weiweiweiopen/teensy-4-RGBgalvos/hardware/revB/preview/placement-top.png

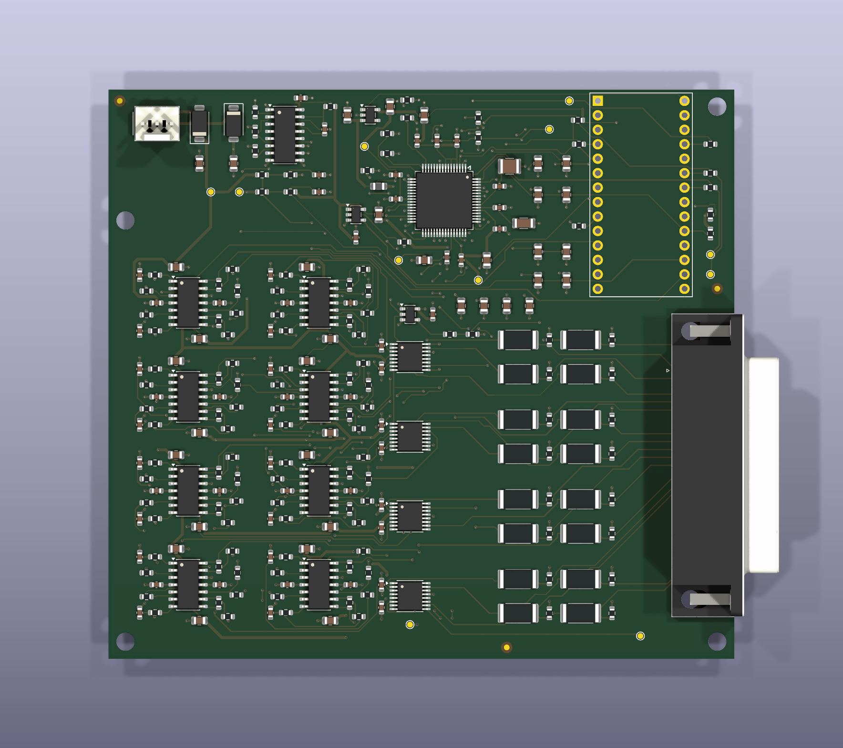
hardware/revB/preview/placement-top.png
