weiweiweiopen/teensy-4-RGBgalvos/hardware/revB/preview/floorplan.png

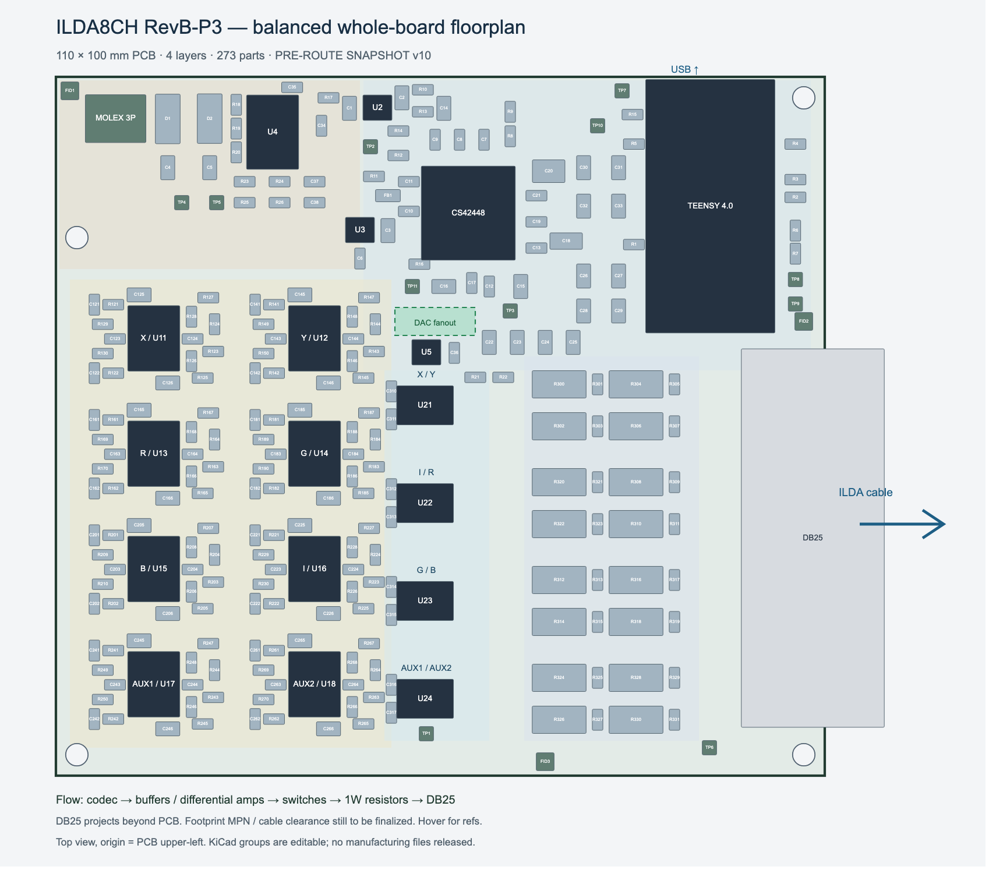
hardware/revB/preview/floorplan.png
