weiweiweiopen/teensy-4-RGBgalvos/hardware/revB/preview/kicad-pcb-editor.png

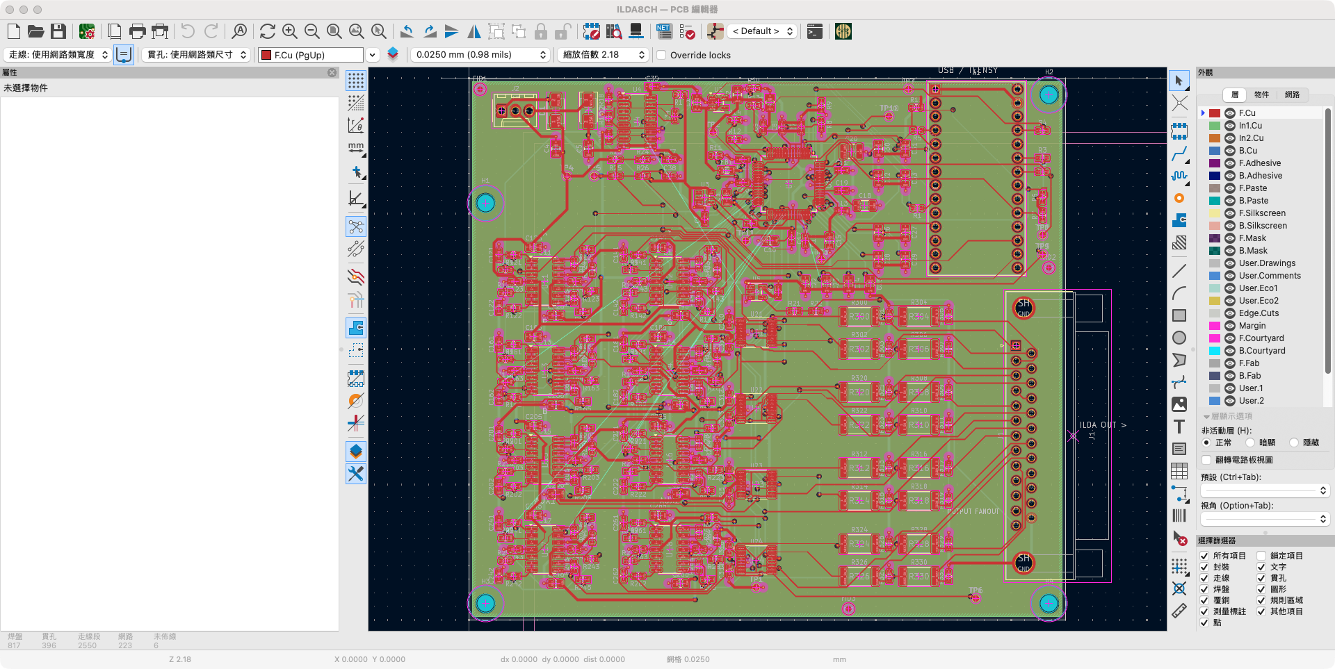
hardware/revB/preview/kicad-pcb-editor.png
