weiweiweiopen/teensy-4-RGBgalvos/hardware/revB/preview/power-eco-top.png

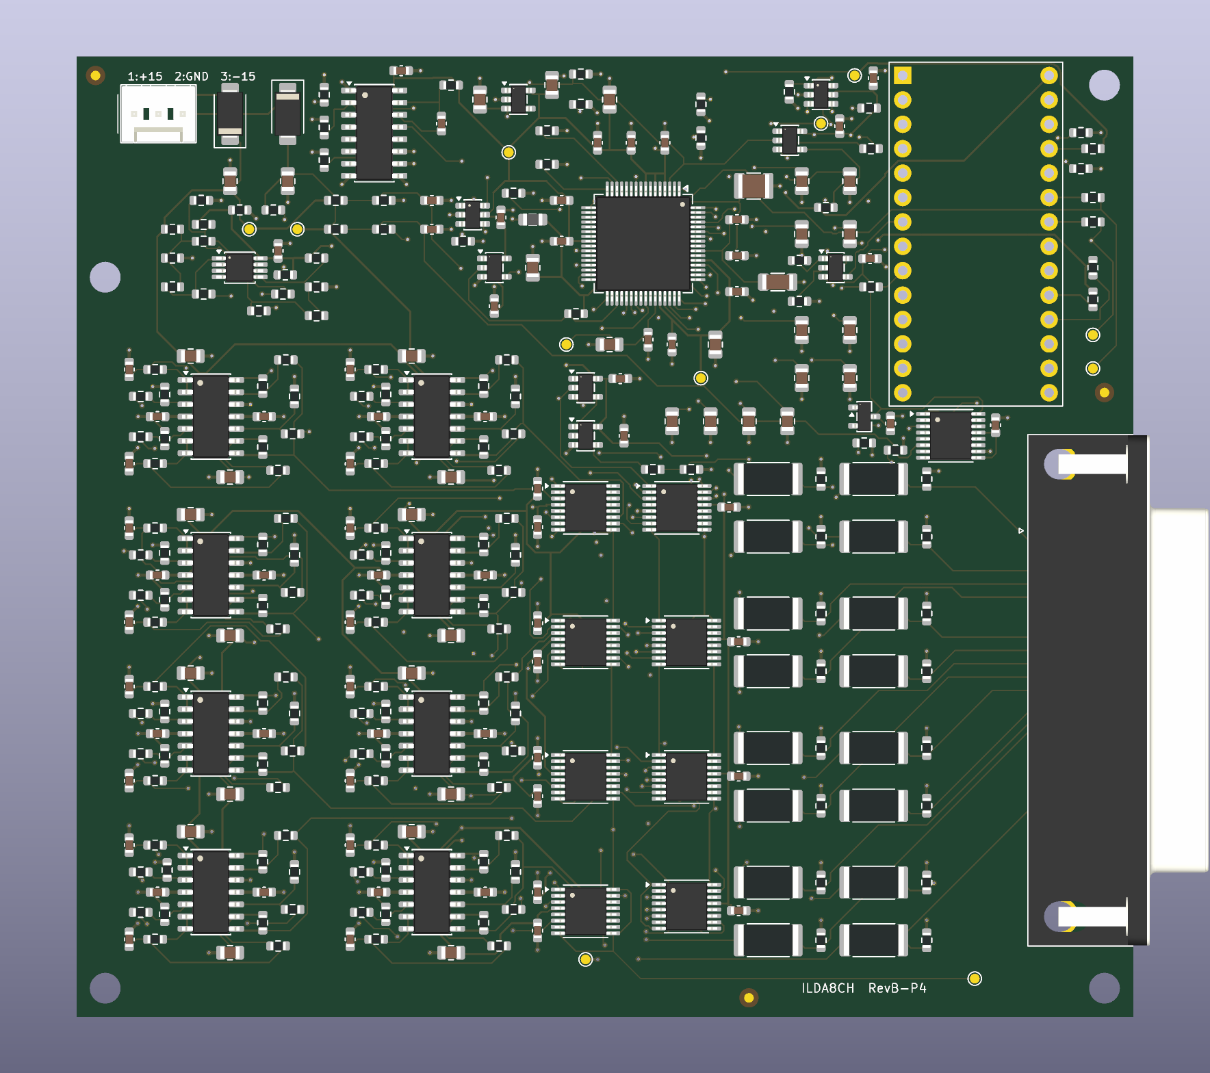
hardware/revB/preview/power-eco-top.png
