weiweiweiopen/teensy-4-RGBgalvos/hardware/revB/preview/routing-status.png

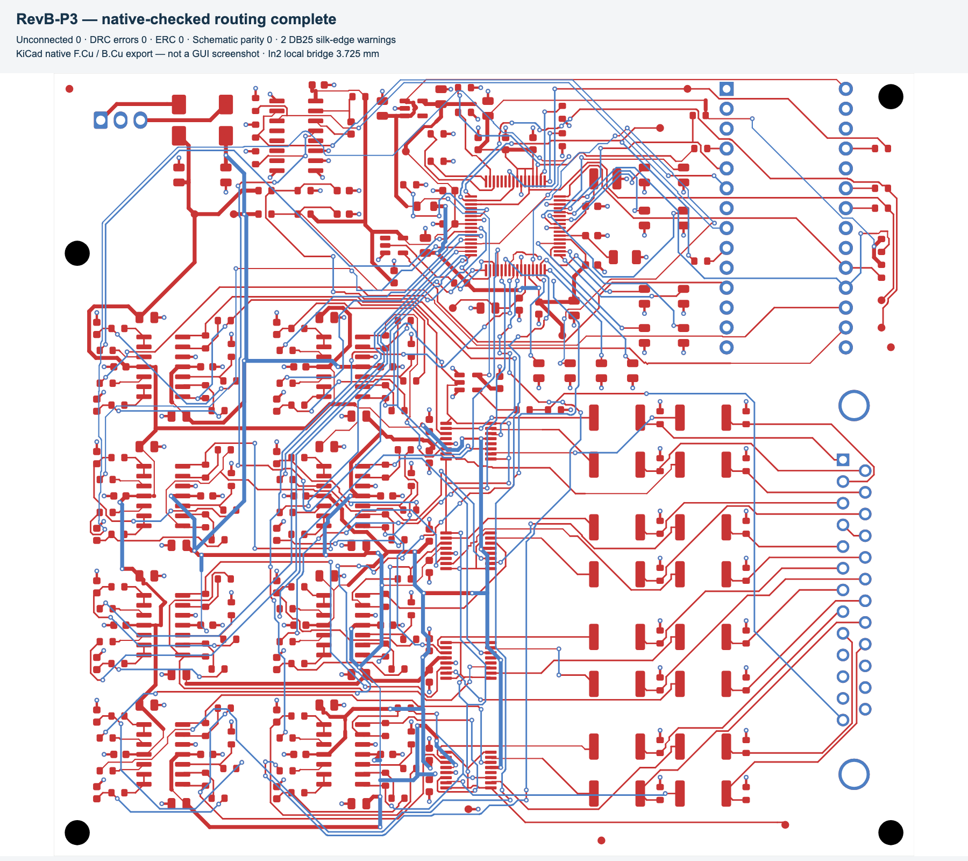
hardware/revB/preview/routing-status.png
