weiweiweiopen/teensy-4-RGBgalvos/hardware/revB/manufacturing/preflight-20261025-power-eco/assembly-DRAFT/JLC_BOM_DRAFT.csv

Comment | Designator | Footprint | LCSC Part #
100 / RC0603FR-07100RL | R1,R2,R3,R4,R5,R371,R372 | ILDA8CH:Resistor_SMD__R_0603_1608Metric | C105588
100 / RC2512FK-07100RL | R300,R302,R304,R306,R308,R310,R312,R314,R316,R318,R320,R322,R324,R326,R328,R330 | ILDA8CH:Resistor_SMD__R_2512_6332Metric | C309603
100k / RC0603FR-07100KL | R16,R129,R130,R149,R150,R169,R170,R189,R190,R209,R210,R229,R230,R249,R250,R269,R270,R301,R303,R305,R307,R309,R311,R313,R315,R317,R319,R321,R323,R325,R327,R329,R331,R17,R22,R23,R25,R352,R354,R357,R358,R360,R368,R369,R370 | ILDA8CH:Resistor_SMD__R_0603_1608Metric | C14675
100n / GRM188R71H104KA93D | C6,C7,C8,C9,C10,C11,C12,C13,C17,C19,C21,C123,C124,C143,C144,C163,C164,C183,C184,C203,C204,C223,C224,C243,C244,C263,C264,C310,C311,C312,C313,C314,C315,C316,C317,C34,C35,C36,C37,C38,C350,C351,C352,C353,C354,C355,C356,C357,C358,C359,C360,C361 | ILDA8CH:Capacitor_SMD__C_0603_1608Metric | C77055
100u / GRM32ER61A107ME20L | C20 | ILDA8CH:Capacitor_SMD__C_1210_3225Metric | C84455
10M / RC0603FR-0710ML | R355,R361,R401,R402,R403,R404,R405,R406,R407,R408,R409,R410,R411,R412,R413,R414,R415,R416 | ILDA8CH:Resistor_SMD__R_0603_1608Metric | C114606
10k / RT0603BRD0710KL | R8,R9,R10,R11,R12,R13,R14,R15,R127,R128,R147,R148,R167,R168,R187,R188,R207,R208,R227,R228,R247,R248,R267,R268,R20,R26,R362,R363 | ILDA8CH:Resistor_SMD__R_0603_1608Metric | C95204
10u / GRM21BR61E106KA73L | C1,C2,C3,C4,C5,C14,C15 | ILDA8CH:Capacitor_SMD__C_0805_2012Metric | C84416
150k / RC0603FR-07150KL | R353 | ILDA8CH:Resistor_SMD__R_0603_1608Metric | C114660
1M / RC0603FR-071ML | R350,R356 | ILDA8CH:Resistor_SMD__R_0603_1608Metric | C105578
1k / RT0603BRD071KL | R121,R122,R141,R142,R161,R162,R181,R182,R201,R202,R221,R222,R241,R242,R261,R262,R21,R367 | ILDA8CH:Resistor_SMD__R_0603_1608Metric | C110776
2.2k / RC0603FR-072K2L | R6,R7,R18,R19,R373 | ILDA8CH:Resistor_SMD__R_0603_1608Metric | C114662
200k / RC0603FR-07200KL | R351 | ILDA8CH:Resistor_SMD__R_0603_1608Metric | C105574
20k / RT0603BRD0720KL | R123,R125,R143,R145,R163,R164,R165,R166,R183,R184,R185,R186,R203,R204,R205,R206,R223,R224,R225,R226,R243,R244,R245,R246,R263,R264,R265,R266,R24 | ILDA8CH:Resistor_SMD__R_0603_1608Metric | C723637
22u / GRM31CR61E226KE15L | C18 | ILDA8CH:Capacitor_SMD__C_1206_3216Metric | C77091
330 / RC0603FR-07330RL | R366 | ILDA8CH:Resistor_SMD__R_0603_1608Metric | C105881
39k / RT0603BRD0739KL | R124,R126,R144,R146 | ILDA8CH:Resistor_SMD__R_0603_1608Metric | C309652
4.7k / RT0603BRD074K7L | R364,R365 | ILDA8CH:Resistor_SMD__R_0603_1608Metric | C513565
4.7n / GRM1885C1H472JA01D | C121,C122,C141,C142,C161,C162,C181,C182,C201,C202,C221,C222,C241,C242,C261,C262 | ILDA8CH:Capacitor_SMD__C_0603_1608Metric | C85980
4.7u / GRM21BR61E475KA12L | C16,C22,C23,C24,C25,C26,C27,C28,C29,C30,C31,C32,C33,C125,C126,C145,C146,C165,C166,C185,C186,C205,C206,C225,C226,C245,C246,C265,C266 | ILDA8CH:Capacitor_SMD__C_0805_2012Metric | C77077
45.3k / RC0603FR-0745K3L | R359 | ILDA8CH:Resistor_SMD__R_0603_1608Metric | C245971
600R@100MHz / BLM21PG601SN1D | FB1 | ILDA8CH:Inductor_SMD__L_0805_2012Metric | C41556732
ADG4613BRUZ / ADG4613BRUZ | U31,U32,U33,U34,U35 | ILDA8CH:Package_SO__TSSOP-16_4.4x5mm_P0.65mm | C657392
CD74HC123M96 / CD74HC123M96 | U4 | ILDA8CH:Package_SO__SOIC-16_3.9x9.9mm_P1.27mm | C133784
CS42448-CQZR / CS42448-CQZR | U1 | ILDA8CH:Package_QFP__LQFP-64_10x10mm_P0.5mm | C2151089
OPA4197IDR / OPA4197IDR | U11,U12,U13,U14,U15,U16,U17,U18 | ILDA8CH:Package_SO__SOIC-14_3.9x8.7mm_P1.27mm | C2058532
SN74AHCT1G125DBVR / SN74AHCT1G125DBVR | U5 | ILDA8CH:Package_TO_SOT_SMD__SOT-23-5 | C7484
SN74AHCT1G14DBVR / SN74AHCT1G14DBVR | U37 | ILDA8CH:Package_TO_SOT_SMD__SOT-23-5 | C55250
SN74LVC1G06DBVR / SN74LVC1G06DBVR | U9 | ILDA8CH:Package_TO_SOT_SMD__SOT-23-5 | C840103
SN74LVC1G08DBVR / SN74LVC1G08DBVR | U36 | ILDA8CH:Package_TO_SOT_SMD__SOT-23-5 | C7666
SN74LVC1G11DBVR / SN74LVC1G11DBVR | U7 | ILDA8CH:Package_TO_SOT_SMD__SOT-23-6 | C22046
SN74LVC1G175DBVR / SN74LVC1G175DBVR | U8 | ILDA8CH:Package_TO_SOT_SMD__SOT-23-6 | C128412
SN74LVC1G17DBVR / SN74LVC1G17DBVR | U3 | ILDA8CH:Package_TO_SOT_SMD__SOT-23-5 | C7836
SS14 / SS14 | D1,D2 | ILDA8CH:Diode_SMD__D_SMA | C2480
TLV3202AIDGKR / TLV3202AIDGKR | U6 | ILDA8CH:TI_DGK0008A_VSSOP8_3x3_P0.65_Land1.4x0.45 | C478075
TLV75533PDBVR / TLV75533PDBVR | U2 | ILDA8CH:Package_TO_SOT_SMD__SOT-23-5 | C404027
TMUX6212PWR / TMUX6212PWR | U21,U22,U23,U24 | ILDA8CH:Package_SO__TSSOP-16_4.4x5mm_P0.65mm | C2902526
TPS3839K33DBZR / TPS3839K33DBZR | U10 | ILDA8CH:Package_TO_SOT_SMD__SOT-23 | C96333
