weiweiweiopen/teensy-4-RGBgalvos/hardware/revB/preview/placement-coordinates.csv

Reference | Value | X_mm | Y_mm | Rotation_deg | Group | Locked
A1 | Teensy 4.0 | 86.0 | 2.0 | 0.0 | Control | False
C1 | 10u | 42.0 | 4.5 | 90.0 | Power | False
C10 | 100n | 50.5 | 19.25 | 180.0 | Codec | False
C11 | 100n | 50.5 | 15.0 | 180.0 | Codec | False
C12 | 100n | 62.0 | 30.0 | -90.0 | Codec | False
C121 | 4.7n | 5.5 | 32.6 | 90.0 | CH1_X | False
C122 | 4.7n | 5.5 | 42.4 | 90.0 | CH1_X | False
C123 | 100n | 8.45 | 37.5 | 180.0 | CH1_X | False
C124 | 100n | 19.55 | 37.5 | 180.0 | CH1_X | False
C125 | 4.7u | 11.9 | 31.2 | 0.0 | CH1_X | False
C126 | 4.7u | 16.0 | 43.8 | 0.0 | CH1_X | False
C13 | 100n | 68.75 | 24.5 | 0.0 | Codec | False
C14 | 10u | 55.5 | 4.5 | 90.0 | Codec | False
C141 | 4.7n | 28.5 | 32.6 | 90.0 | CH2_Y | False
C142 | 4.7n | 28.5 | 42.4 | 90.0 | CH2_Y | False
C143 | 100n | 31.45 | 37.5 | 180.0 | CH2_Y | False
C144 | 100n | 42.55 | 37.5 | 180.0 | CH2_Y | False
C145 | 4.7u | 34.9 | 31.2 | 0.0 | CH2_Y | False
C146 | 4.7u | 39.0 | 43.8 | 0.0 | CH2_Y | False
C15 | 10u | 66.5 | 30.0 | -90.0 | Codec | False
C16 | 4.7u | 55.5 | 30.0 | 180.0 | Codec | False
C161 | 4.7n | 5.5 | 49.1 | 90.0 | CH3_R | False
C162 | 4.7n | 5.5 | 58.9 | 90.0 | CH3_R | False
C163 | 100n | 8.45 | 54.0 | 180.0 | CH3_R | False
C164 | 100n | 19.55 | 54.0 | 180.0 | CH3_R | False
C165 | 4.7u | 11.9 | 47.7 | 0.0 | CH3_R | False
C166 | 4.7u | 16.0 | 60.3 | 0.0 | CH3_R | False
C17 | 100n | 59.5 | 29.5 | -90.0 | Codec | False
C18 | 22u | 73.0 | 23.5 | 0.0 | Codec | False
C181 | 4.7n | 28.5 | 49.1 | 90.0 | CH4_G | False
C182 | 4.7n | 28.5 | 58.9 | 90.0 | CH4_G | False
C183 | 100n | 31.45 | 54.0 | 180.0 | CH4_G | False
C184 | 100n | 42.55 | 54.0 | 180.0 | CH4_G | False
C185 | 4.7u | 34.9 | 47.7 | 0.0 | CH4_G | False
C186 | 4.7u | 39.0 | 60.3 | 0.0 | CH4_G | False
C19 | 100n | 68.75 | 20.75 | 0.0 | Codec | False
C2 | 10u | 49.5 | 3.0 | 90.0 | Power | False
C20 | 100u | 70.5 | 13.5 | 0.0 | Codec | False
C201 | 4.7n | 5.5 | 65.6 | 90.0 | CH5_B | False
C202 | 4.7n | 5.5 | 75.4 | 90.0 | CH5_B | False
C203 | 100n | 8.45 | 70.5 | 180.0 | CH5_B | False
C204 | 100n | 19.55 | 70.5 | 180.0 | CH5_B | False
C205 | 4.7u | 11.9 | 64.2 | 0.0 | CH5_B | False
C206 | 4.7u | 16.0 | 76.8 | 0.0 | CH5_B | False
C21 | 100n | 68.75 | 17.0 | 0.0 | Codec | False
C22 | 4.7u | 62.0 | 38.0 | -90.0 | Codec | False
C221 | 4.7n | 28.5 | 65.6 | 90.0 | CH6_I | False
C222 | 4.7n | 28.5 | 75.4 | 90.0 | CH6_I | False
C223 | 100n | 31.45 | 70.5 | 180.0 | CH6_I | False
C224 | 100n | 42.55 | 70.5 | 180.0 | CH6_I | False
C225 | 4.7u | 34.9 | 64.2 | 0.0 | CH6_I | False
C226 | 4.7u | 39.0 | 76.8 | 0.0 | CH6_I | False
C23 | 4.7u | 66.0 | 38.0 | -90.0 | Codec | False
C24 | 4.7u | 70.0 | 38.0 | -90.0 | Codec | False
C241 | 4.7n | 5.5 | 82.1 | 90.0 | CH7_AUX1 | False
C242 | 4.7n | 5.5 | 91.9 | 90.0 | CH7_AUX1 | False
C243 | 100n | 8.45 | 87.0 | 180.0 | CH7_AUX1 | False
C244 | 100n | 19.55 | 87.0 | 180.0 | CH7_AUX1 | False
C245 | 4.7u | 11.9 | 80.7 | 0.0 | CH7_AUX1 | False
C246 | 4.7u | 16.0 | 93.3 | 0.0 | CH7_AUX1 | False
C25 | 4.7u | 74.0 | 38.0 | -90.0 | Codec | False
C26 | 4.7u | 75.5 | 28.5 | -90.0 | Codec | False
C261 | 4.7n | 28.5 | 82.1 | 90.0 | CH8_AUX2 | False
C262 | 4.7n | 28.5 | 91.9 | 90.0 | CH8_AUX2 | False
C263 | 100n | 31.45 | 87.0 | 180.0 | CH8_AUX2 | False
C264 | 100n | 42.55 | 87.0 | 180.0 | CH8_AUX2 | False
C265 | 4.7u | 34.9 | 80.7 | 0.0 | CH8_AUX2 | False
C266 | 4.7u | 39.0 | 93.3 | 0.0 | CH8_AUX2 | False
C27 | 4.7u | 80.5 | 28.5 | -90.0 | Codec | False
C28 | 4.7u | 75.5 | 33.5 | -90.0 | Codec | False
C29 | 4.7u | 80.5 | 33.5 | -90.0 | Codec | False
C3 | 10u | 47.5 | 22.0 | 90.0 | Power | False
C30 | 4.7u | 75.5 | 13.0 | -90.0 | Codec | False
C31 | 4.7u | 80.5 | 13.0 | -90.0 | Codec | False
C310 | 100n | 48.0 | 45.0 | 90.0 | Outputs | False
C311 | 100n | 48.0 | 49.0 | 90.0 | Outputs | False
C312 | 100n | 48.0 | 59.0 | 90.0 | Outputs | False
C313 | 100n | 48.0 | 63.0 | 90.0 | Outputs | False
C314 | 100n | 48.0 | 73.0 | 90.0 | Outputs | False
C315 | 100n | 48.0 | 77.0 | 90.0 | Outputs | False
C316 | 100n | 48.0 | 87.0 | 90.0 | Outputs | False
C317 | 100n | 48.0 | 91.0 | 90.0 | Outputs | False
C32 | 4.7u | 75.5 | 18.5 | -90.0 | Codec | False
C33 | 4.7u | 80.5 | 18.5 | -90.0 | Codec | False
C34 | 100n | 38.0 | 7.0 | 90.0 | Control | False
C35 | 100n | 33.8 | 1.5 | 0.0 | Control | False
C36 | 100n | 57.0 | 39.5 | 90.0 | Control | False
C37 | 100n | 37.0 | 15.0 | 0.0 | Power | False
C38 | 100n | 37.0 | 18.0 | 0.0 | Power | False
C4 | 10u | 16.0 | 13.0 | 90.0 | Power | False
C5 | 10u | 22.0 | 13.0 | 90.0 | Power | False
C6 | 100n | 43.5 | 26.0 | 90.0 | Control | False
C7 | 100n | 61.25 | 9.0 | 90.0 | Codec | False
C8 | 100n | 57.75 | 9.0 | 90.0 | Codec | False
C9 | 100n | 54.25 | 9.0 | 90.0 | Codec | False
D1 | SS14 | 16.0 | 6.0 | 90.0 | Power | False
D2 | SS14 | 22.0 | 6.0 | -90.0 | Power | False
FB1 | 600R@100MHz | 47.5 | 17.0 | 0.0 | Power | False
FID1 | FIDUCIAL | 2.0 | 2.0 | 0.0 | Power | False
FID2 | FIDUCIAL | 107.0 | 35.0 | 0.0 | Power | False
FID3 | FIDUCIAL | 70.0 | 98.0 | 0.0 | Power | False
H1 | M3 NPTH | 3.0 | 23.0 | 0.0 | Power | False
H2 | M3 NPTH | 107.0 | 3.0 | 0.0 | Power | False
H3 | M3 NPTH | 3.0 | 97.0 | 0.0 | Power | False
H4 | M3 NPTH | 107.0 | 97.0 | 0.0 | Power | False
J1 | ILDA DB25 FEMALE | 100.88 | 49.38 | 90.0 | Outputs | False
J2 | Molex KK-254 3P +/-15V | 6.0 | 6.0 | 0.0 | Power | False
R1 | 100 | 82.7 | 24.0 | 180.0 | Control | False
R10 | 10k | 52.5 | 1.85 | 0.0 | Codec | False
R11 | 10k | 45.5 | 14.25 | 0.0 | Codec | False
R12 | 10k | 49.0 | 11.25 | 0.0 | Codec | False
R121 | 1k | 8.2 | 32.6 | 180.0 | CH1_X | False
R122 | 1k | 8.2 | 42.4 | 180.0 | CH1_X | False
R123 | 20k | 22.5 | 39.3 | 180.0 | CH1_X | False
R124 | 39k | 22.7 | 35.4 | 90.0 | CH1_X | False
R125 | 20k | 21.0 | 43.1 | 180.0 | CH1_X | False
R126 | 39k | 19.4 | 40.675 | 90.0 | CH1_X | False
R127 | 10k | 21.8 | 31.6 | 180.0 | CH1_X | False
R128 | 10k | 19.4 | 34.325 | -90.0 | CH1_X | False
R129 | 100k | 6.7 | 35.4 | 0.0 | CH1_X | False
R13 | 10k | 52.5 | 5.0 | 0.0 | Codec | False
R130 | 100k | 6.7 | 39.6 | 0.0 | CH1_X | False
R14 | 10k | 49.0 | 7.75 | 0.0 | Codec | False
R141 | 1k | 31.2 | 32.6 | 180.0 | CH2_Y | False
R142 | 1k | 31.2 | 42.4 | 180.0 | CH2_Y | False
R143 | 20k | 45.5 | 39.3 | 180.0 | CH2_Y | False
R144 | 39k | 45.7 | 35.4 | 90.0 | CH2_Y | False
R145 | 20k | 44.0 | 43.1 | 180.0 | CH2_Y | False
R146 | 39k | 42.4 | 40.675 | 90.0 | CH2_Y | False
R147 | 10k | 44.8 | 31.6 | 180.0 | CH2_Y | False
R148 | 10k | 42.4 | 34.325 | -90.0 | CH2_Y | False
R149 | 100k | 29.7 | 35.4 | 0.0 | CH2_Y | False
R15 | 10k | 82.5 | 5.4 | 0.0 | Codec | False
R150 | 100k | 29.7 | 39.6 | 0.0 | CH2_Y | False
R16 | 100k | 52.0 | 26.8 | 0.0 | Codec | False
R161 | 1k | 8.2 | 49.1 | 180.0 | CH3_R | False
R162 | 1k | 8.2 | 58.9 | 180.0 | CH3_R | False
R163 | 20k | 22.5 | 55.8 | 180.0 | CH3_R | False
R164 | 20k | 22.7 | 51.9 | 90.0 | CH3_R | False
R165 | 20k | 21.0 | 59.6 | 180.0 | CH3_R | False
R166 | 20k | 19.4 | 57.175 | 90.0 | CH3_R | False
R167 | 10k | 21.8 | 48.1 | 180.0 | CH3_R | False
R168 | 10k | 19.4 | 50.825 | -90.0 | CH3_R | False
R169 | 100k | 6.7 | 51.9 | 0.0 | CH3_R | False
R17 | 100k | 39.0 | 3.0 | 180.0 | Control | False
R170 | 100k | 6.7 | 56.1 | 0.0 | CH3_R | False
R18 | 100k | 25.8 | 4.0 | 90.0 | Control | False
R181 | 1k | 31.2 | 49.1 | 180.0 | CH4_G | False
R182 | 1k | 31.2 | 58.9 | 180.0 | CH4_G | False
R183 | 20k | 45.5 | 55.8 | 180.0 | CH4_G | False
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
R327 | 100k | 77.5 | 92.0 | 90.0 | Outputs | False
R328 | 100 | 83.0 | 86.0 | 0.0 | Outputs | False
R329 | 100k | 88.5 | 86.0 | 90.0 | Outputs | False
R330 | 100 | 83.0 | 92.0 | 0.0 | Outputs | False
R331 | 100k | 88.5 | 92.0 | 90.0 | Outputs | False
R4 | 100 | 105.8 | 9.62 | 0.0 | Control | False
R5 | 100 | 82.7 | 9.62 | 180.0 | Control | False
R6 | 2.2k | 105.8 | 22.0 | 90.0 | Control | False
R7 | 2.2k | 105.8 | 25.3 | 90.0 | Control | False
R8 | 10k | 65.0 | 8.5 | -90.0 | Codec | False
R9 | 10k | 65.0 | 5.0 | -90.0 | Codec | False
TP1 | GND | 53.0 | 94.0 | 0.0 | Control | False
TP10 | TDM_TX | 77.5 | 7.0 | 0.0 | Control | False
TP11 | VQ | 51.0 | 30.0 | 0.0 | Control | False
TP2 | +3V3 | 45.0 | 10.0 | 0.0 | Control | False
TP3 | +5VA | 65.0 | 33.5 | 0.0 | Control | False
TP4 | +15A | 18.0 | 18.0 | 0.0 | Control | False
TP5 | -15A | 23.0 | 18.0 | 0.0 | Control | False
TP6 | RUN_ENABLE | 93.5 | 96.0 | 0.0 | Control | False
TP7 | MCLK | 81.0 | 2.0 | 0.0 | Control | False
TP8 | LRCLK | 105.8 | 29.0 | 0.0 | Control | False
TP9 | BCLK | 105.8 | 32.5 | 0.0 | Control | False
U1 | CS42448-CQZR | 59.0 | 19.5 | -90.0 | Codec | False
U11 | OPA4197IDR | 14.0 | 37.5 | 0.0 | CH1_X | False
U12 | OPA4197IDR | 37.0 | 37.5 | 0.0 | CH2_Y | False
U13 | OPA4197IDR | 14.0 | 54.0 | 0.0 | CH3_R | False
U14 | OPA4197IDR | 37.0 | 54.0 | 0.0 | CH4_G | False
U15 | OPA4197IDR | 14.0 | 70.5 | 0.0 | CH5_B | False
U16 | OPA4197IDR | 37.0 | 70.5 | 0.0 | CH6_I | False
U17 | OPA4197IDR | 14.0 | 87.0 | 0.0 | CH7_AUX1 | False
U18 | OPA4197IDR | 37.0 | 87.0 | 0.0 | CH8_AUX2 | False
U2 | TLV75533PDBVR | 46.0 | 4.5 | 0.0 | Power | False
U21 | TMUX6212PWR | 53.0 | 47.0 | 0.0 | Outputs | False
U22 | TMUX6212PWR | 53.0 | 61.0 | 0.0 | Outputs | False
U23 | TMUX6212PWR | 53.0 | 75.0 | 0.0 | Outputs | False
U24 | TMUX6212PWR | 53.0 | 89.0 | 0.0 | Outputs | False
U3 | SN74LVC1G17DBVR | 43.5 | 22.0 | 0.0 | Control | False
U4 | CD74HC123M96 | 31.0 | 8.0 | 0.0 | Control | False
U5 | SN74AHCT1G125DBVR | 53.0 | 39.5 | 0.0 | Control | False
