weiweiweiopen/teensy-4-RGBgalvos/hardware/revB/QA/completion.md

# RevB-P4 電氣ECO及連接完成

PCB `19c24b7b0cacdd23822d85daa3e44d5104a866f5a9f83ac38824fee33554cd69`；native errors/unconnected/ERC/parity均0。

詳見 [ECO審查](power-eco-review.md)。正式製造仍HOLD。
