weiweiweiopen/teensy-4-RGBgalvos/(list of files, drawings)

Other design files:
hardware/revA/QA/pcb-analysis.json
hardware/revA/QA/schematic-analysis.json
hardware/revA/routing/attempt-20261024-114159/ILDA8CH.dsn
hardware/revA/routing/attempt-20261024-124038/ILDA8CH.dsn
hardware/revA/routing/ILDA8CH.dsn
hardware/revB/QA/power-eco-analysis/schematic-delta.json
