weiweiweiopen/teensy-4-RGBgalvos/hardware/revB/KiCad/ILDA8CH.kicad_pcb

## KiCad design hardware/revB/KiCad/ILDA8CH.kicad_pcb (2026-10-30)

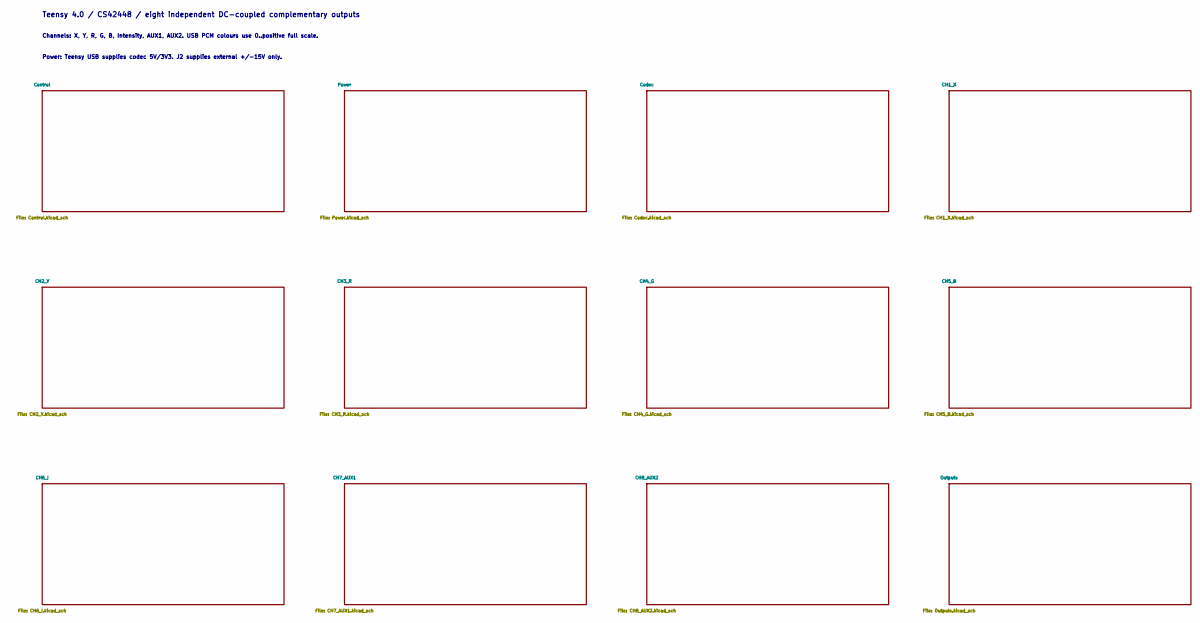
[picture p6: schematic ILDA8CH.kicad_sch, ILDA8CH RevB-P4 / Index]

Notes on the sheet:
Channels: X, Y, R, G, B, Intensity, AUX1, AUX2. USB PCM colours use 0..positive full scale.
Teensy 4.0 / CS42448 / eight independent DC-coupled complementary outputs
Power: Teensy USB supplies codec 5V/3V3. J2 supplies external +/-15V only.

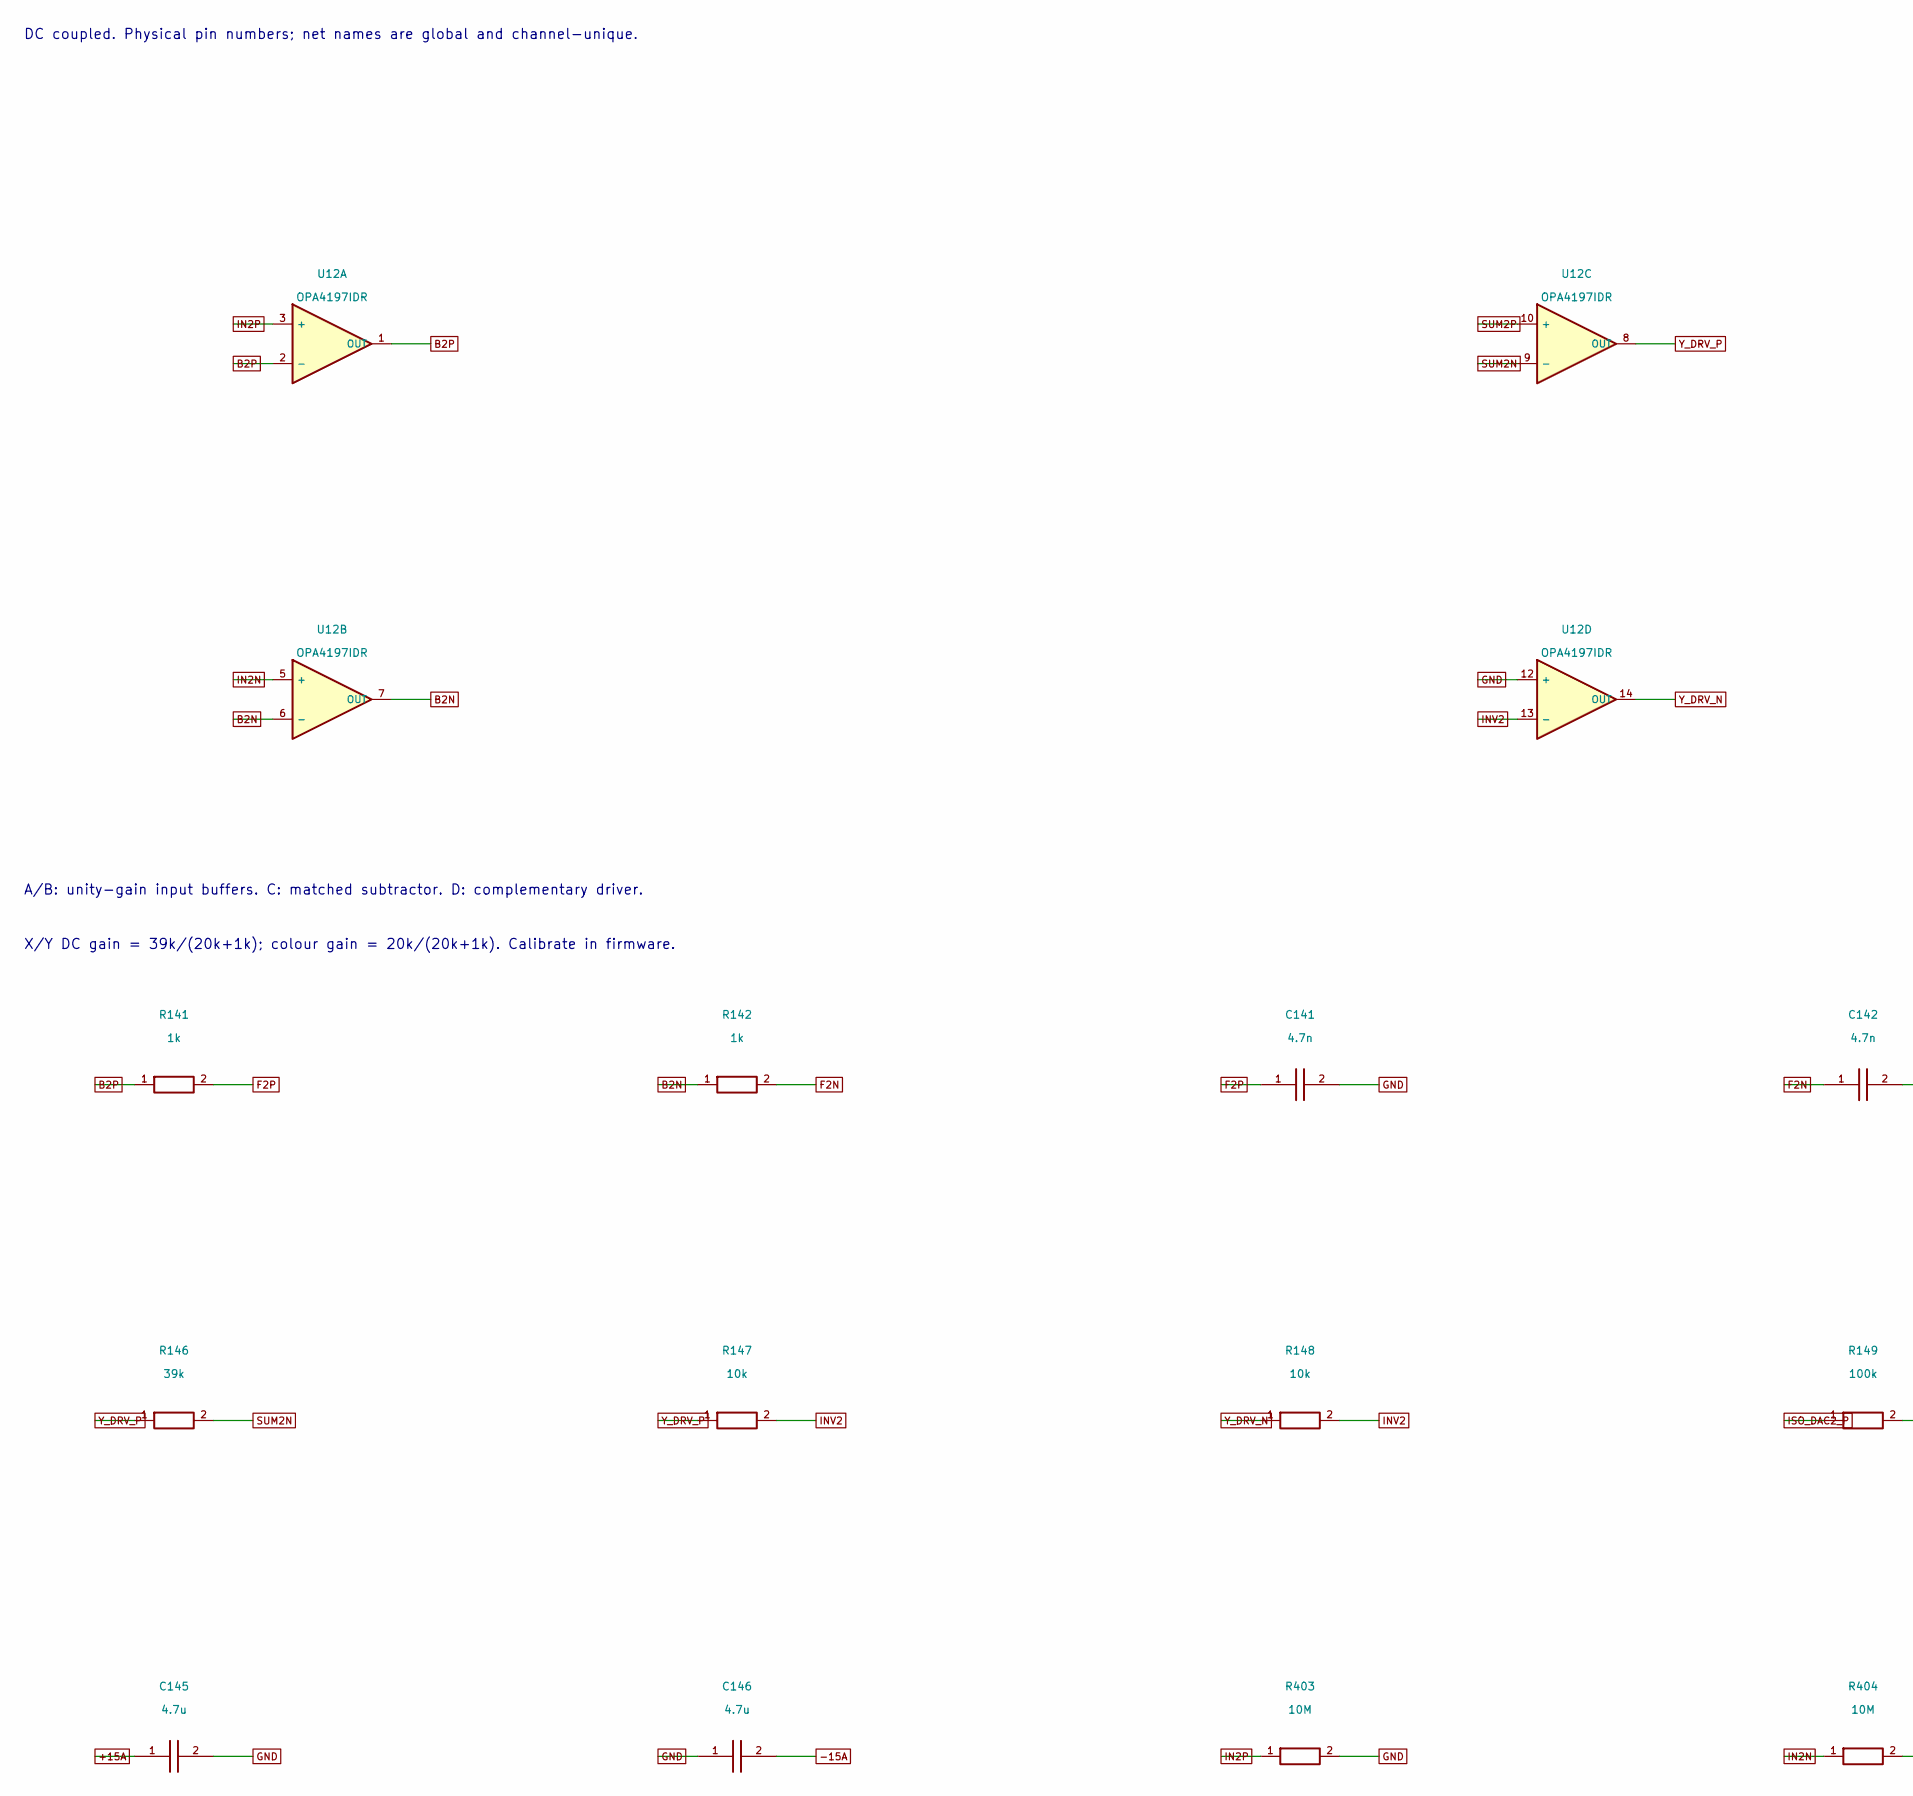
[picture p7: schematic CH2_Y.kicad_sch, ILDA8CH RevB-P4 / CH2_Y, part in row 1, column 1]

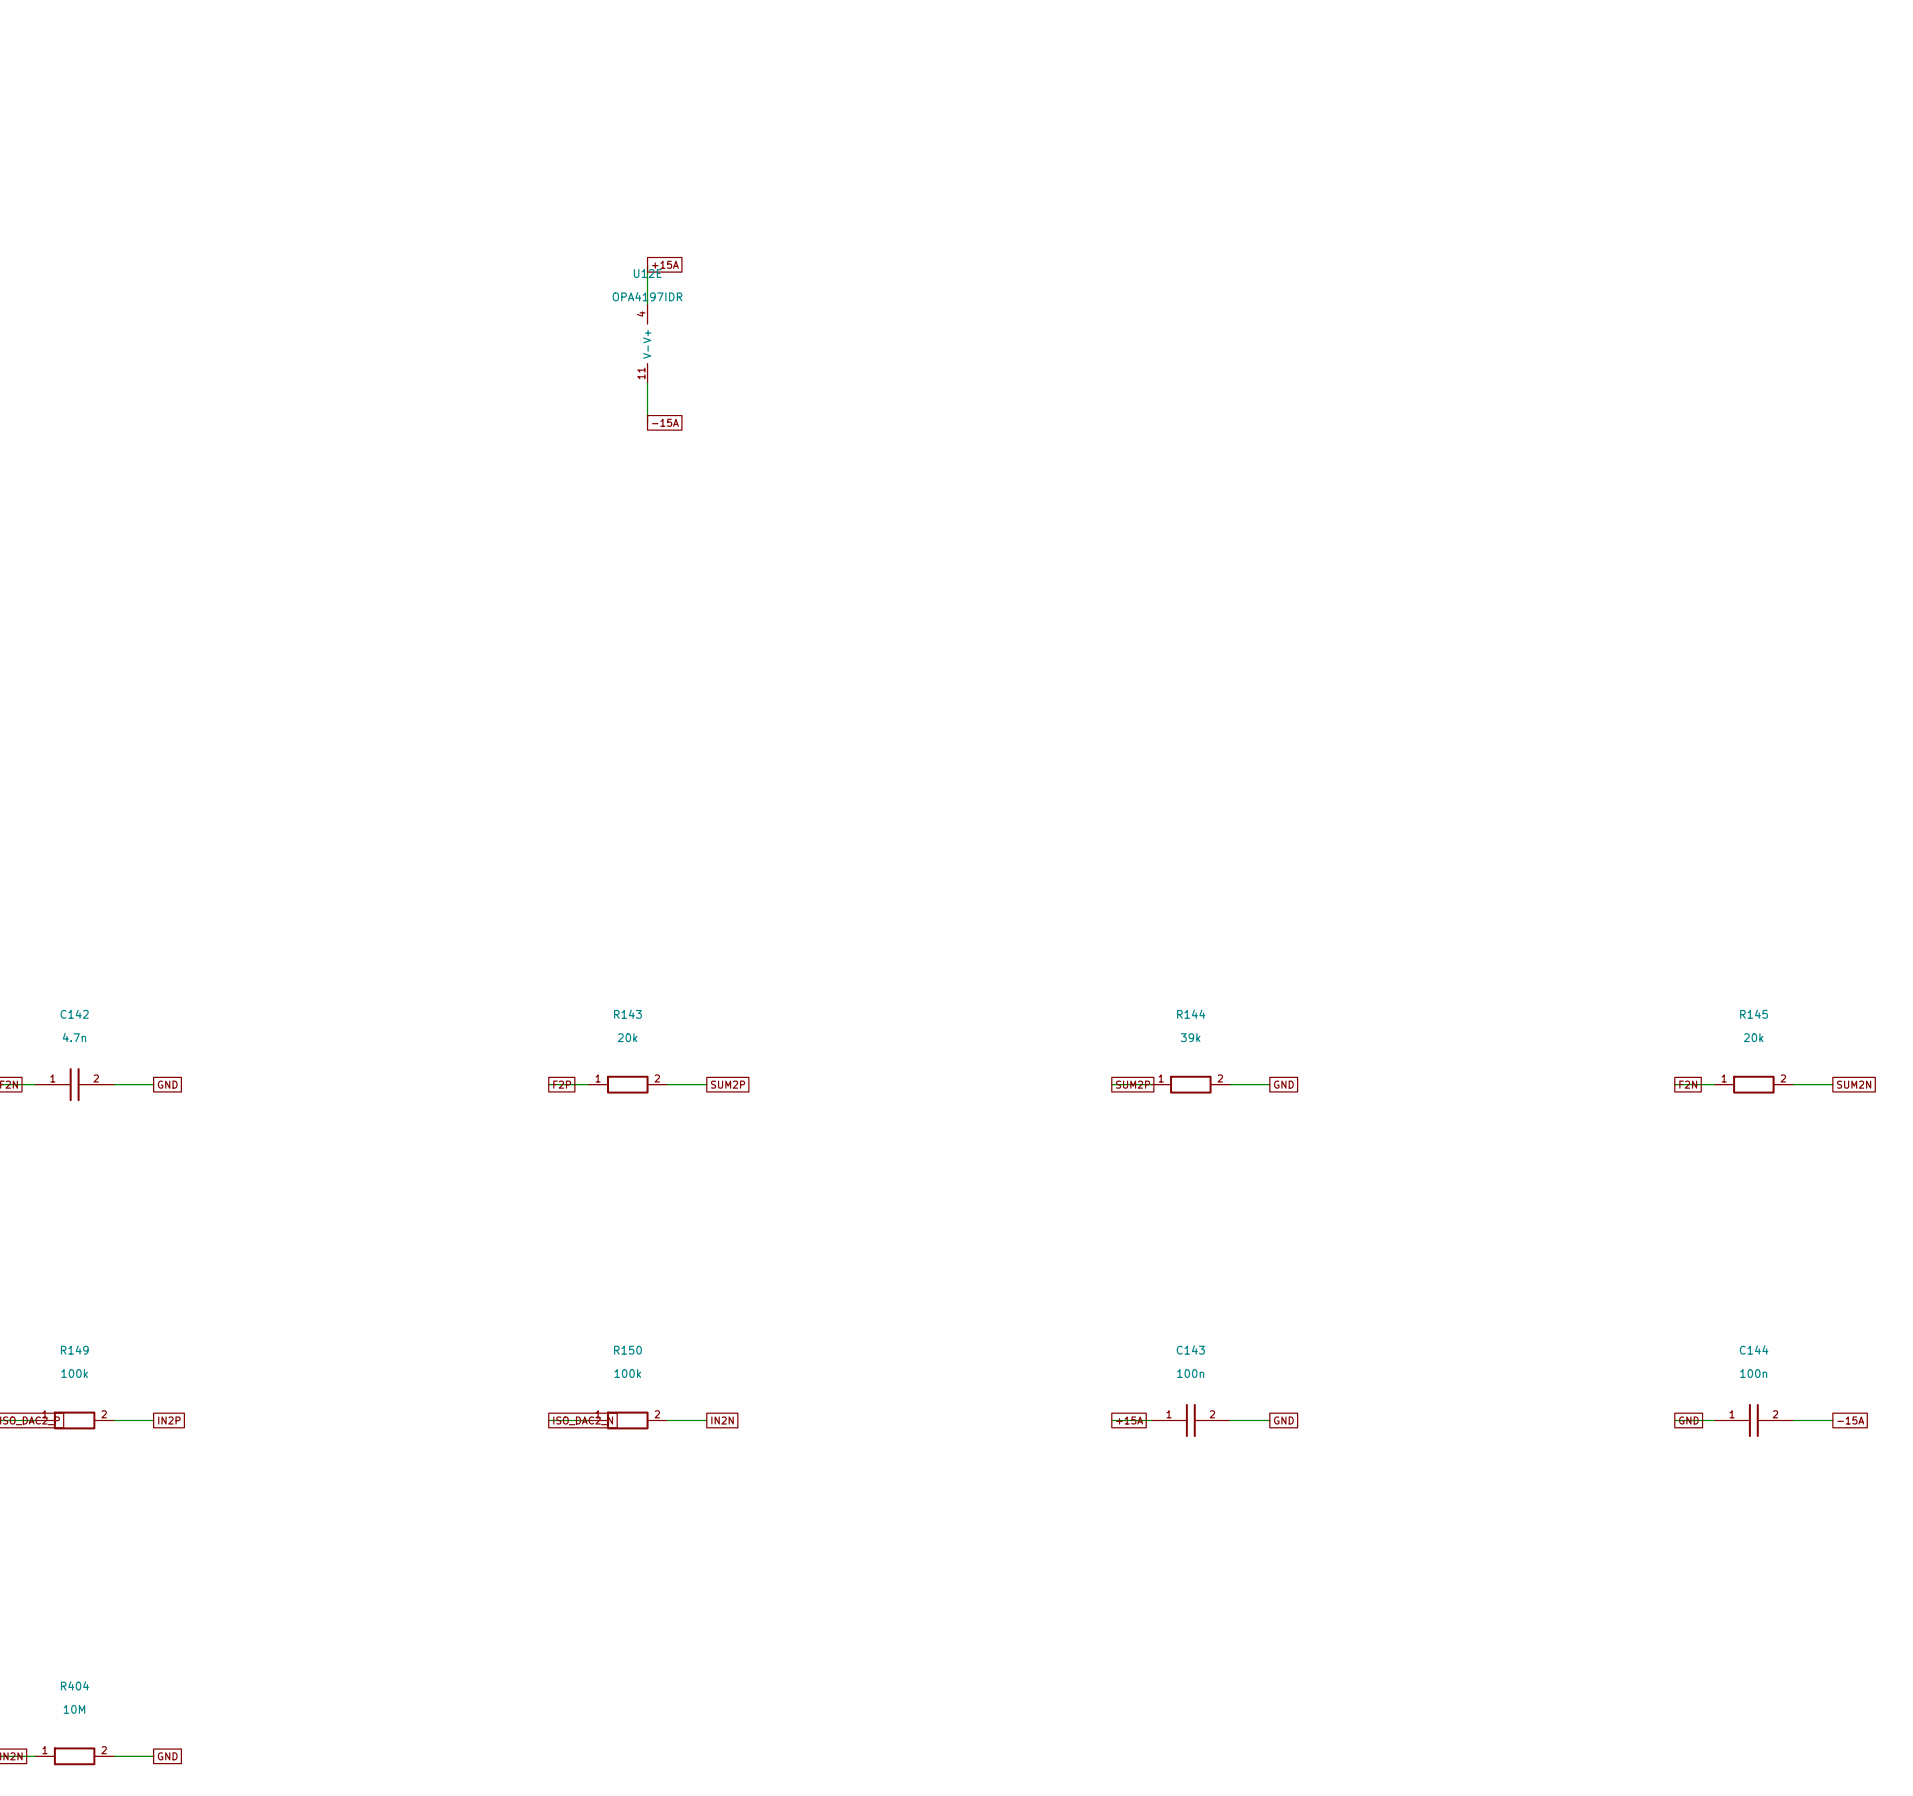
[picture p8: schematic CH2_Y.kicad_sch, ILDA8CH RevB-P4 / CH2_Y, part in row 1, column 2]

Parts:
C141, C142: 4.7n; Capacitor_SMD__C_0603_1608Metric; MPN GRM1885C1H472JA01D; LCSC C85980
C143, C144: 100n; Capacitor_SMD__C_0603_1608Metric; MPN GRM188R71H104KA93D; LCSC C77055
C145, C146: 4.7u; Capacitor_SMD__C_0805_2012Metric; MPN GRM21BR61E475KA12L; LCSC C77077
R141, R142: 1k; Resistor_SMD__R_0603_1608Metric; MPN RT0603BRD071KL; LCSC C110776
R143, R145: 20k; Resistor_SMD__R_0603_1608Metric; MPN RT0603BRD0720KL; LCSC C723637
R144, R146: 39k; Resistor_SMD__R_0603_1608Metric; MPN RT0603BRD0739KL; LCSC C309652
R147, R148: 10k; Resistor_SMD__R_0603_1608Metric; MPN RT0603BRD0710KL; LCSC C95204
R149, R150: 100k; Resistor_SMD__R_0603_1608Metric; MPN RC0603FR-07100KL; LCSC C14675
R403, R404: 10M; Resistor_SMD__R_0603_1608Metric; MPN RC0603FR-0710ML; LCSC C114606
U12: OPA4197IDR; Package_SO__SOIC-14_3.9x8.7mm_P1.27mm; MPN OPA4197IDR; LCSC C2058532

Connections:
+15A: C143.1, C145.1, U12.4 (V+); also elsewhere on the board
-15A: C144.2, C146.2, U12.11 (V-); also elsewhere on the board
B2N: R142.1, U12.6 (-), U12.7 (OUT)
B2P: R141.1, U12.1 (OUT), U12.2 (-)
F2N: C142.1, R142.2, R145.1
F2P: C141.1, R141.2, R143.1
GND: C141.2, C142.2, C143.2, C144.1, C145.2, C146.1, R144.2, R403.2, R404.2, U12.12 (+); also elsewhere on the board
IN2N: R150.2, R404.1, U12.5 (+)
IN2P: R149.2, R403.1, U12.3 (+)
INV2: R147.2, R148.2, U12.13 (-)
ISO_DAC2_N: R150.1; also elsewhere on the board
ISO_DAC2_P: R149.1; also elsewhere on the board
SUM2N: R145.2, R146.2, U12.9 (-)
SUM2P: R143.2, R144.1, U12.10 (+)
Y_DRV_N: R148.1, U12.14 (OUT); also elsewhere on the board
Y_DRV_P: R146.1, R147.1, U12.8 (OUT); also elsewhere on the board

Notes on the sheet:
DC coupled. Physical pin numbers; net names are global and channel-unique.
X/Y DC gain = 39k/(20k+1k); colour gain = 20k/(20k+1k). Calibrate in firmware.
A/B: unity-gain input buffers. C: matched subtractor. D: complementary driver.

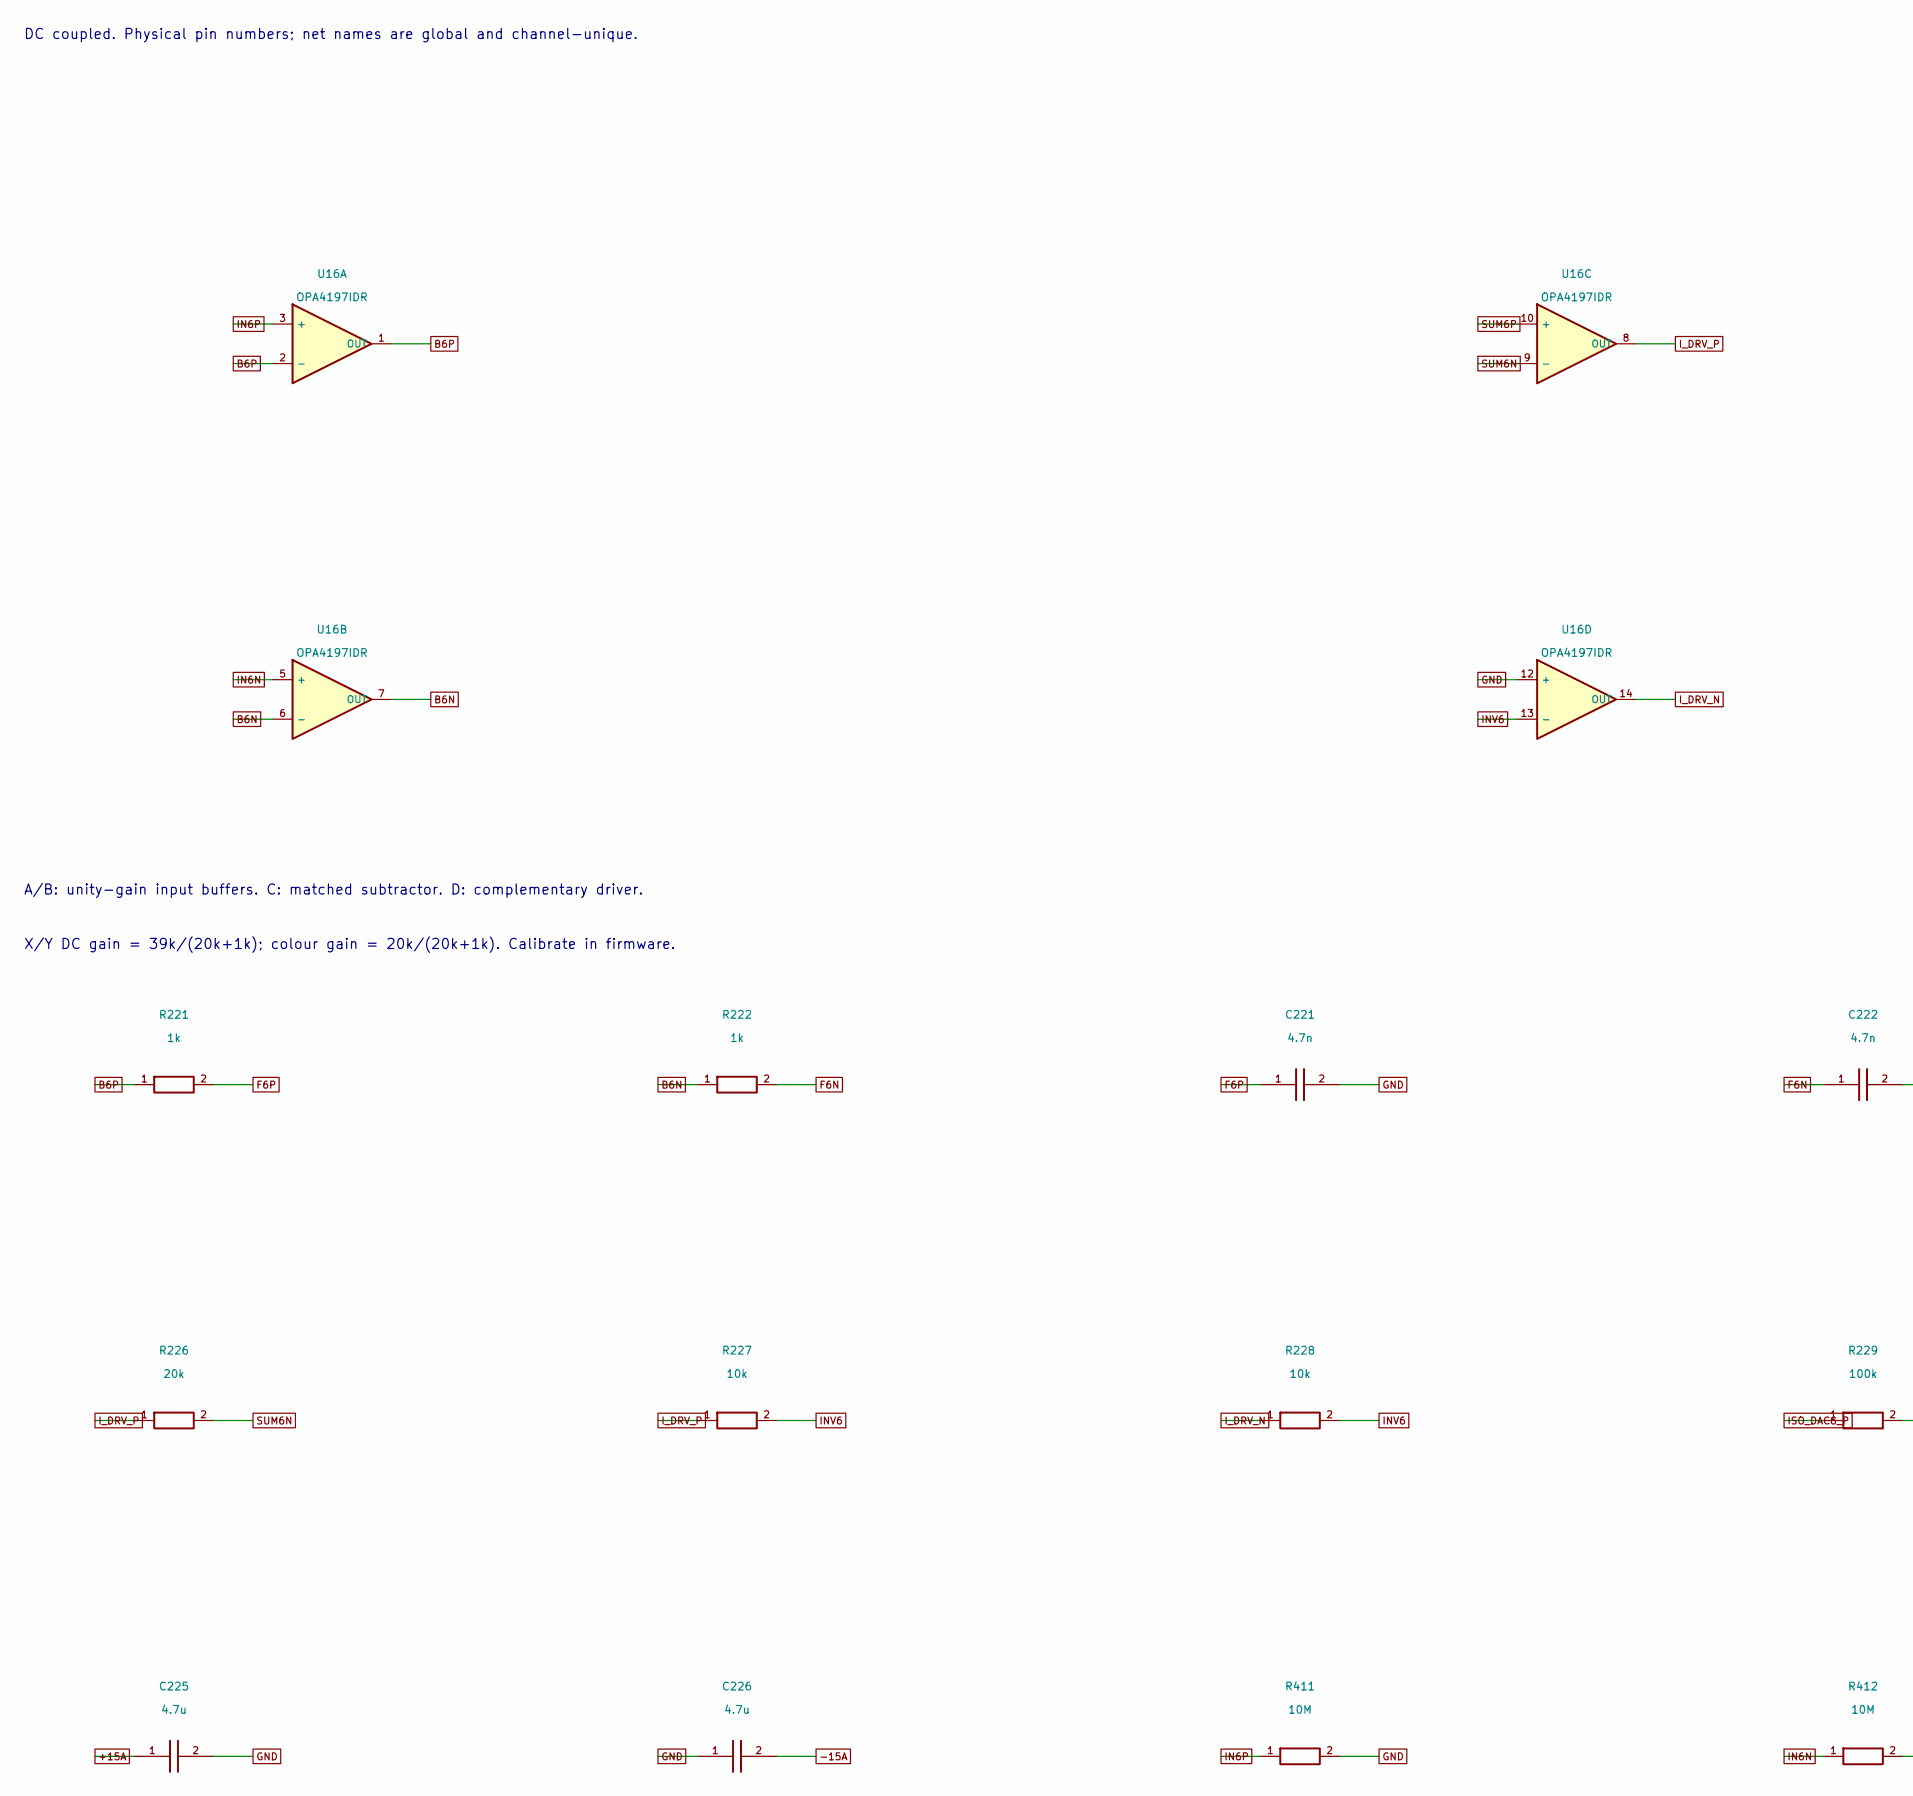
[picture p9: schematic CH6_I.kicad_sch, ILDA8CH RevB-P4 / CH6_I, part in row 1, column 1]

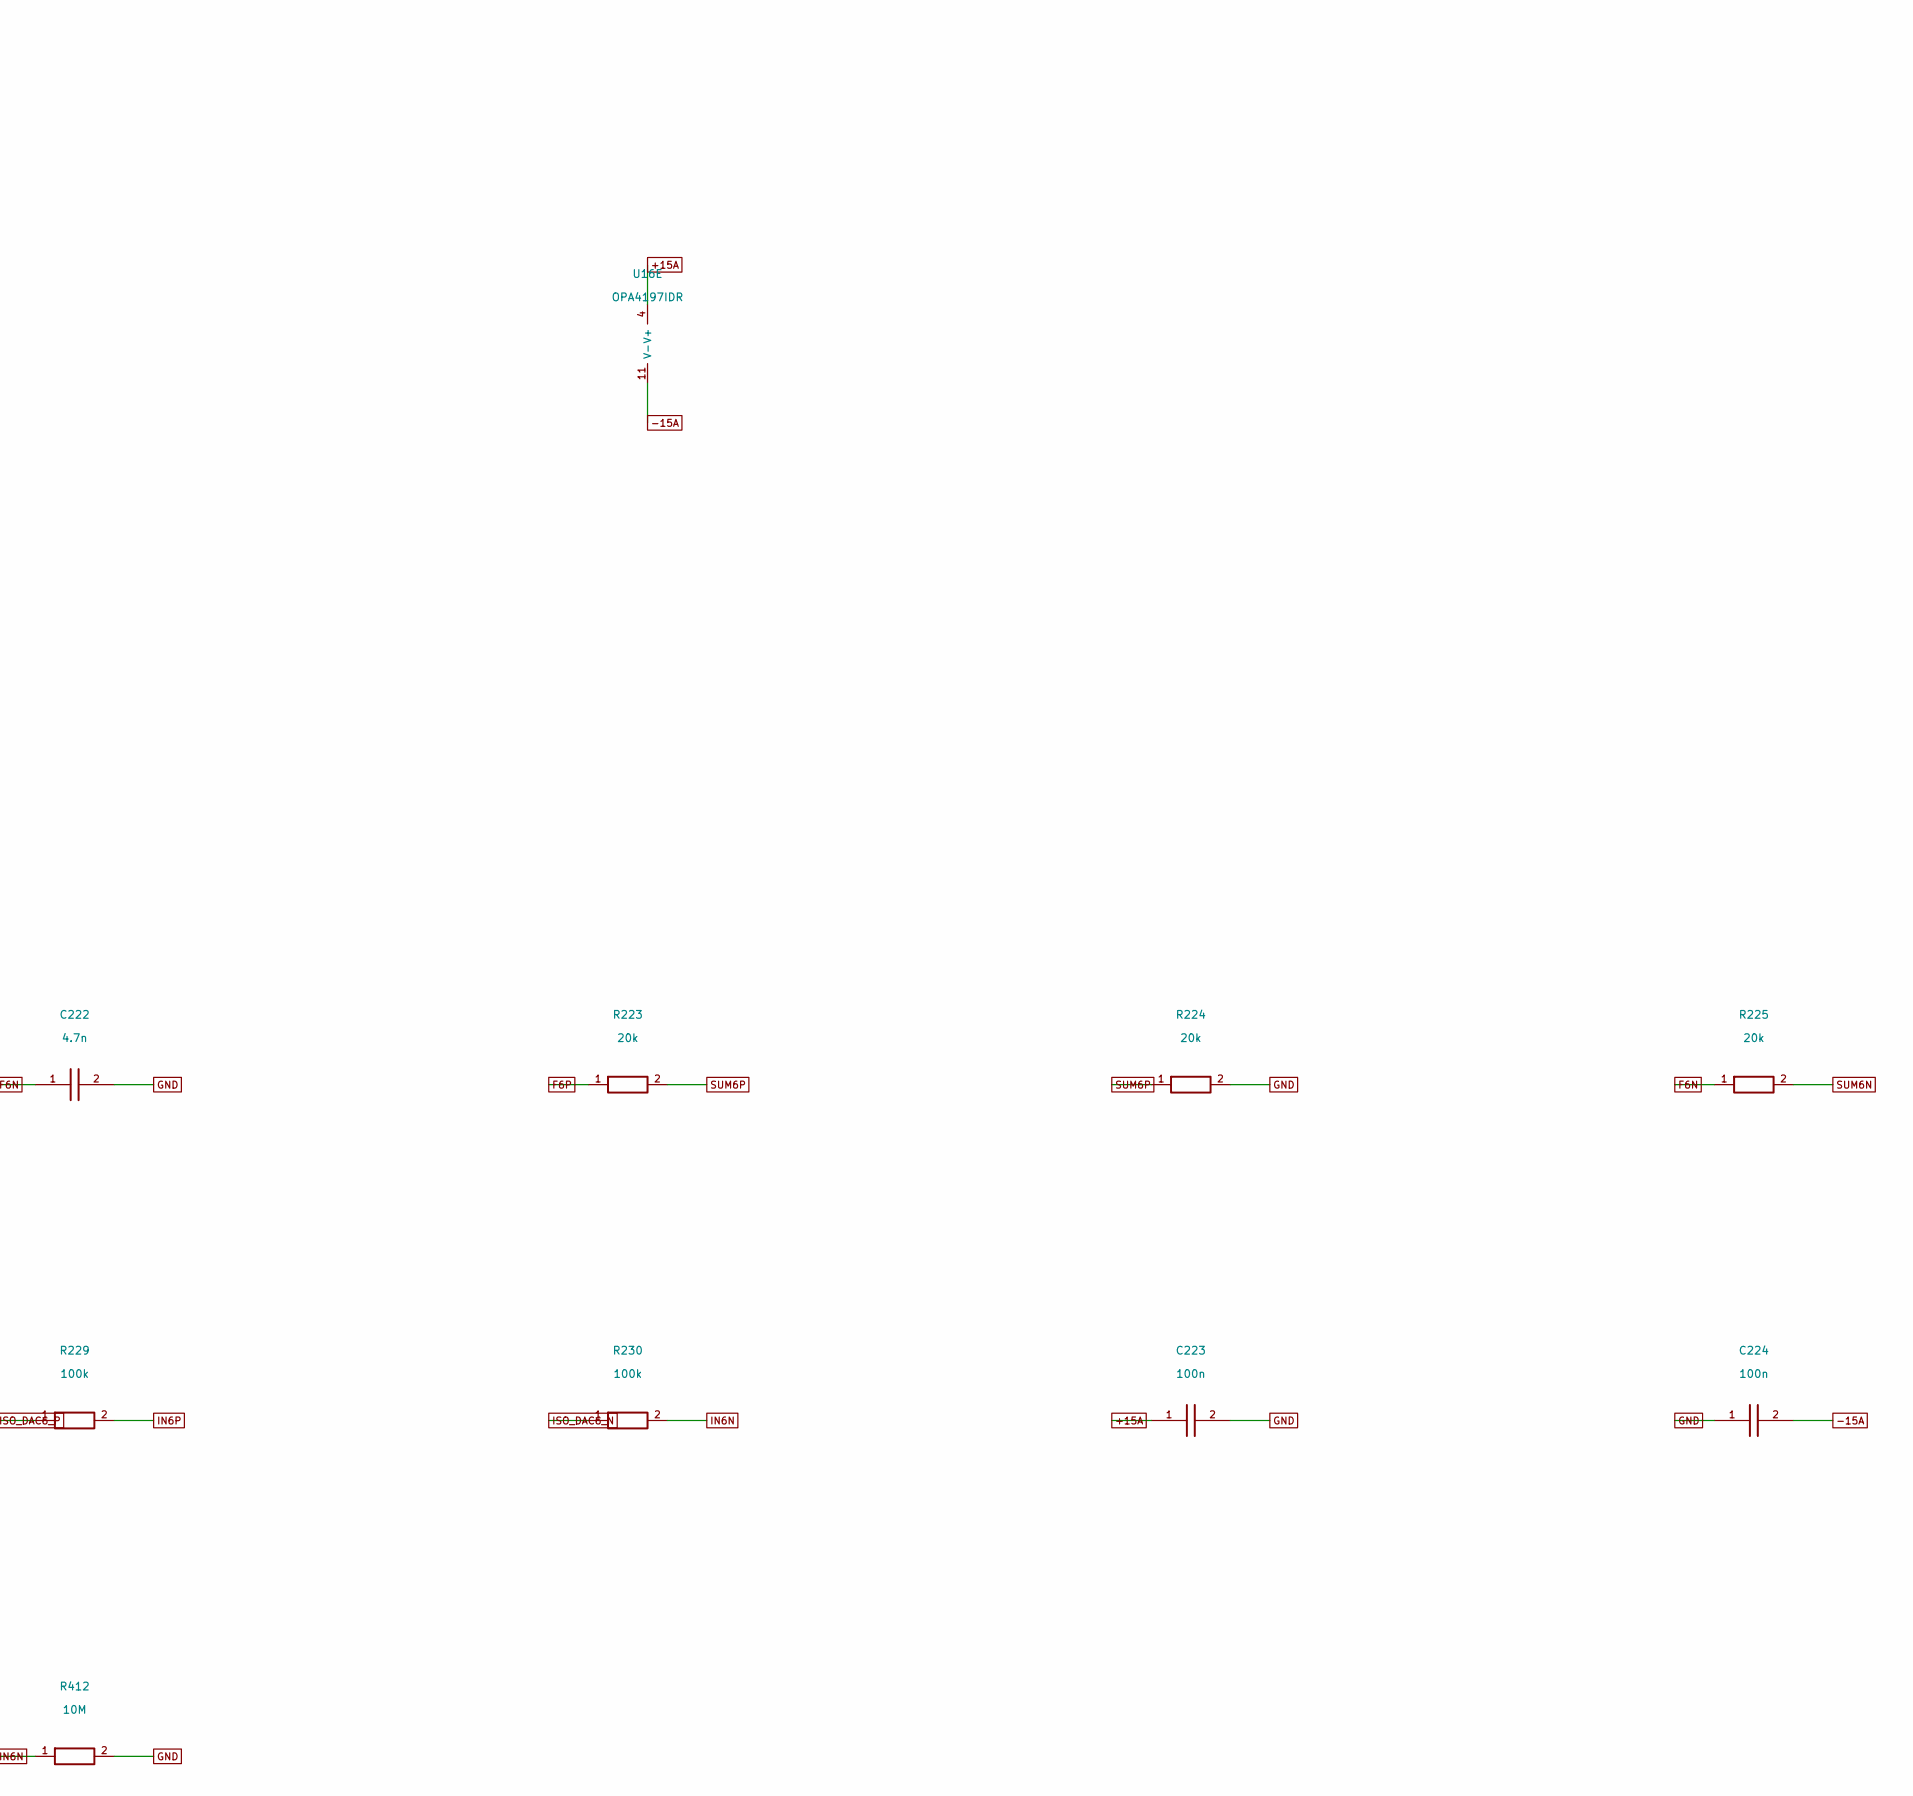
[picture p10: schematic CH6_I.kicad_sch, ILDA8CH RevB-P4 / CH6_I, part in row 1, column 2]

Parts:
C221, C222: 4.7n; Capacitor_SMD__C_0603_1608Metric; MPN GRM1885C1H472JA01D; LCSC C85980
C223, C224: 100n; Capacitor_SMD__C_0603_1608Metric; MPN GRM188R71H104KA93D; LCSC C77055
C225, C226: 4.7u; Capacitor_SMD__C_0805_2012Metric; MPN GRM21BR61E475KA12L; LCSC C77077
R221, R222: 1k; Resistor_SMD__R_0603_1608Metric; MPN RT0603BRD071KL; LCSC C110776
R223, R224, R225, R226: 20k; Resistor_SMD__R_0603_1608Metric; MPN RT0603BRD0720KL; LCSC C723637
R227, R228: 10k; Resistor_SMD__R_0603_1608Metric; MPN RT0603BRD0710KL; LCSC C95204
R229, R230: 100k; Resistor_SMD__R_0603_1608Metric; MPN RC0603FR-07100KL; LCSC C14675
R411, R412: 10M; Resistor_SMD__R_0603_1608Metric; MPN RC0603FR-0710ML; LCSC C114606
U16: OPA4197IDR; Package_SO__SOIC-14_3.9x8.7mm_P1.27mm; MPN OPA4197IDR; LCSC C2058532

Connections:
+15A: C223.1, C225.1, U16.4 (V+); also elsewhere on the board
-15A: C224.2, C226.2, U16.11 (V-); also elsewhere on the board
B6N: R222.1, U16.6 (-), U16.7 (OUT)
B6P: R221.1, U16.1 (OUT), U16.2 (-)
F6N: C222.1, R222.2, R225.1
F6P: C221.1, R221.2, R223.1
GND: C221.2, C222.2, C223.2, C224.1, C225.2, C226.1, R224.2, R411.2, R412.2, U16.12 (+); also elsewhere on the board
IN6N: R230.2, R412.1, U16.5 (+)
IN6P: R229.2, R411.1, U16.3 (+)
INV6: R227.2, R228.2, U16.13 (-)
ISO_DAC6_N: R230.1; also elsewhere on the board
ISO_DAC6_P: R229.1; also elsewhere on the board
I_DRV_N: R228.1, U16.14 (OUT); also elsewhere on the board
I_DRV_P: R226.1, R227.1, U16.8 (OUT); also elsewhere on the board
SUM6N: R225.2, R226.2, U16.9 (-)
SUM6P: R223.2, R224.1, U16.10 (+)

Notes on the sheet:
DC coupled. Physical pin numbers; net names are global and channel-unique.
X/Y DC gain = 39k/(20k+1k); colour gain = 20k/(20k+1k). Calibrate in firmware.
A/B: unity-gain input buffers. C: matched subtractor. D: complementary driver.
