weiweiweiopen/teensy-4-RGBgalvos/hardware/revB/KiCad/ILDA8CH.kicad_pcb

## KiCad design hardware/revB/KiCad/ILDA8CH.kicad_pcb (continued)

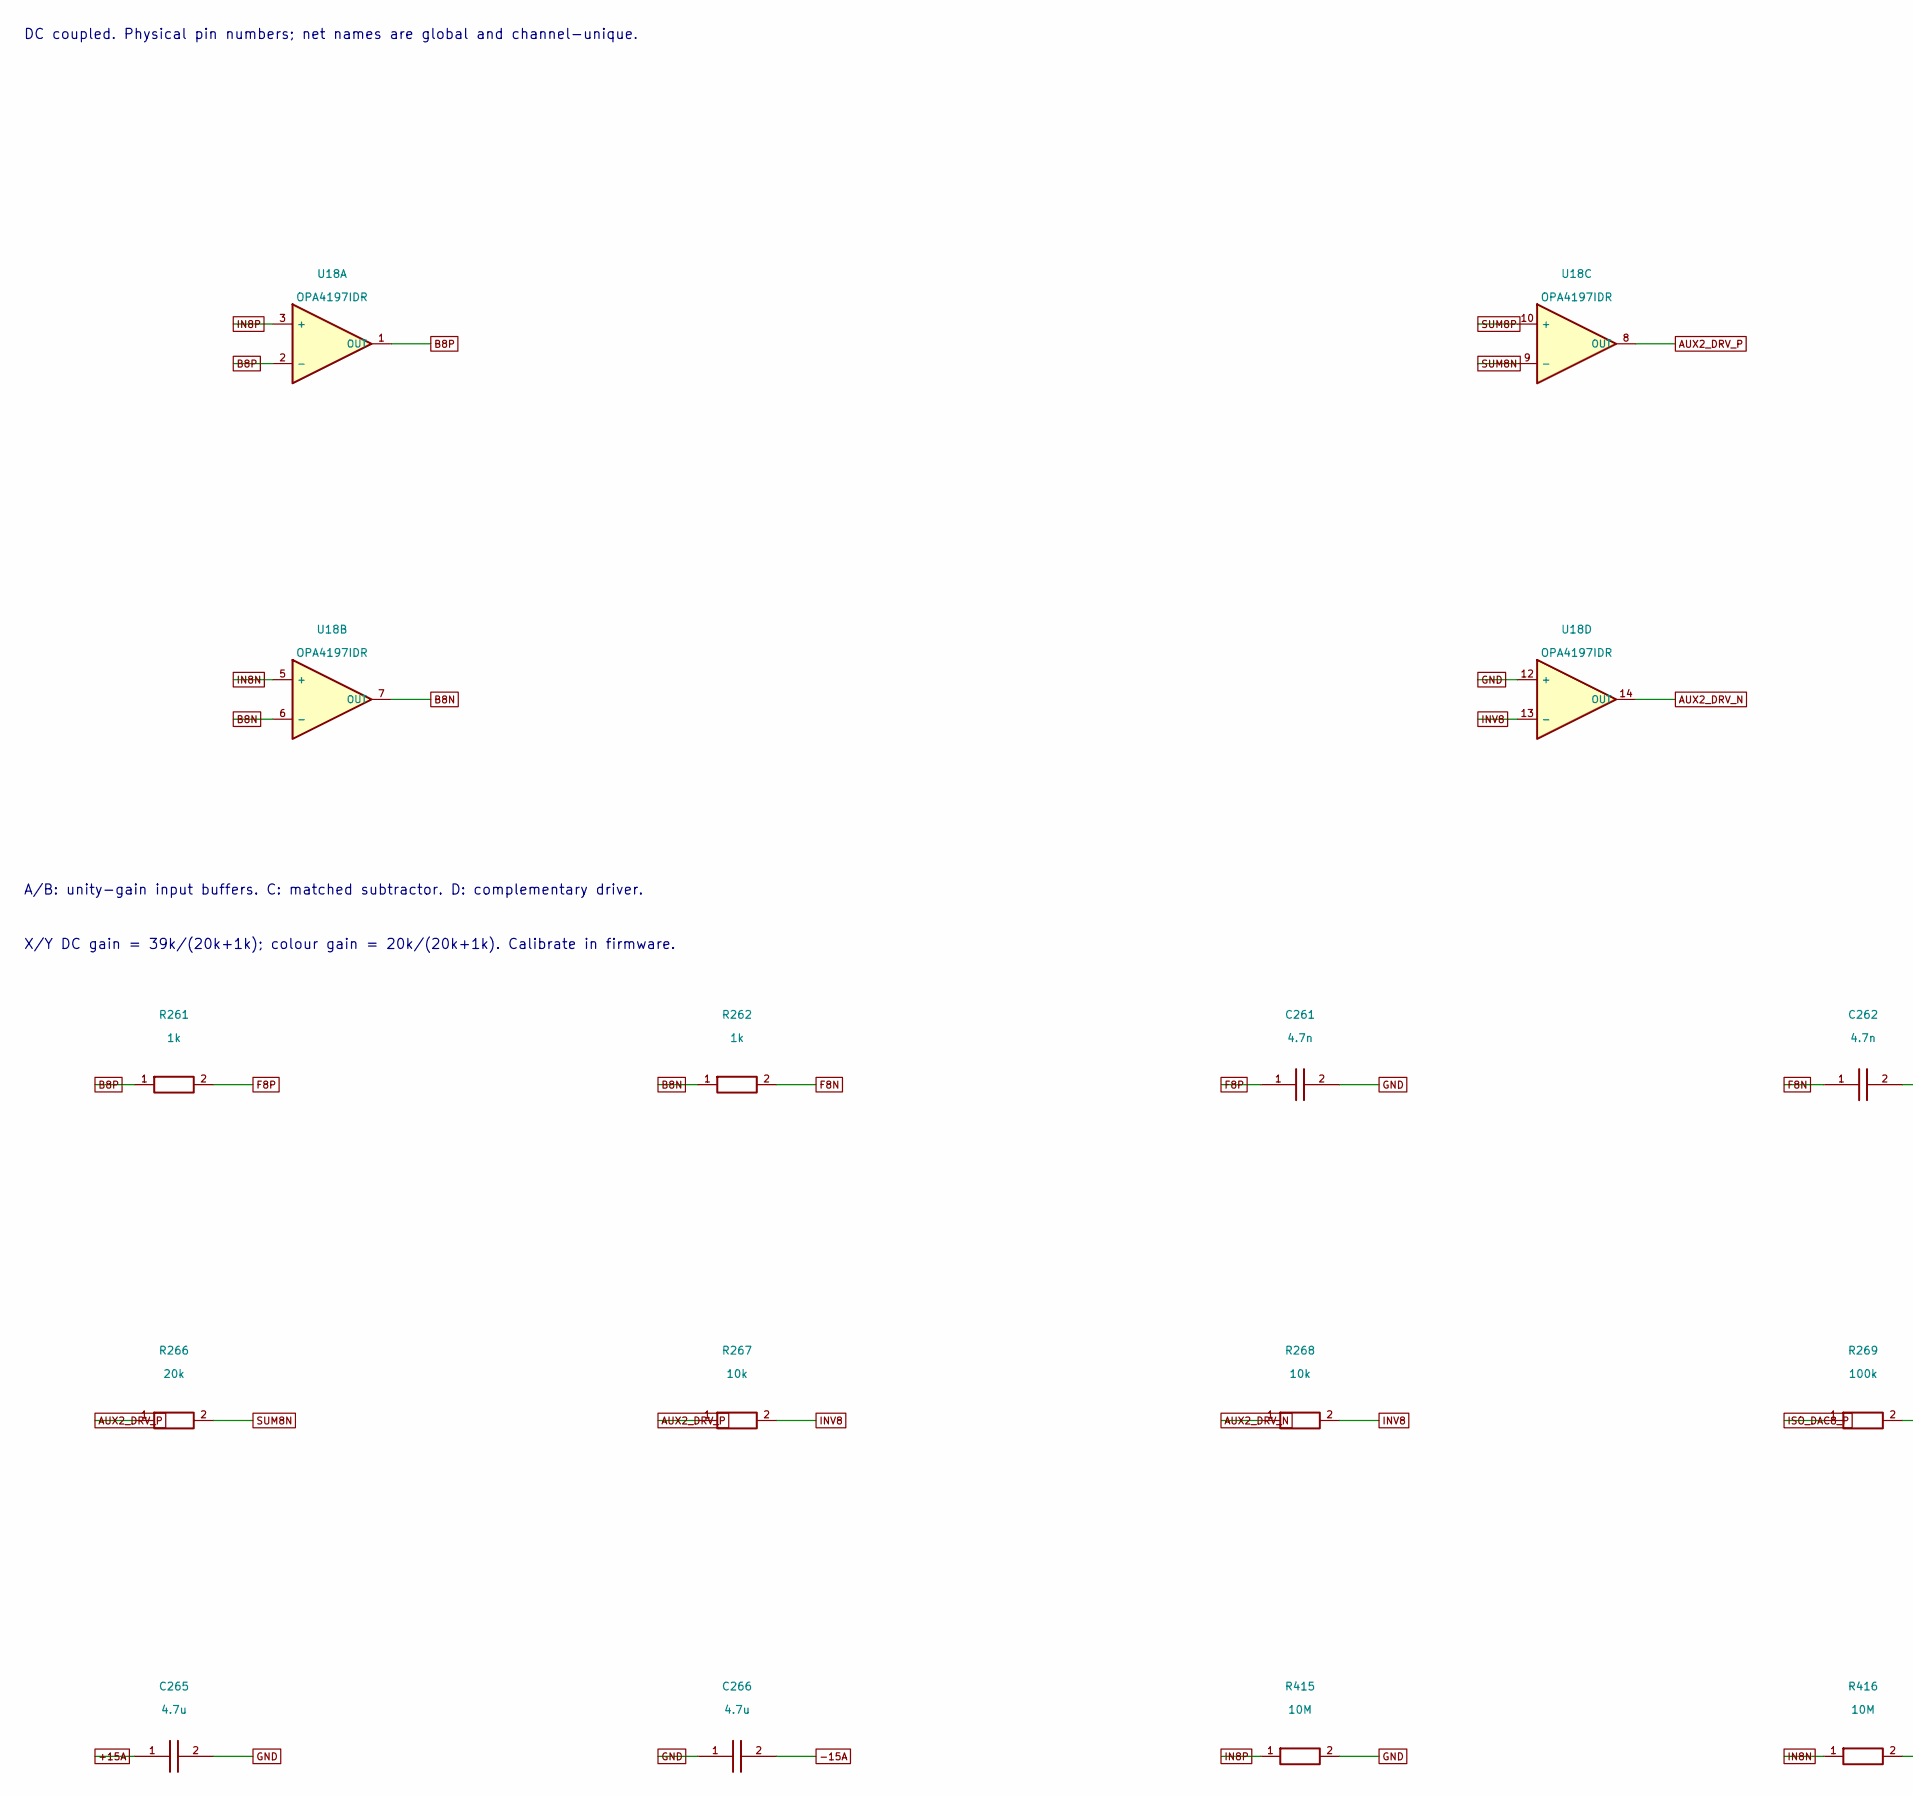
[picture p11: schematic CH8_AUX2.kicad_sch, ILDA8CH RevB-P4 / CH8_AUX2, part in row 1, column 1]

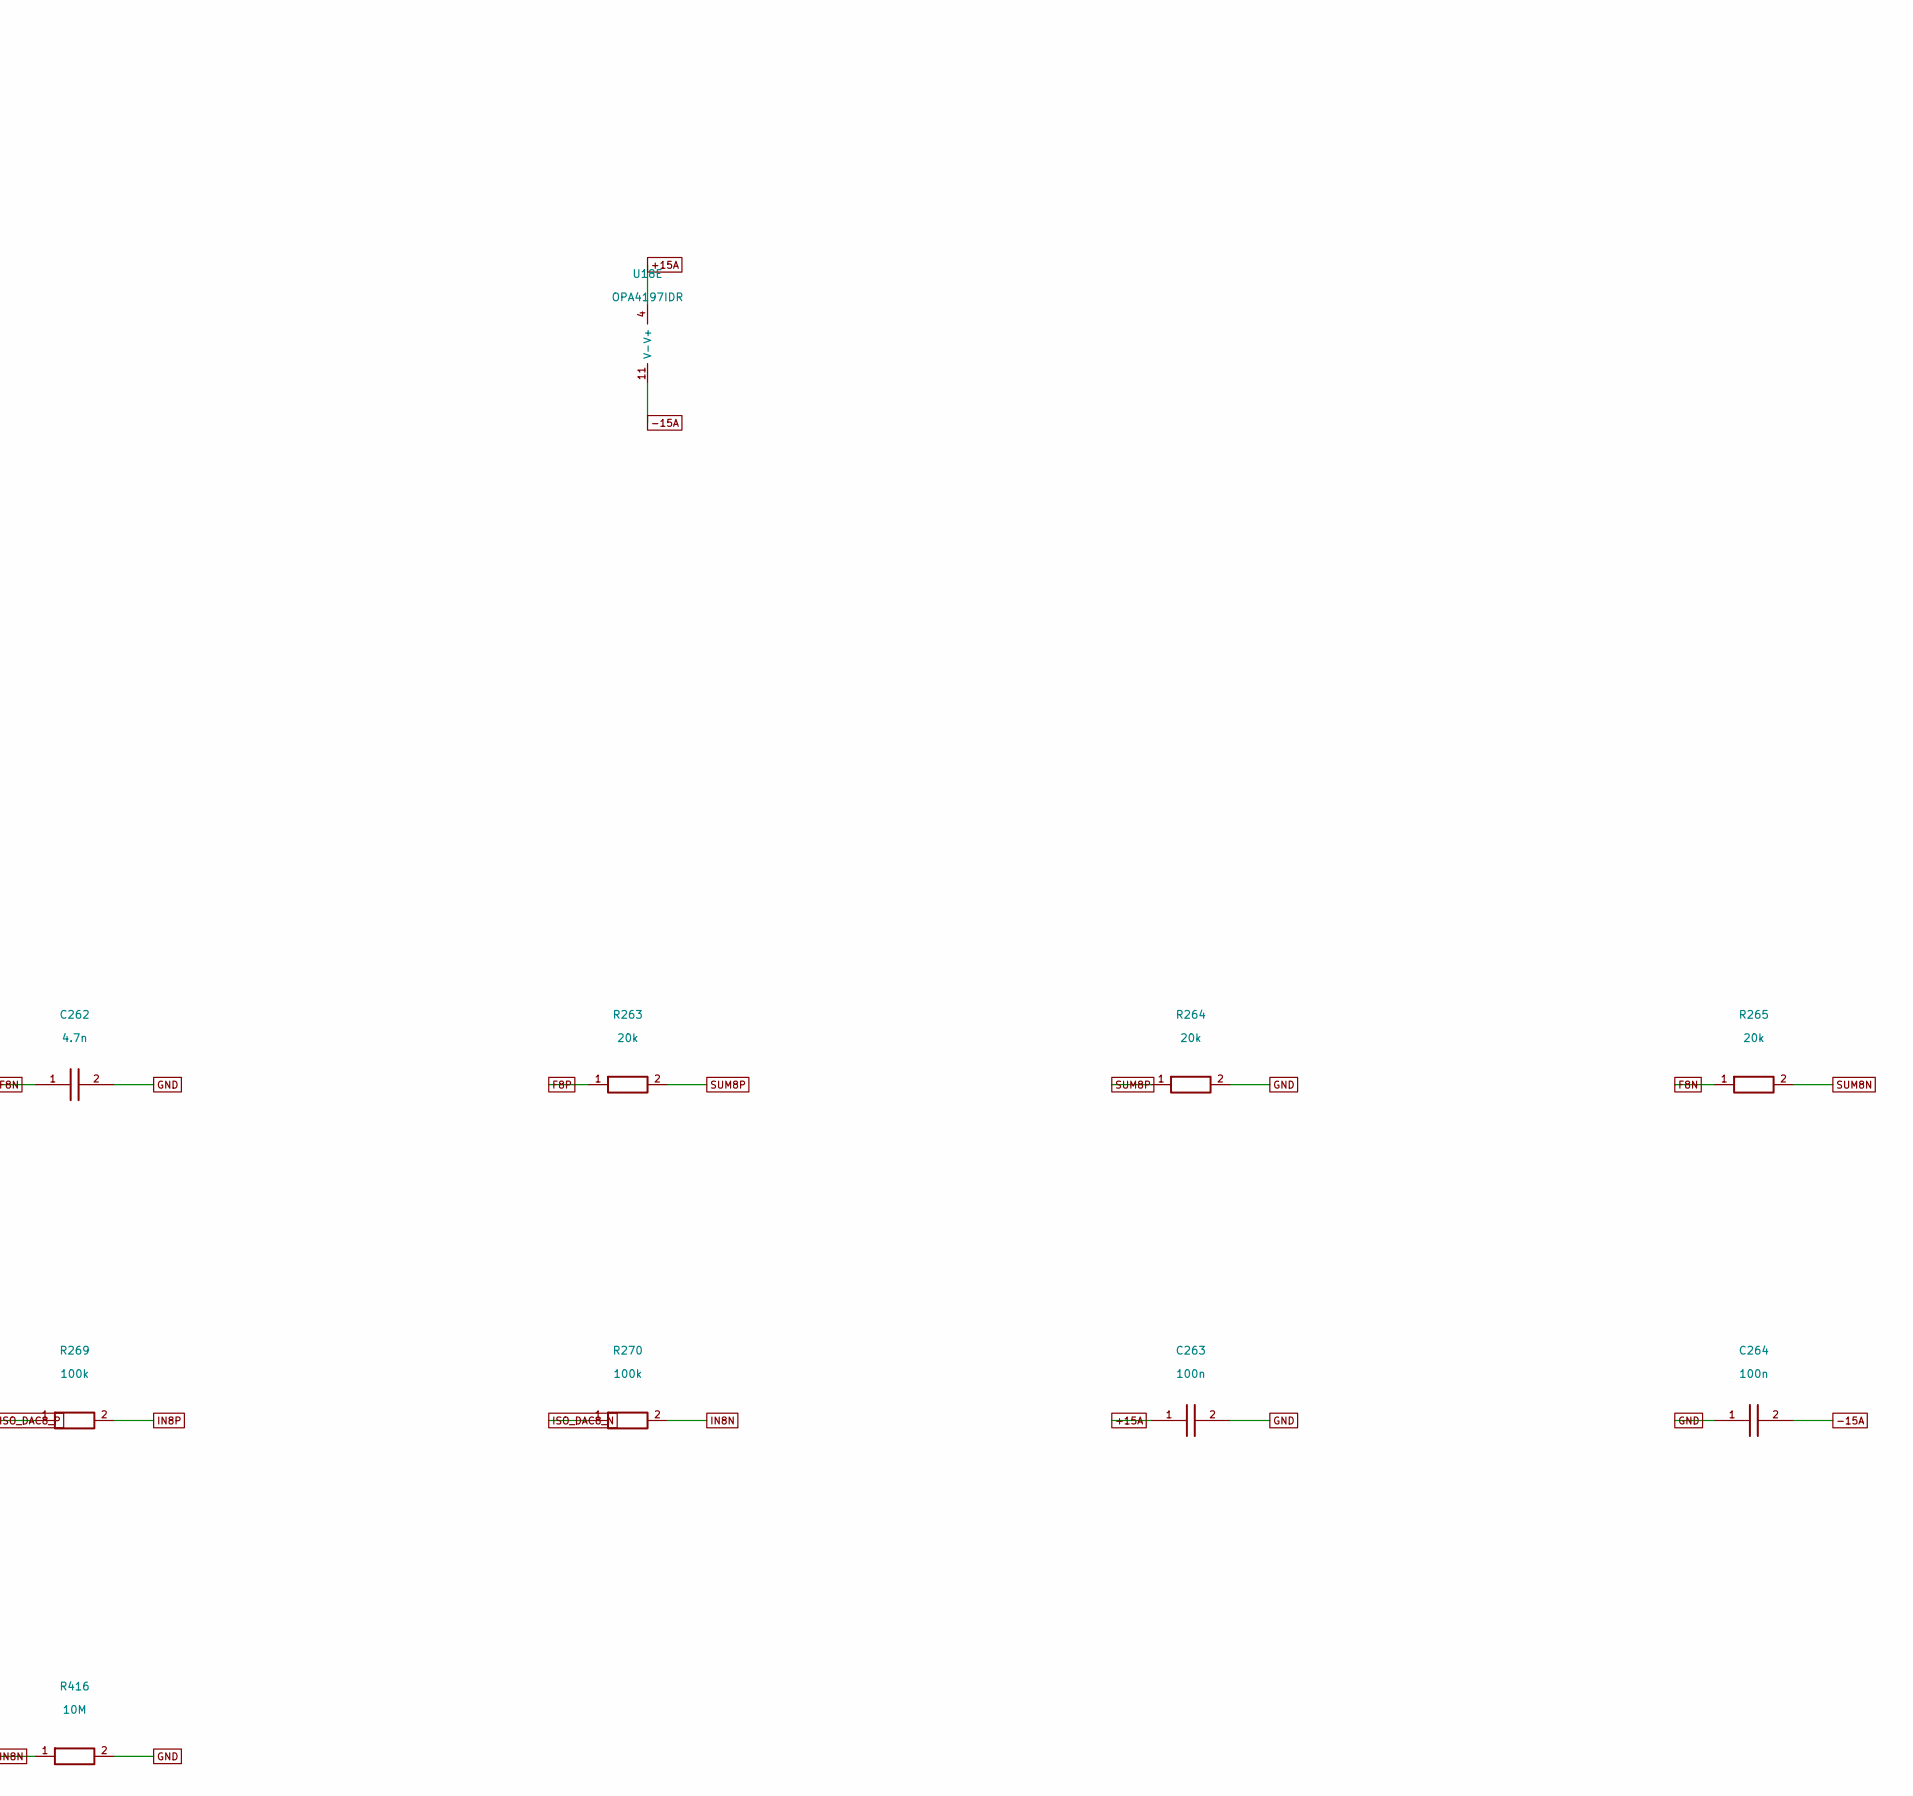
[picture p12: schematic CH8_AUX2.kicad_sch, ILDA8CH RevB-P4 / CH8_AUX2, part in row 1, column 2]

Parts:
C261, C262: 4.7n; Capacitor_SMD__C_0603_1608Metric; MPN GRM1885C1H472JA01D; LCSC C85980
C263, C264: 100n; Capacitor_SMD__C_0603_1608Metric; MPN GRM188R71H104KA93D; LCSC C77055
C265, C266: 4.7u; Capacitor_SMD__C_0805_2012Metric; MPN GRM21BR61E475KA12L; LCSC C77077
R261, R262: 1k; Resistor_SMD__R_0603_1608Metric; MPN RT0603BRD071KL; LCSC C110776
R263, R264, R265, R266: 20k; Resistor_SMD__R_0603_1608Metric; MPN RT0603BRD0720KL; LCSC C723637
R267, R268: 10k; Resistor_SMD__R_0603_1608Metric; MPN RT0603BRD0710KL; LCSC C95204
R269, R270: 100k; Resistor_SMD__R_0603_1608Metric; MPN RC0603FR-07100KL; LCSC C14675
R415, R416: 10M; Resistor_SMD__R_0603_1608Metric; MPN RC0603FR-0710ML; LCSC C114606
U18: OPA4197IDR; Package_SO__SOIC-14_3.9x8.7mm_P1.27mm; MPN OPA4197IDR; LCSC C2058532

Connections:
+15A: C263.1, C265.1, U18.4 (V+); also elsewhere on the board
-15A: C264.2, C266.2, U18.11 (V-); also elsewhere on the board
AUX2_DRV_N: R268.1, U18.14 (OUT); also elsewhere on the board
AUX2_DRV_P: R266.1, R267.1, U18.8 (OUT); also elsewhere on the board
B8N: R262.1, U18.6 (-), U18.7 (OUT)
B8P: R261.1, U18.1 (OUT), U18.2 (-)
F8N: C262.1, R262.2, R265.1
F8P: C261.1, R261.2, R263.1
GND: C261.2, C262.2, C263.2, C264.1, C265.2, C266.1, R264.2, R415.2, R416.2, U18.12 (+); also elsewhere on the board
IN8N: R270.2, R416.1, U18.5 (+)
IN8P: R269.2, R415.1, U18.3 (+)
INV8: R267.2, R268.2, U18.13 (-)
ISO_DAC8_N: R270.1; also elsewhere on the board
ISO_DAC8_P: R269.1; also elsewhere on the board
SUM8N: R265.2, R266.2, U18.9 (-)
SUM8P: R263.2, R264.1, U18.10 (+)

Notes on the sheet:
DC coupled. Physical pin numbers; net names are global and channel-unique.
X/Y DC gain = 39k/(20k+1k); colour gain = 20k/(20k+1k). Calibrate in firmware.
A/B: unity-gain input buffers. C: matched subtractor. D: complementary driver.

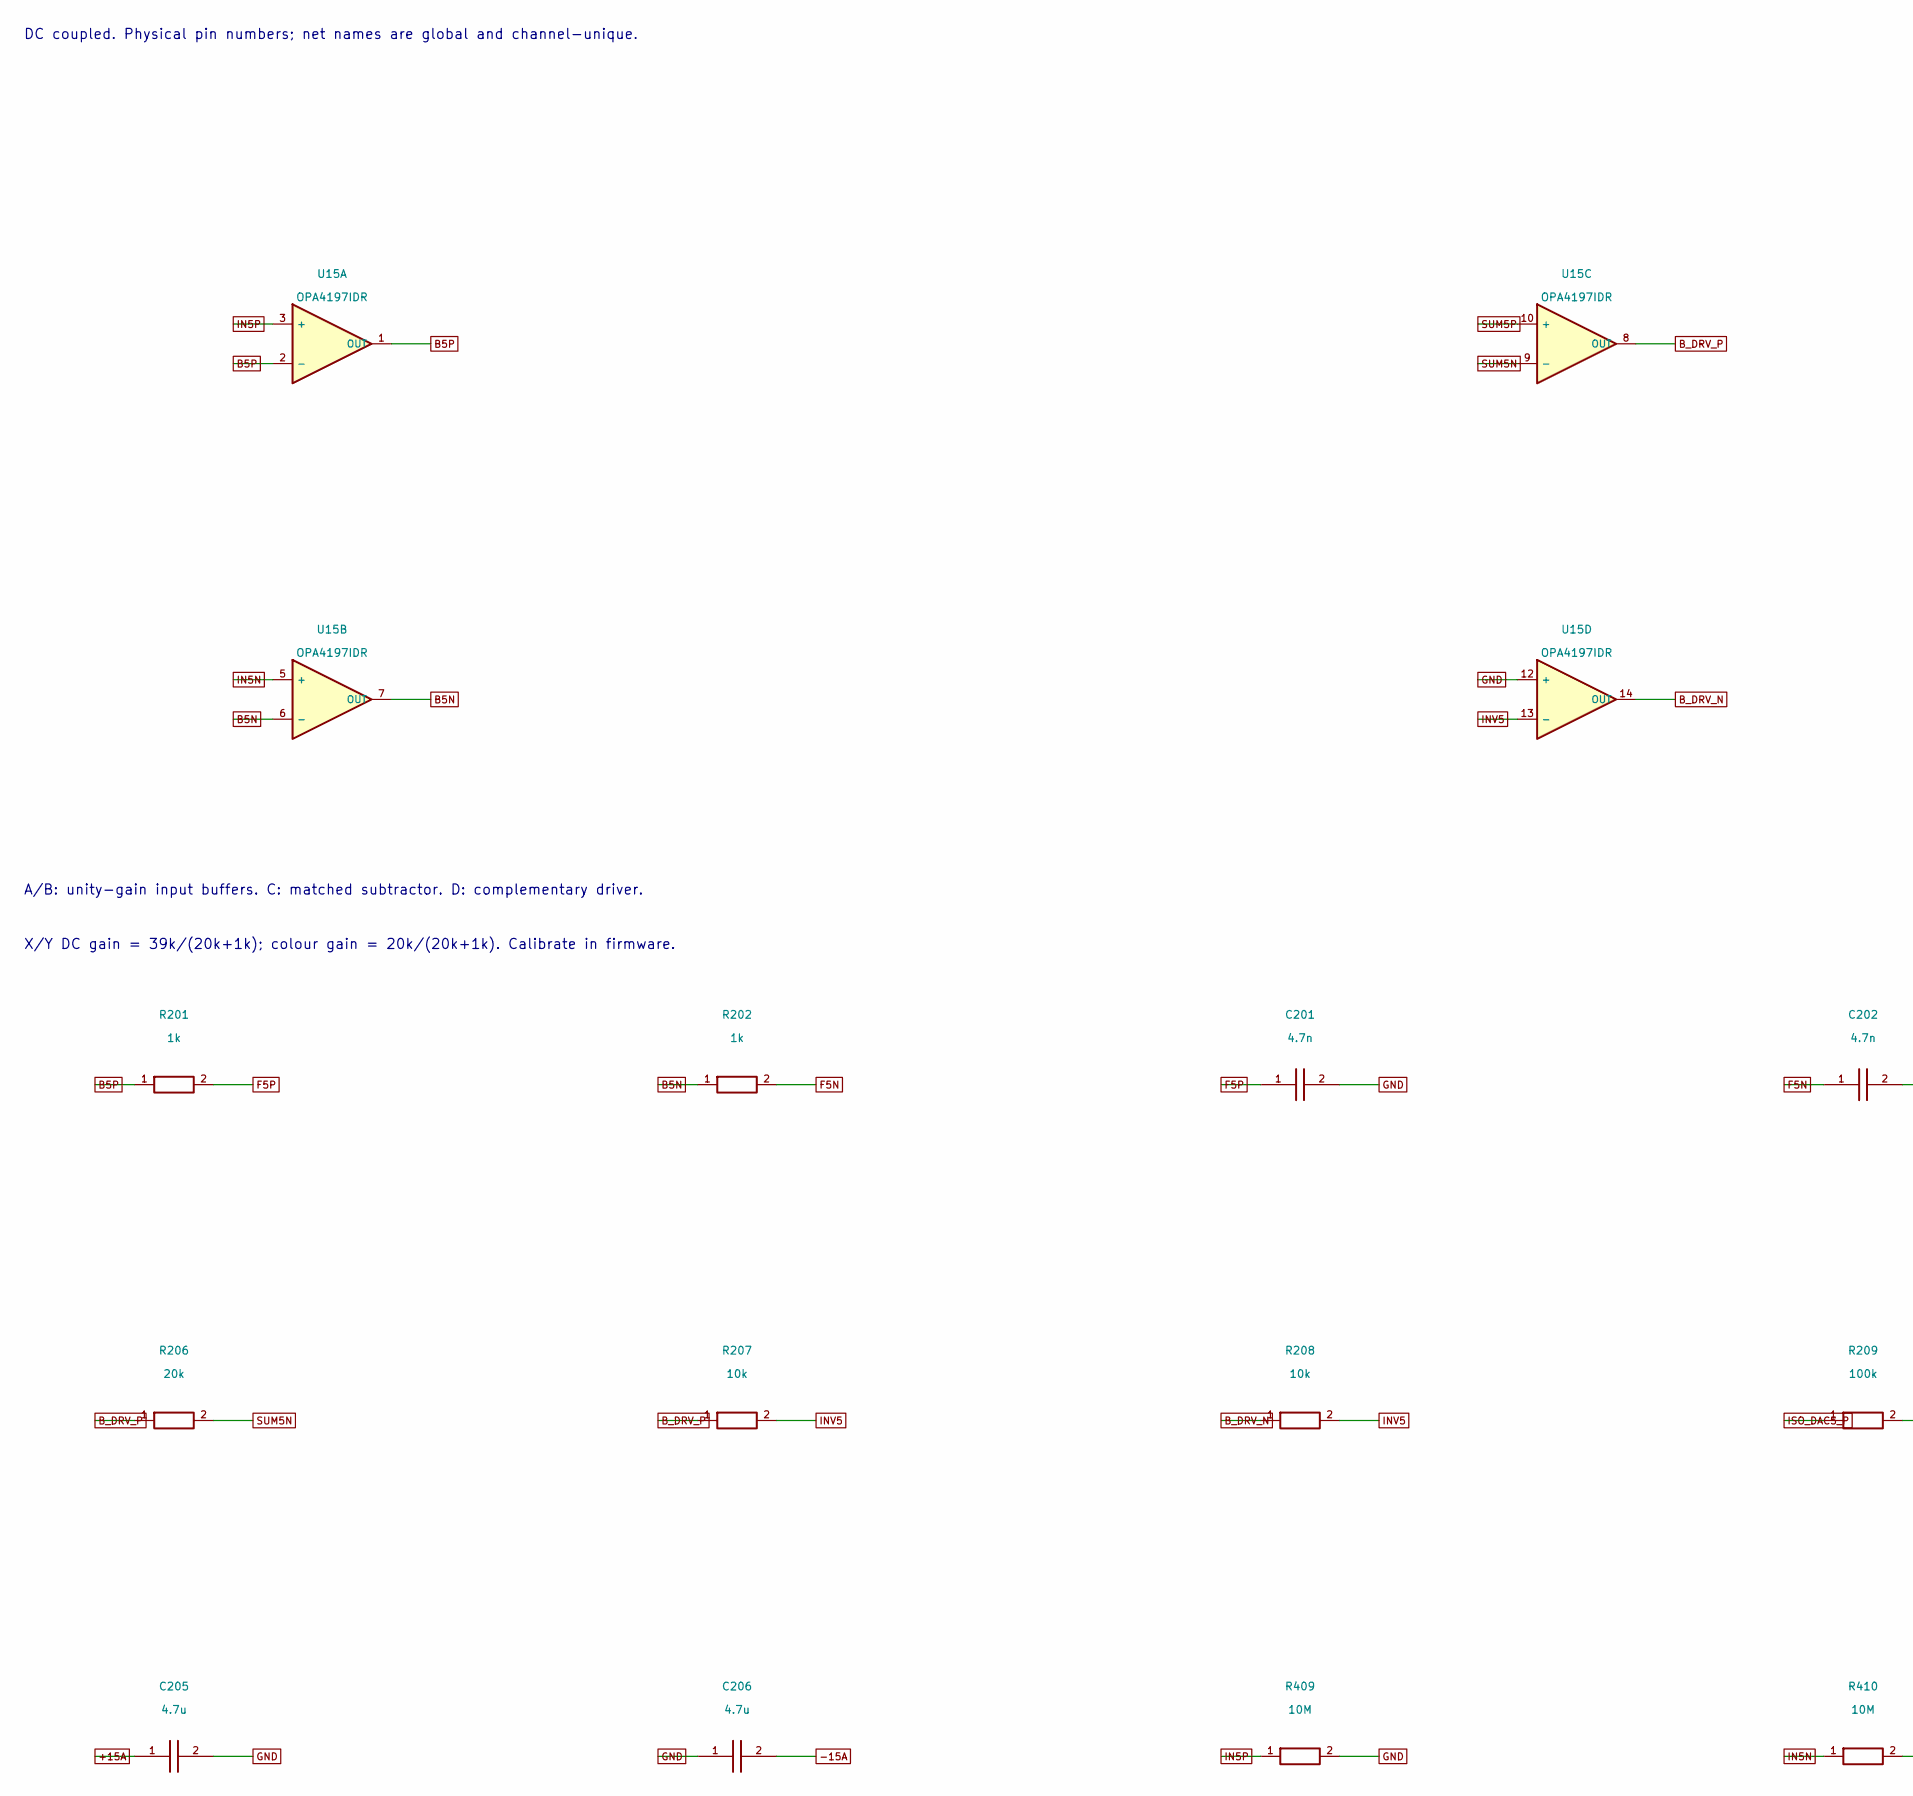
[picture p13: schematic CH5_B.kicad_sch, ILDA8CH RevB-P4 / CH5_B, part in row 1, column 1]

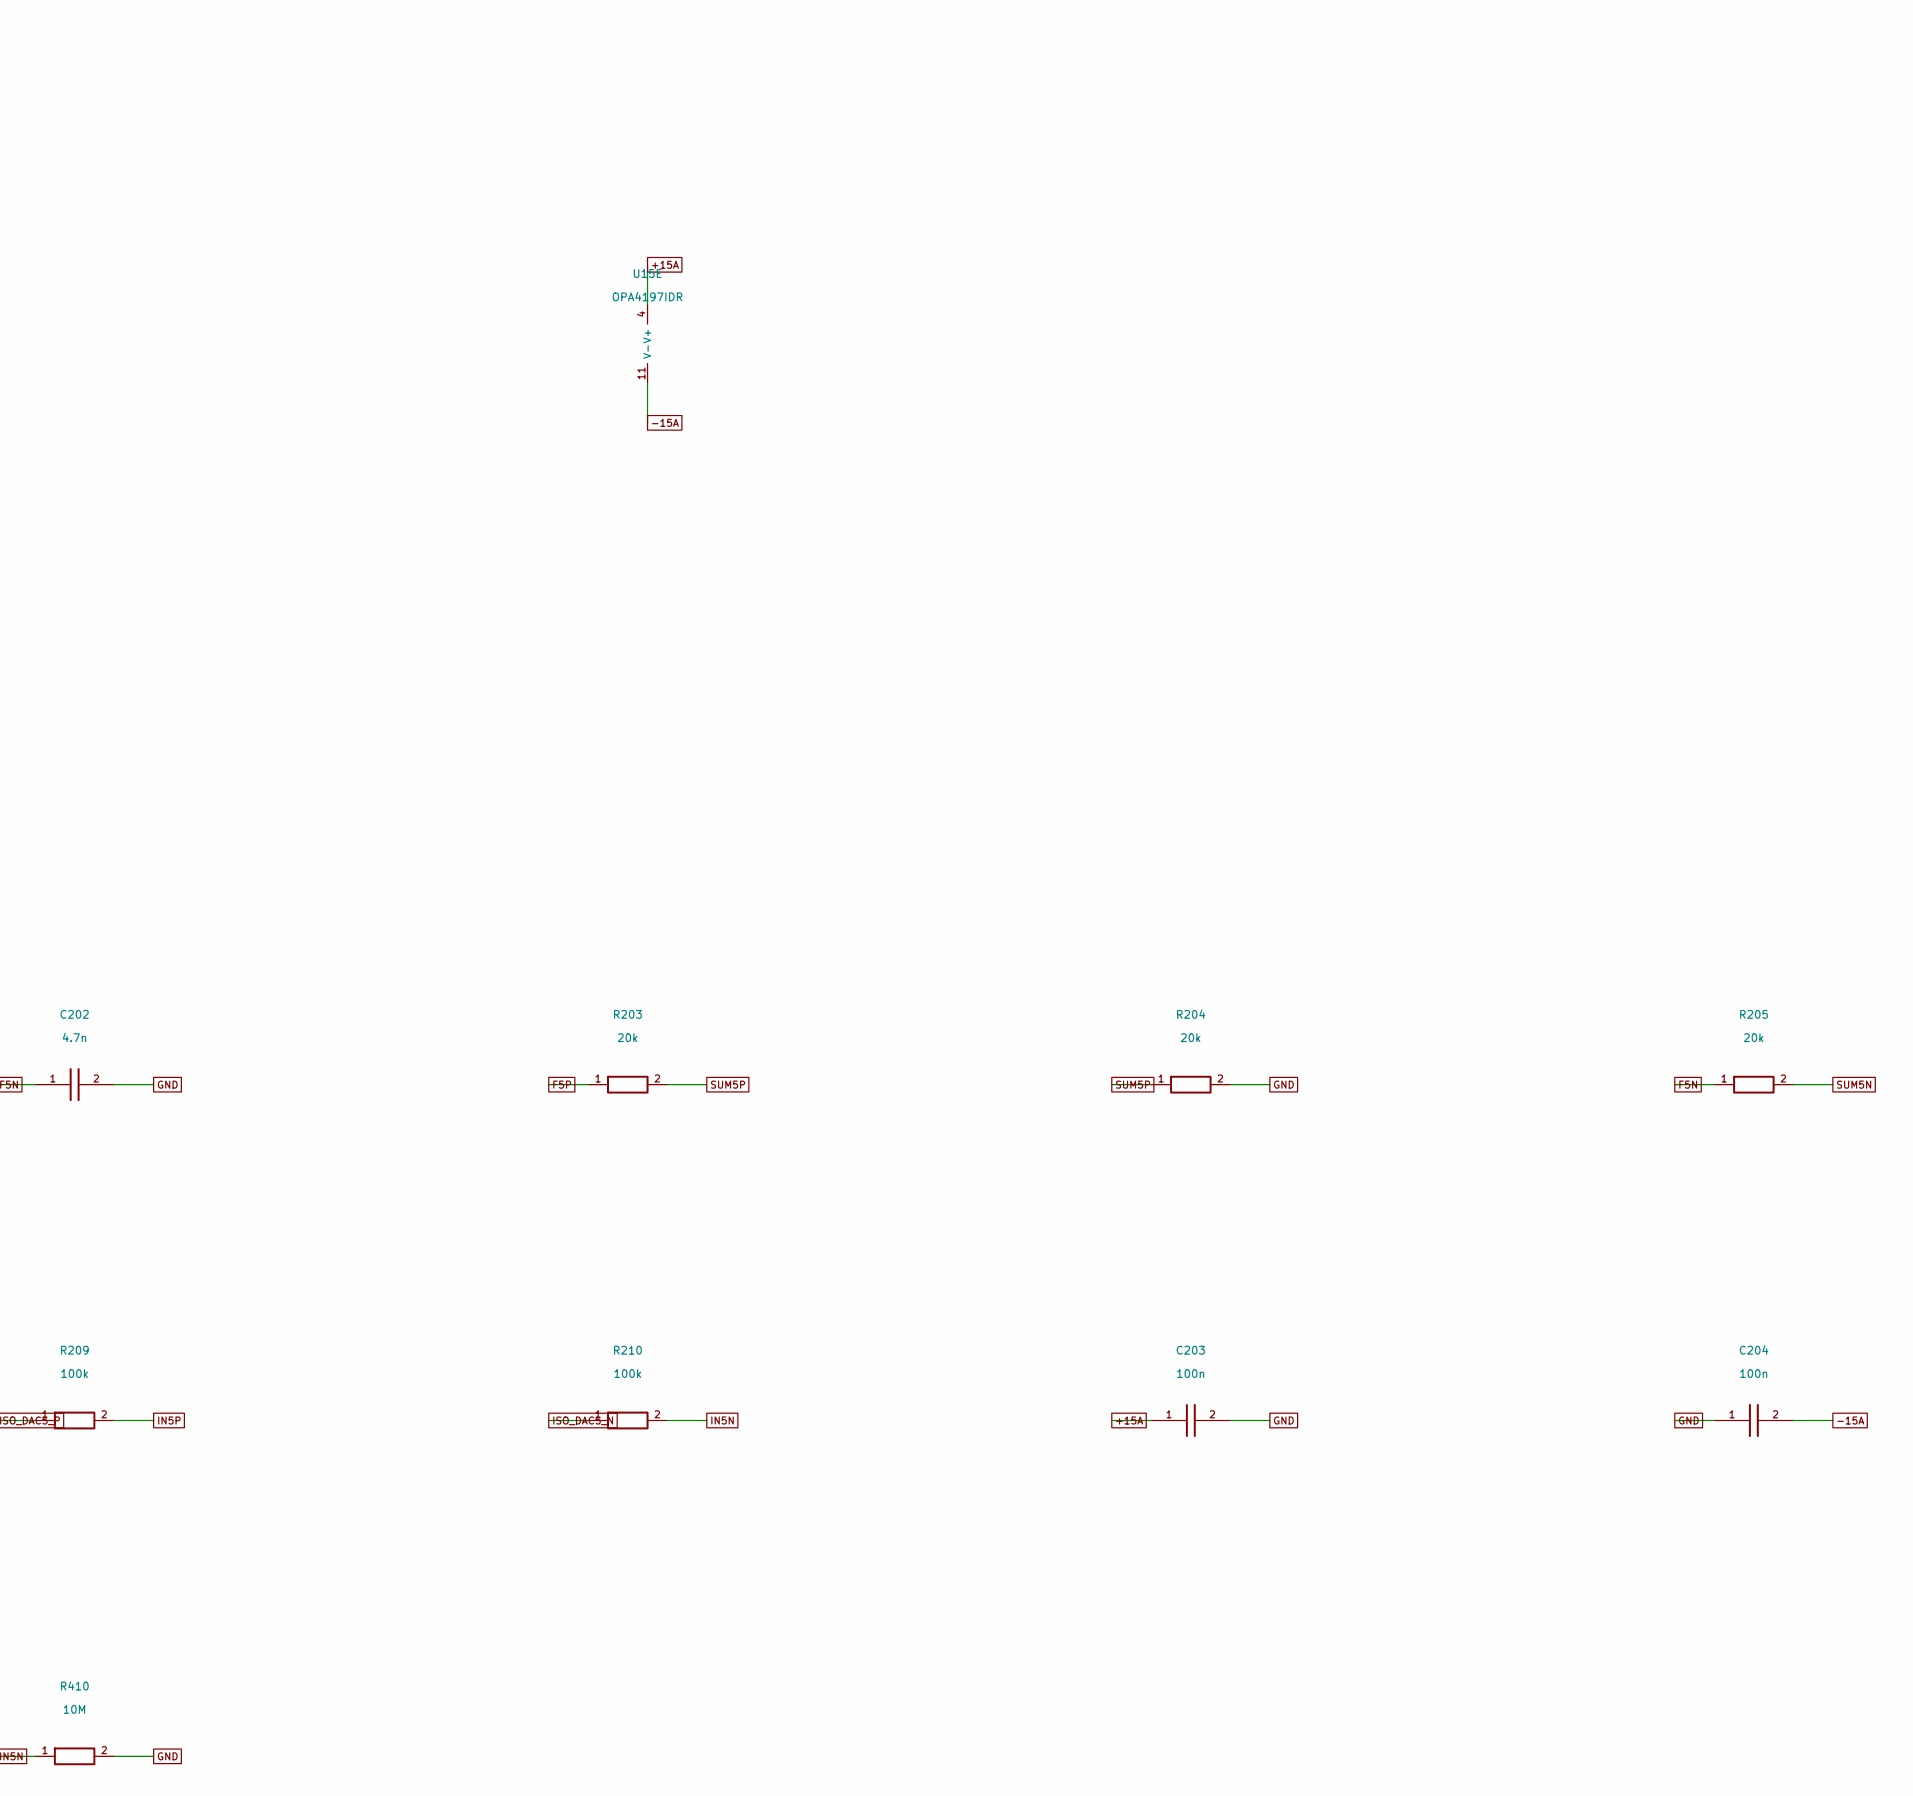
[picture p14: schematic CH5_B.kicad_sch, ILDA8CH RevB-P4 / CH5_B, part in row 1, column 2]

Parts:
C201, C202: 4.7n; Capacitor_SMD__C_0603_1608Metric; MPN GRM1885C1H472JA01D; LCSC C85980
C203, C204: 100n; Capacitor_SMD__C_0603_1608Metric; MPN GRM188R71H104KA93D; LCSC C77055
C205, C206: 4.7u; Capacitor_SMD__C_0805_2012Metric; MPN GRM21BR61E475KA12L; LCSC C77077
R201, R202: 1k; Resistor_SMD__R_0603_1608Metric; MPN RT0603BRD071KL; LCSC C110776
R203, R204, R205, R206: 20k; Resistor_SMD__R_0603_1608Metric; MPN RT0603BRD0720KL; LCSC C723637
R207, R208: 10k; Resistor_SMD__R_0603_1608Metric; MPN RT0603BRD0710KL; LCSC C95204
R209, R210: 100k; Resistor_SMD__R_0603_1608Metric; MPN RC0603FR-07100KL; LCSC C14675
R409, R410: 10M; Resistor_SMD__R_0603_1608Metric; MPN RC0603FR-0710ML; LCSC C114606
U15: OPA4197IDR; Package_SO__SOIC-14_3.9x8.7mm_P1.27mm; MPN OPA4197IDR; LCSC C2058532

Connections:
+15A: C203.1, C205.1, U15.4 (V+); also elsewhere on the board
-15A: C204.2, C206.2, U15.11 (V-); also elsewhere on the board
B5N: R202.1, U15.6 (-), U15.7 (OUT)
B5P: R201.1, U15.1 (OUT), U15.2 (-)
B_DRV_N: R208.1, U15.14 (OUT); also elsewhere on the board
B_DRV_P: R206.1, R207.1, U15.8 (OUT); also elsewhere on the board
F5N: C202.1, R202.2, R205.1
F5P: C201.1, R201.2, R203.1
GND: C201.2, C202.2, C203.2, C204.1, C205.2, C206.1, R204.2, R409.2, R410.2, U15.12 (+); also elsewhere on the board
IN5N: R210.2, R410.1, U15.5 (+)
IN5P: R209.2, R409.1, U15.3 (+)
INV5: R207.2, R208.2, U15.13 (-)
ISO_DAC5_N: R210.1; also elsewhere on the board
ISO_DAC5_P: R209.1; also elsewhere on the board
SUM5N: R205.2, R206.2, U15.9 (-)
SUM5P: R203.2, R204.1, U15.10 (+)

Notes on the sheet:
DC coupled. Physical pin numbers; net names are global and channel-unique.
X/Y DC gain = 39k/(20k+1k); colour gain = 20k/(20k+1k). Calibrate in firmware.
A/B: unity-gain input buffers. C: matched subtractor. D: complementary driver.
