weiweiweiopen/teensy-4-RGBgalvos/hardware/revB/KiCad/ILDA8CH.kicad_pcb

## KiCad design hardware/revB/KiCad/ILDA8CH.kicad_pcb (continued)

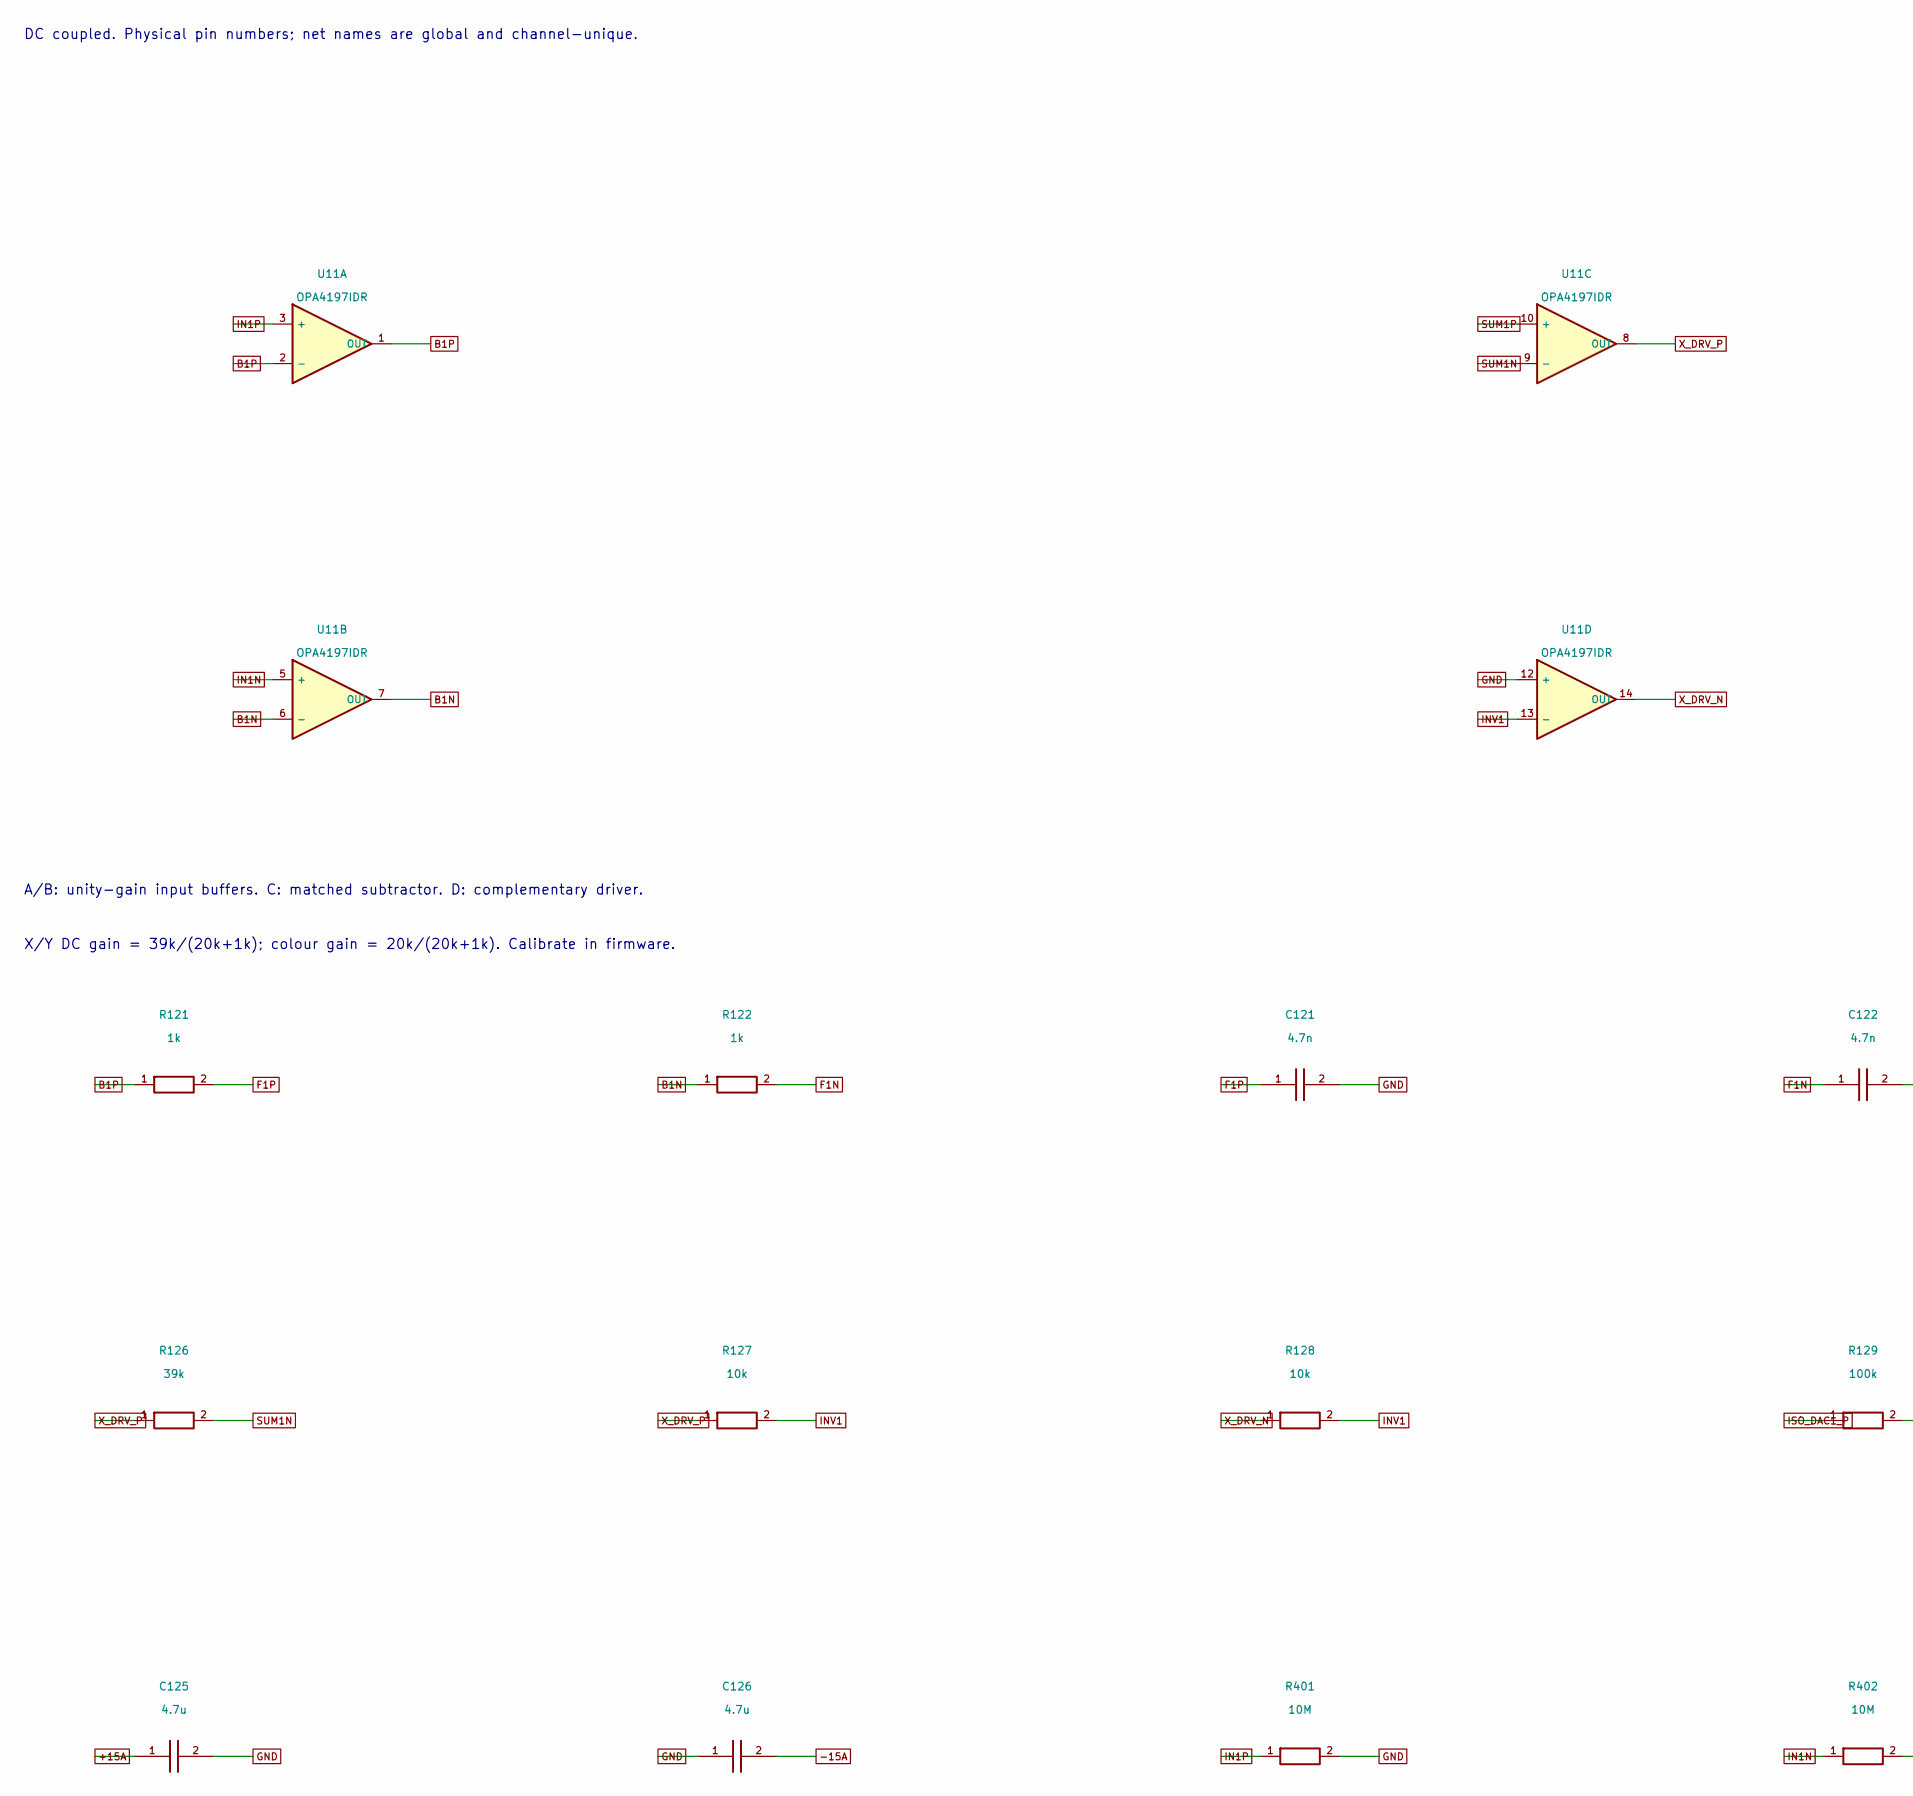
[picture p15: schematic CH1_X.kicad_sch, ILDA8CH RevB-P4 / CH1_X, part in row 1, column 1]

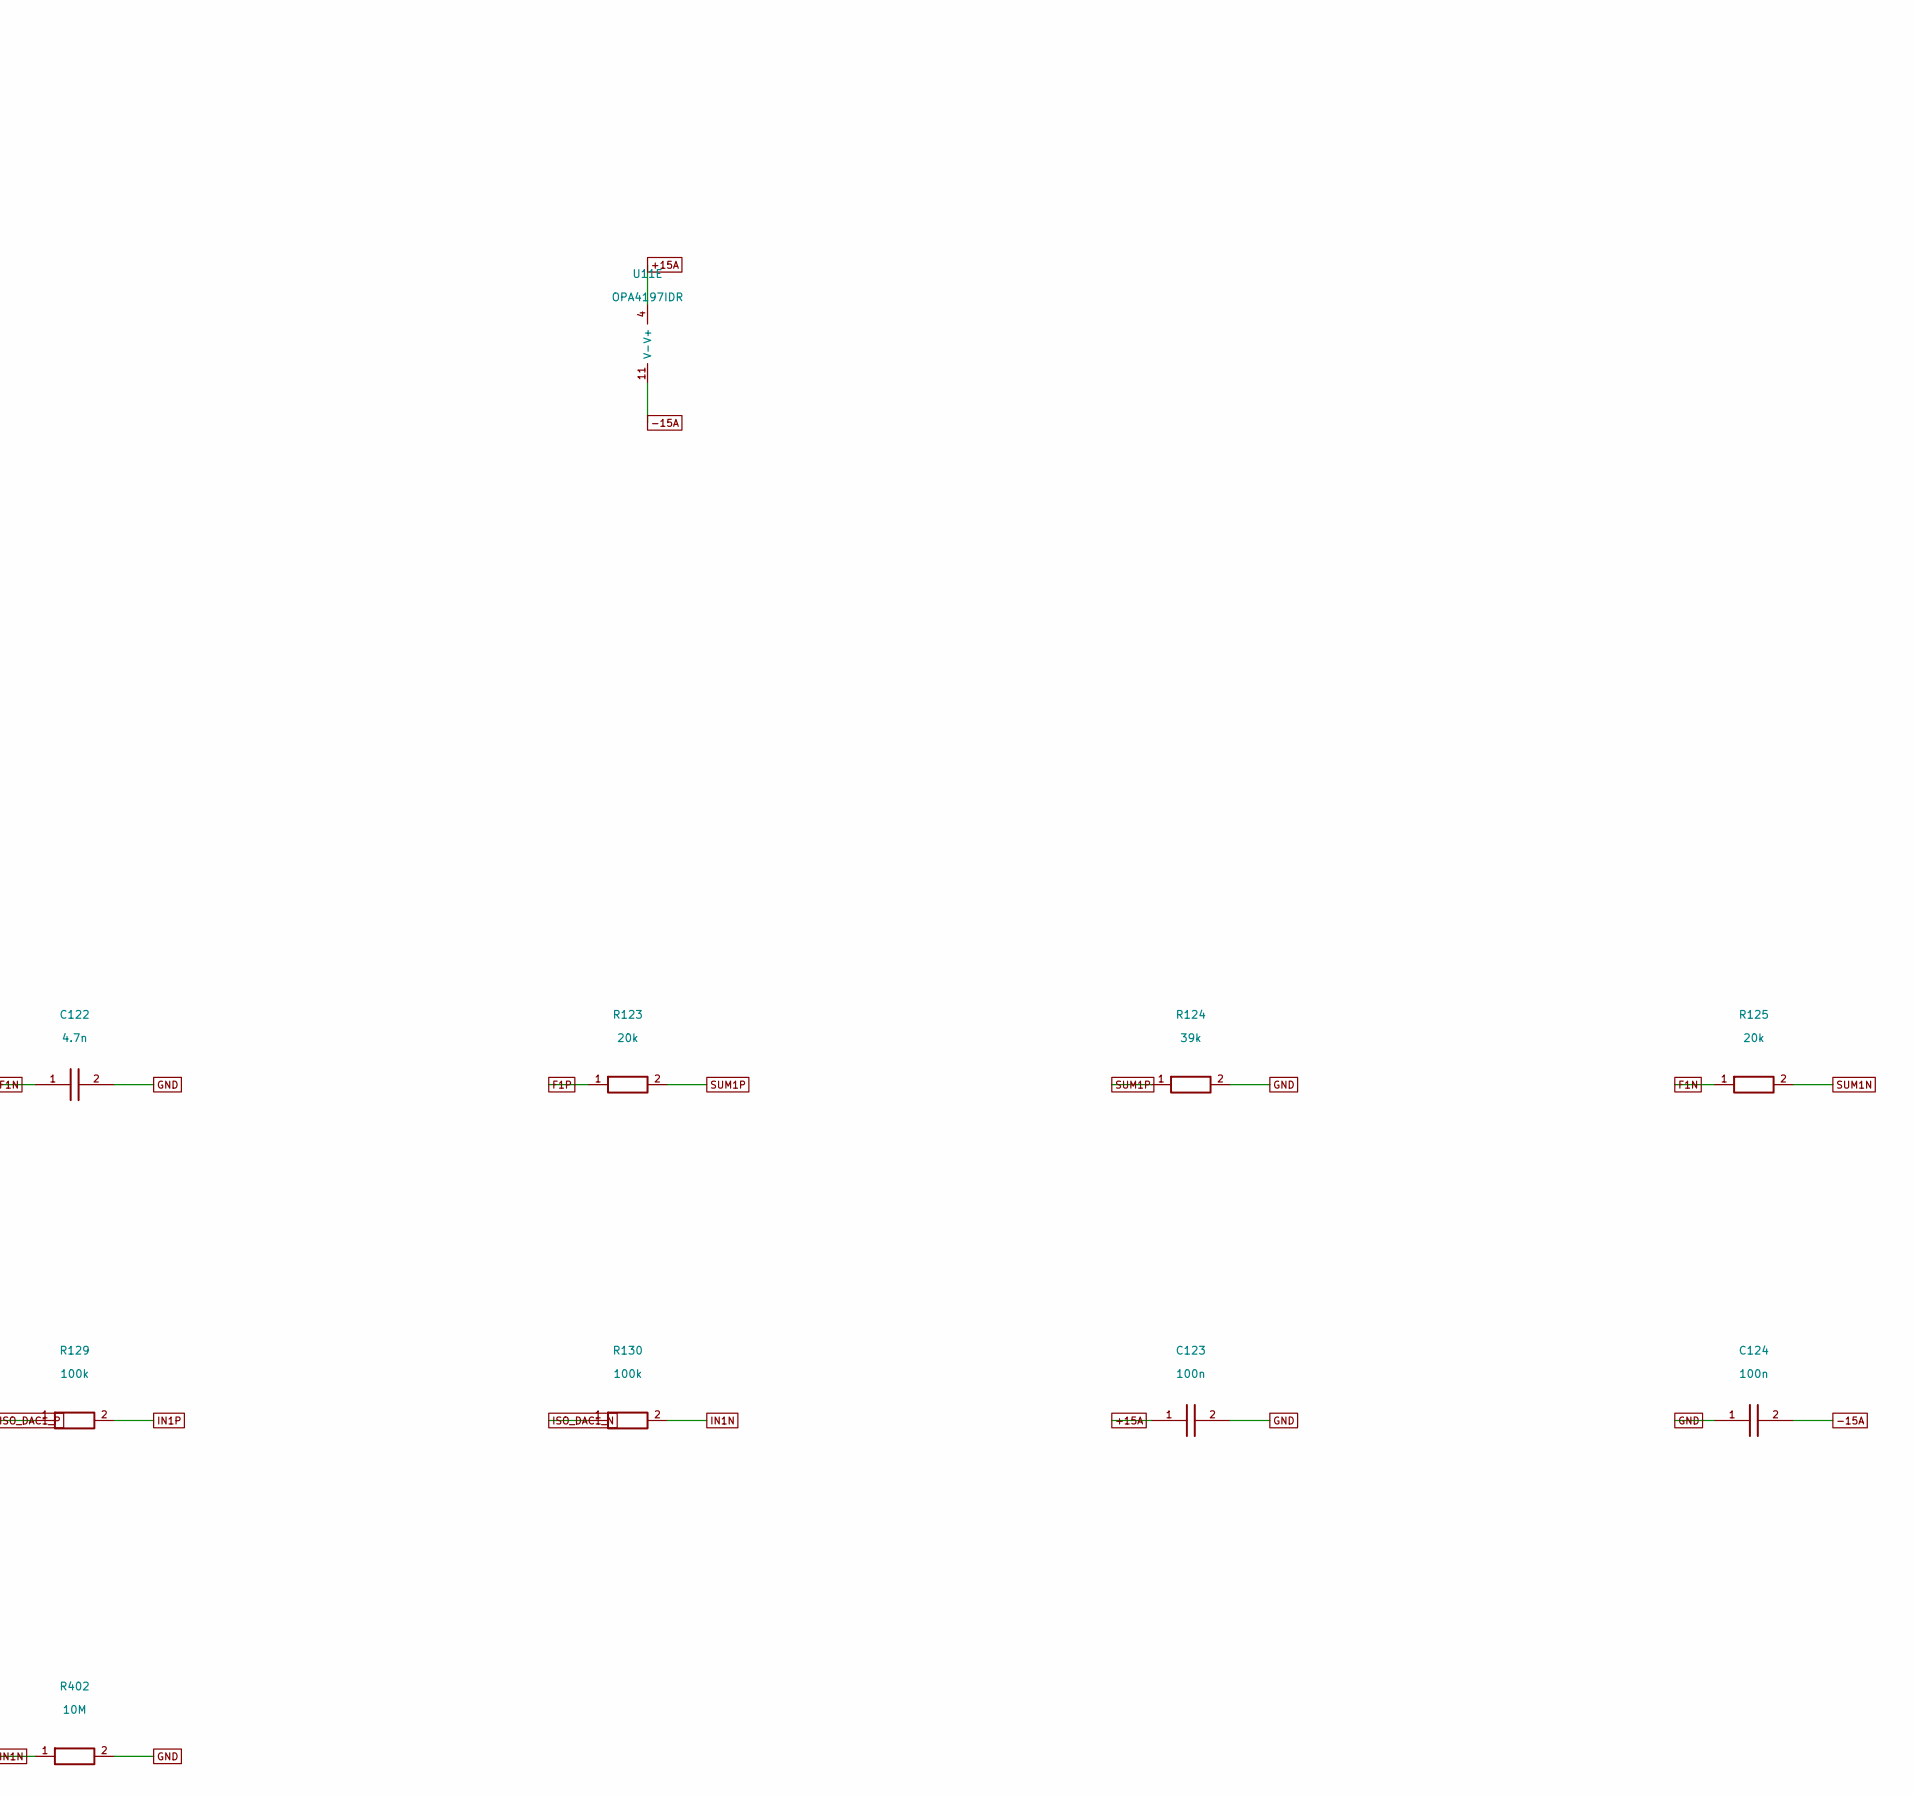
[picture p16: schematic CH1_X.kicad_sch, ILDA8CH RevB-P4 / CH1_X, part in row 1, column 2]

Parts:
C121, C122: 4.7n; Capacitor_SMD__C_0603_1608Metric; MPN GRM1885C1H472JA01D; LCSC C85980
C123, C124: 100n; Capacitor_SMD__C_0603_1608Metric; MPN GRM188R71H104KA93D; LCSC C77055
C125, C126: 4.7u; Capacitor_SMD__C_0805_2012Metric; MPN GRM21BR61E475KA12L; LCSC C77077
R121, R122: 1k; Resistor_SMD__R_0603_1608Metric; MPN RT0603BRD071KL; LCSC C110776
R123, R125: 20k; Resistor_SMD__R_0603_1608Metric; MPN RT0603BRD0720KL; LCSC C723637
R124, R126: 39k; Resistor_SMD__R_0603_1608Metric; MPN RT0603BRD0739KL; LCSC C309652
R127, R128: 10k; Resistor_SMD__R_0603_1608Metric; MPN RT0603BRD0710KL; LCSC C95204
R129, R130: 100k; Resistor_SMD__R_0603_1608Metric; MPN RC0603FR-07100KL; LCSC C14675
R401, R402: 10M; Resistor_SMD__R_0603_1608Metric; MPN RC0603FR-0710ML; LCSC C114606
U11: OPA4197IDR; Package_SO__SOIC-14_3.9x8.7mm_P1.27mm; MPN OPA4197IDR; LCSC C2058532

Connections:
+15A: C123.1, C125.1, U11.4 (V+); also elsewhere on the board
-15A: C124.2, C126.2, U11.11 (V-); also elsewhere on the board
B1N: R122.1, U11.6 (-), U11.7 (OUT)
B1P: R121.1, U11.1 (OUT), U11.2 (-)
F1N: C122.1, R122.2, R125.1
F1P: C121.1, R121.2, R123.1
GND: C121.2, C122.2, C123.2, C124.1, C125.2, C126.1, R124.2, R401.2, R402.2, U11.12 (+); also elsewhere on the board
IN1N: R130.2, R402.1, U11.5 (+)
IN1P: R129.2, R401.1, U11.3 (+)
INV1: R127.2, R128.2, U11.13 (-)
ISO_DAC1_N: R130.1; also elsewhere on the board
ISO_DAC1_P: R129.1; also elsewhere on the board
SUM1N: R125.2, R126.2, U11.9 (-)
SUM1P: R123.2, R124.1, U11.10 (+)
X_DRV_N: R128.1, U11.14 (OUT); also elsewhere on the board
X_DRV_P: R126.1, R127.1, U11.8 (OUT); also elsewhere on the board

Notes on the sheet:
DC coupled. Physical pin numbers; net names are global and channel-unique.
X/Y DC gain = 39k/(20k+1k); colour gain = 20k/(20k+1k). Calibrate in firmware.
A/B: unity-gain input buffers. C: matched subtractor. D: complementary driver.

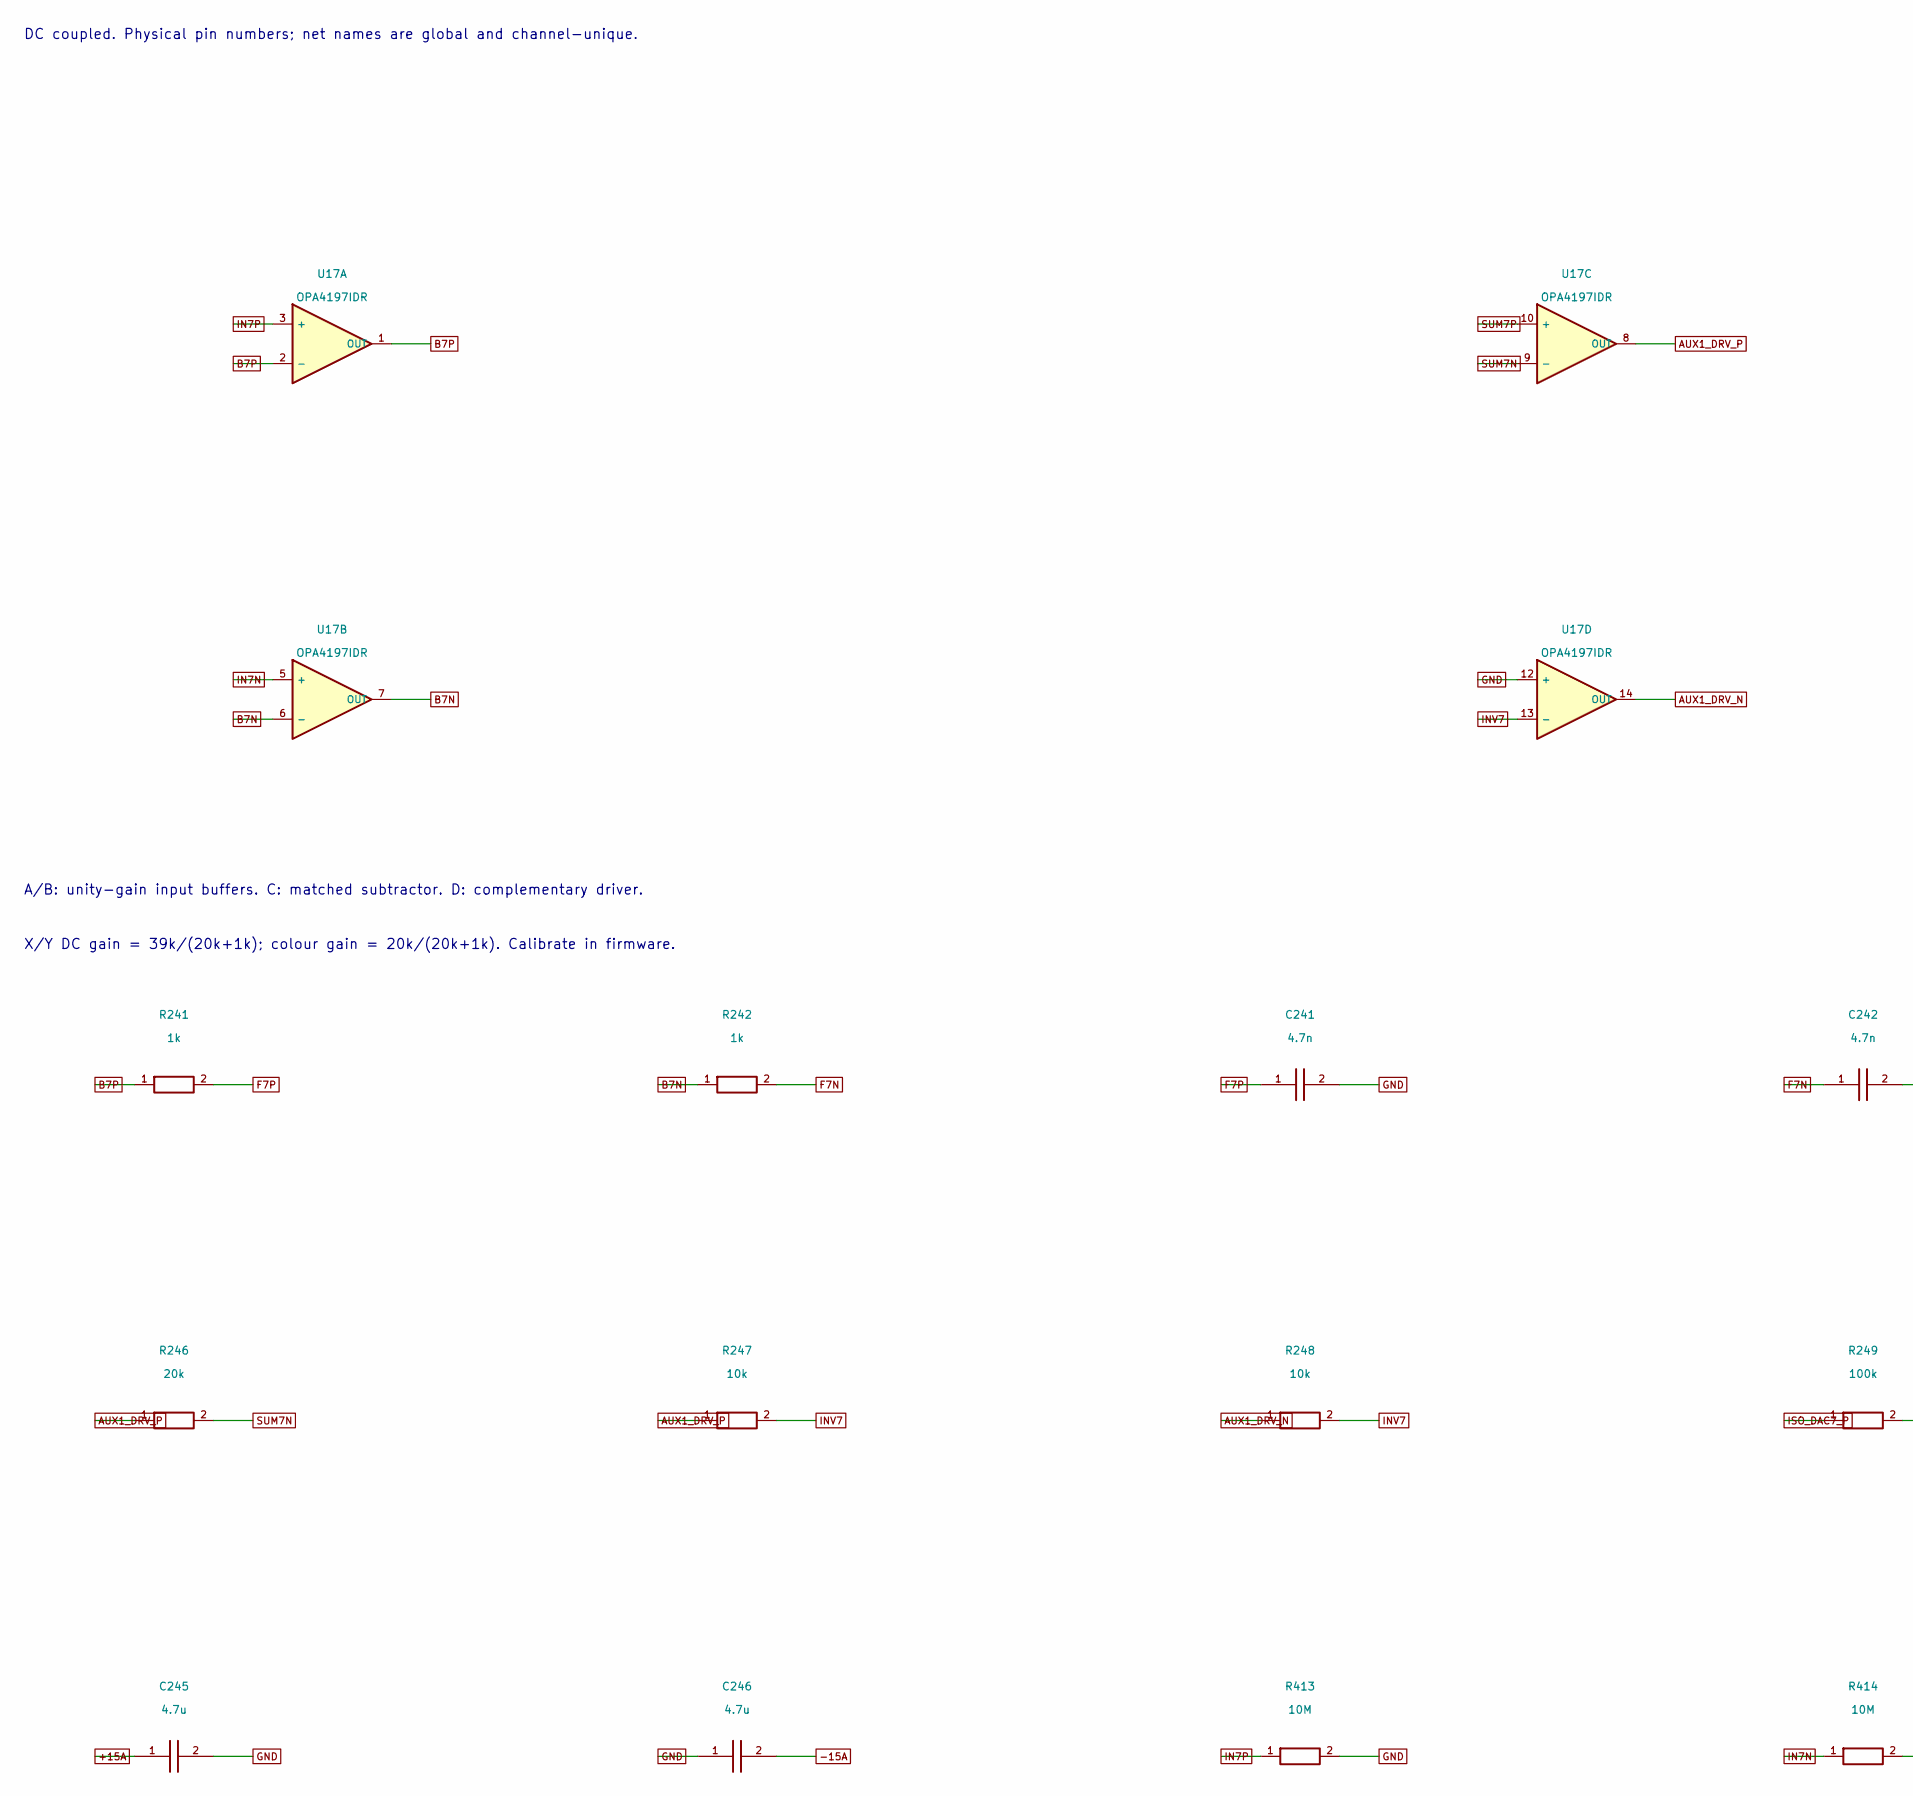
[picture p17: schematic CH7_AUX1.kicad_sch, ILDA8CH RevB-P4 / CH7_AUX1, part in row 1, column 1]

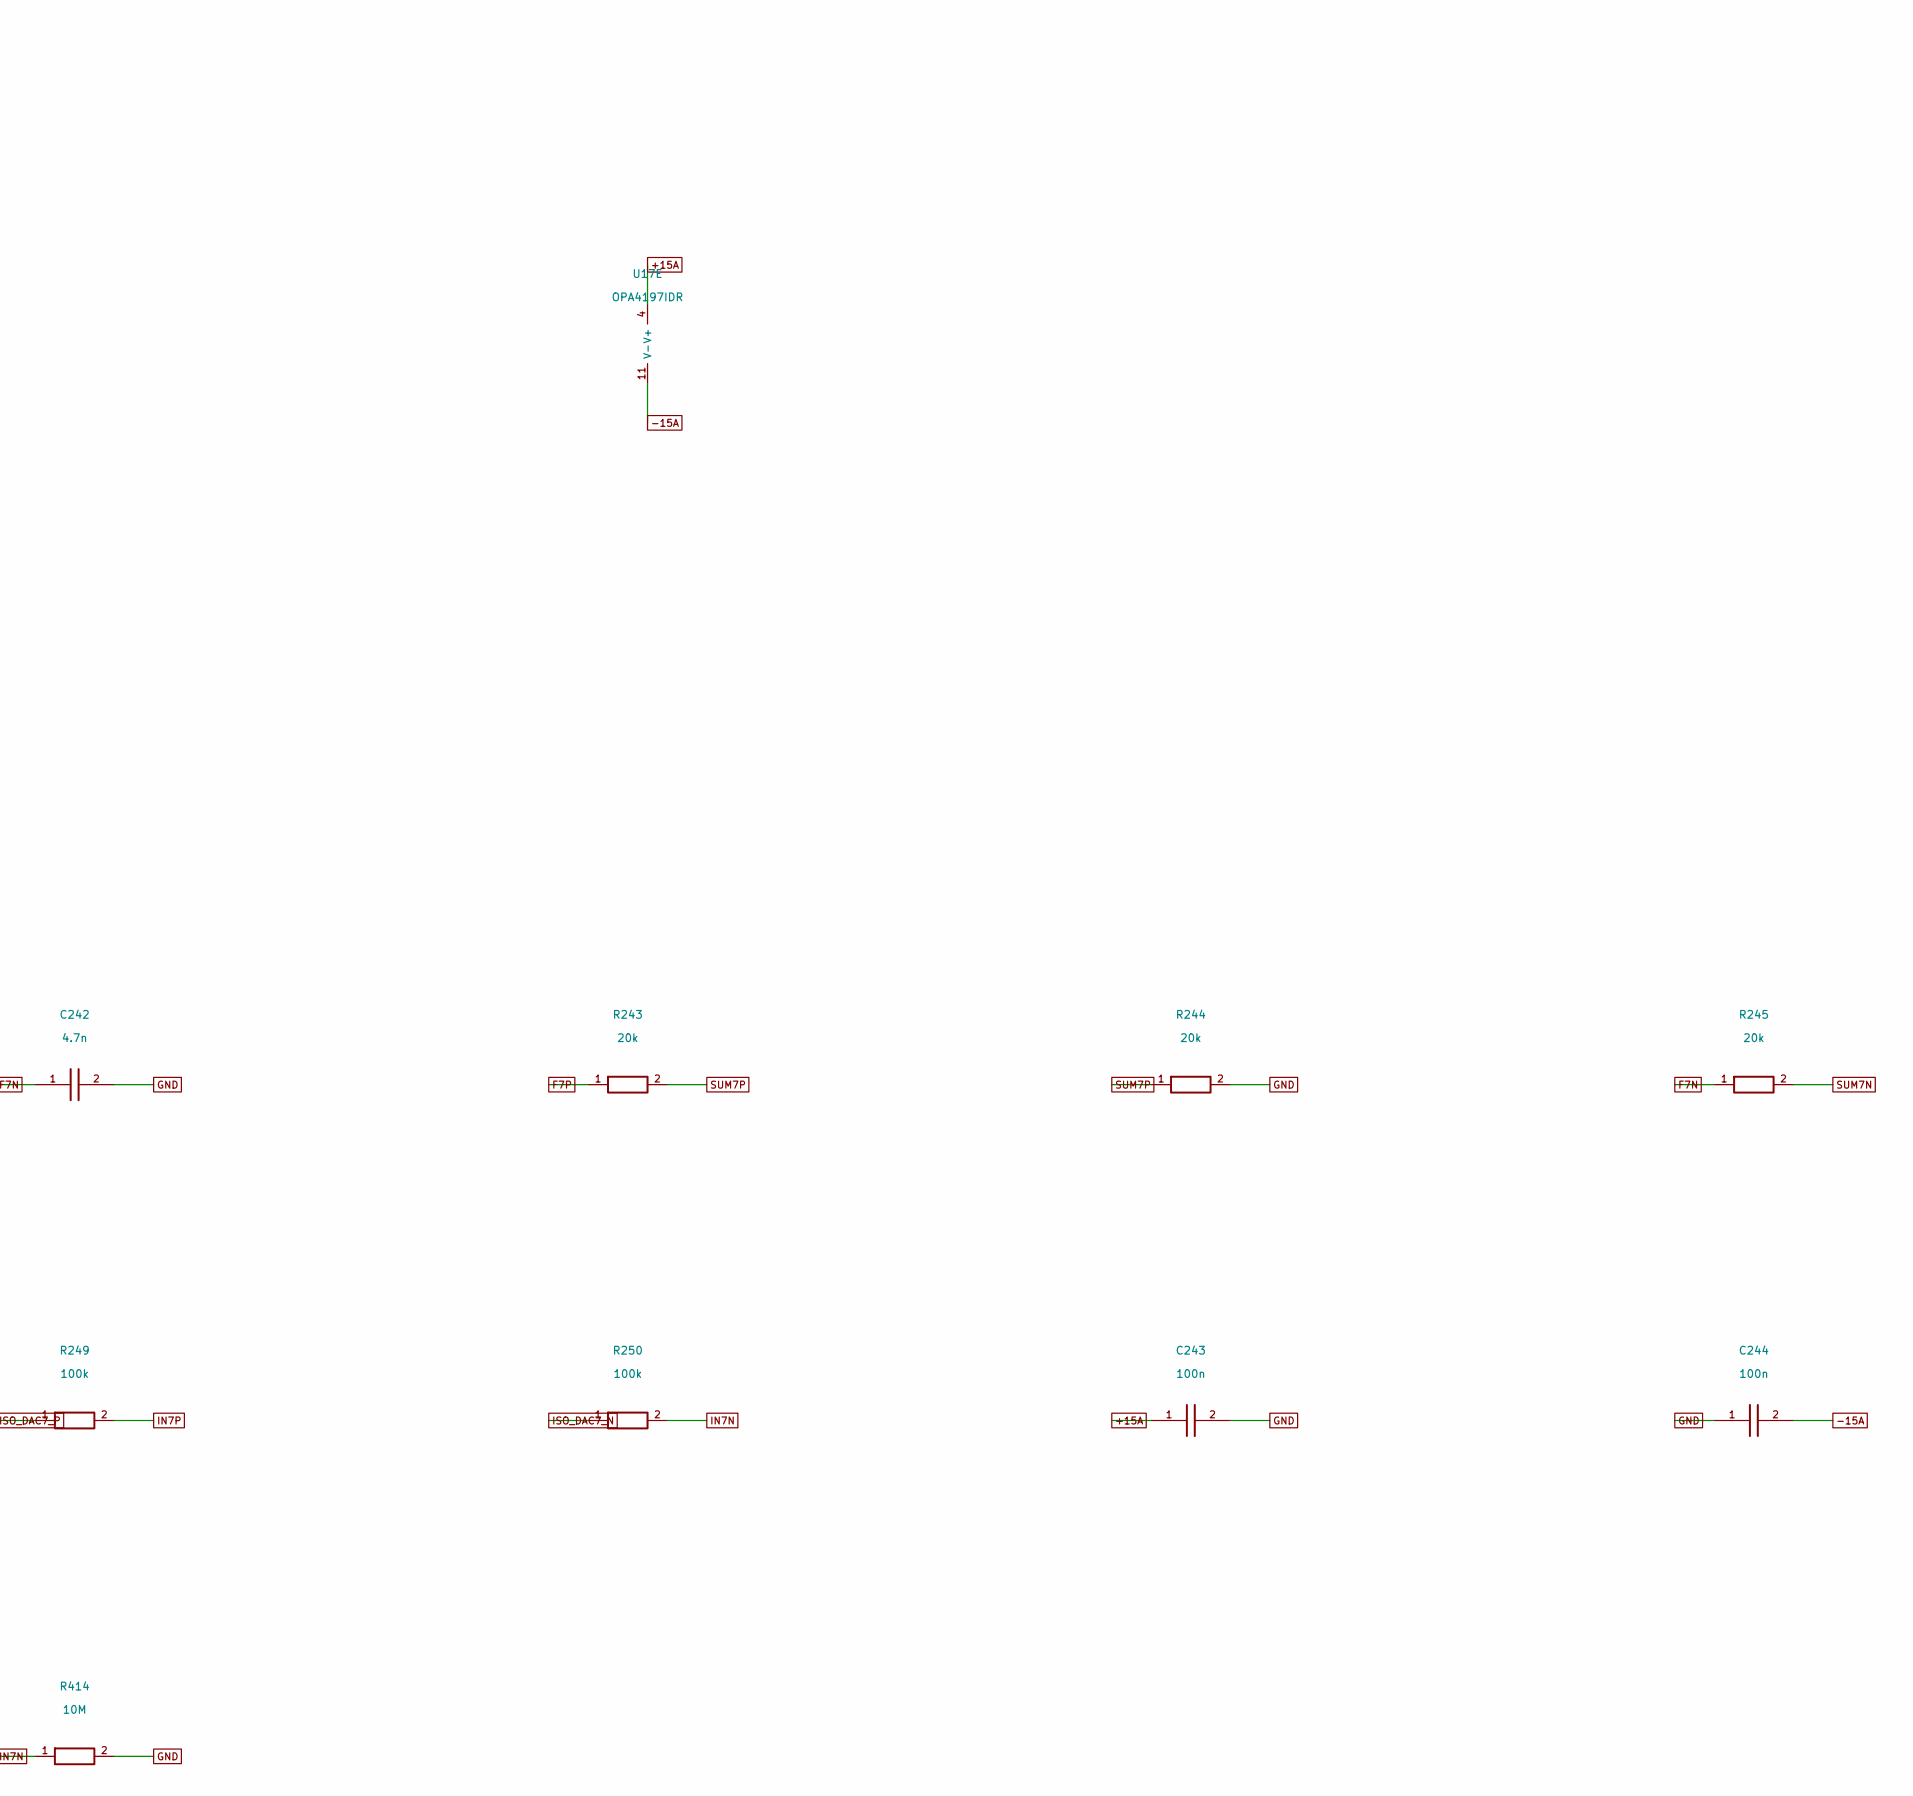
[picture p18: schematic CH7_AUX1.kicad_sch, ILDA8CH RevB-P4 / CH7_AUX1, part in row 1, column 2]

Parts:
C241, C242: 4.7n; Capacitor_SMD__C_0603_1608Metric; MPN GRM1885C1H472JA01D; LCSC C85980
C243, C244: 100n; Capacitor_SMD__C_0603_1608Metric; MPN GRM188R71H104KA93D; LCSC C77055
C245, C246: 4.7u; Capacitor_SMD__C_0805_2012Metric; MPN GRM21BR61E475KA12L; LCSC C77077
R241, R242: 1k; Resistor_SMD__R_0603_1608Metric; MPN RT0603BRD071KL; LCSC C110776
R243, R244, R245, R246: 20k; Resistor_SMD__R_0603_1608Metric; MPN RT0603BRD0720KL; LCSC C723637
R247, R248: 10k; Resistor_SMD__R_0603_1608Metric; MPN RT0603BRD0710KL; LCSC C95204
R249, R250: 100k; Resistor_SMD__R_0603_1608Metric; MPN RC0603FR-07100KL; LCSC C14675
R413, R414: 10M; Resistor_SMD__R_0603_1608Metric; MPN RC0603FR-0710ML; LCSC C114606
U17: OPA4197IDR; Package_SO__SOIC-14_3.9x8.7mm_P1.27mm; MPN OPA4197IDR; LCSC C2058532

Connections:
+15A: C243.1, C245.1, U17.4 (V+); also elsewhere on the board
-15A: C244.2, C246.2, U17.11 (V-); also elsewhere on the board
AUX1_DRV_N: R248.1, U17.14 (OUT); also elsewhere on the board
AUX1_DRV_P: R246.1, R247.1, U17.8 (OUT); also elsewhere on the board
B7N: R242.1, U17.6 (-), U17.7 (OUT)
B7P: R241.1, U17.1 (OUT), U17.2 (-)
F7N: C242.1, R242.2, R245.1
F7P: C241.1, R241.2, R243.1
GND: C241.2, C242.2, C243.2, C244.1, C245.2, C246.1, R244.2, R413.2, R414.2, U17.12 (+); also elsewhere on the board
IN7N: R250.2, R414.1, U17.5 (+)
IN7P: R249.2, R413.1, U17.3 (+)
INV7: R247.2, R248.2, U17.13 (-)
ISO_DAC7_N: R250.1; also elsewhere on the board
ISO_DAC7_P: R249.1; also elsewhere on the board
SUM7N: R245.2, R246.2, U17.9 (-)
SUM7P: R243.2, R244.1, U17.10 (+)

Notes on the sheet:
DC coupled. Physical pin numbers; net names are global and channel-unique.
X/Y DC gain = 39k/(20k+1k); colour gain = 20k/(20k+1k). Calibrate in firmware.
A/B: unity-gain input buffers. C: matched subtractor. D: complementary driver.
