weiweiweiopen/teensy-4-RGBgalvos/hardware/revB/KiCad/ILDA8CH.kicad_pcb

## KiCad design hardware/revB/KiCad/ILDA8CH.kicad_pcb (continued)

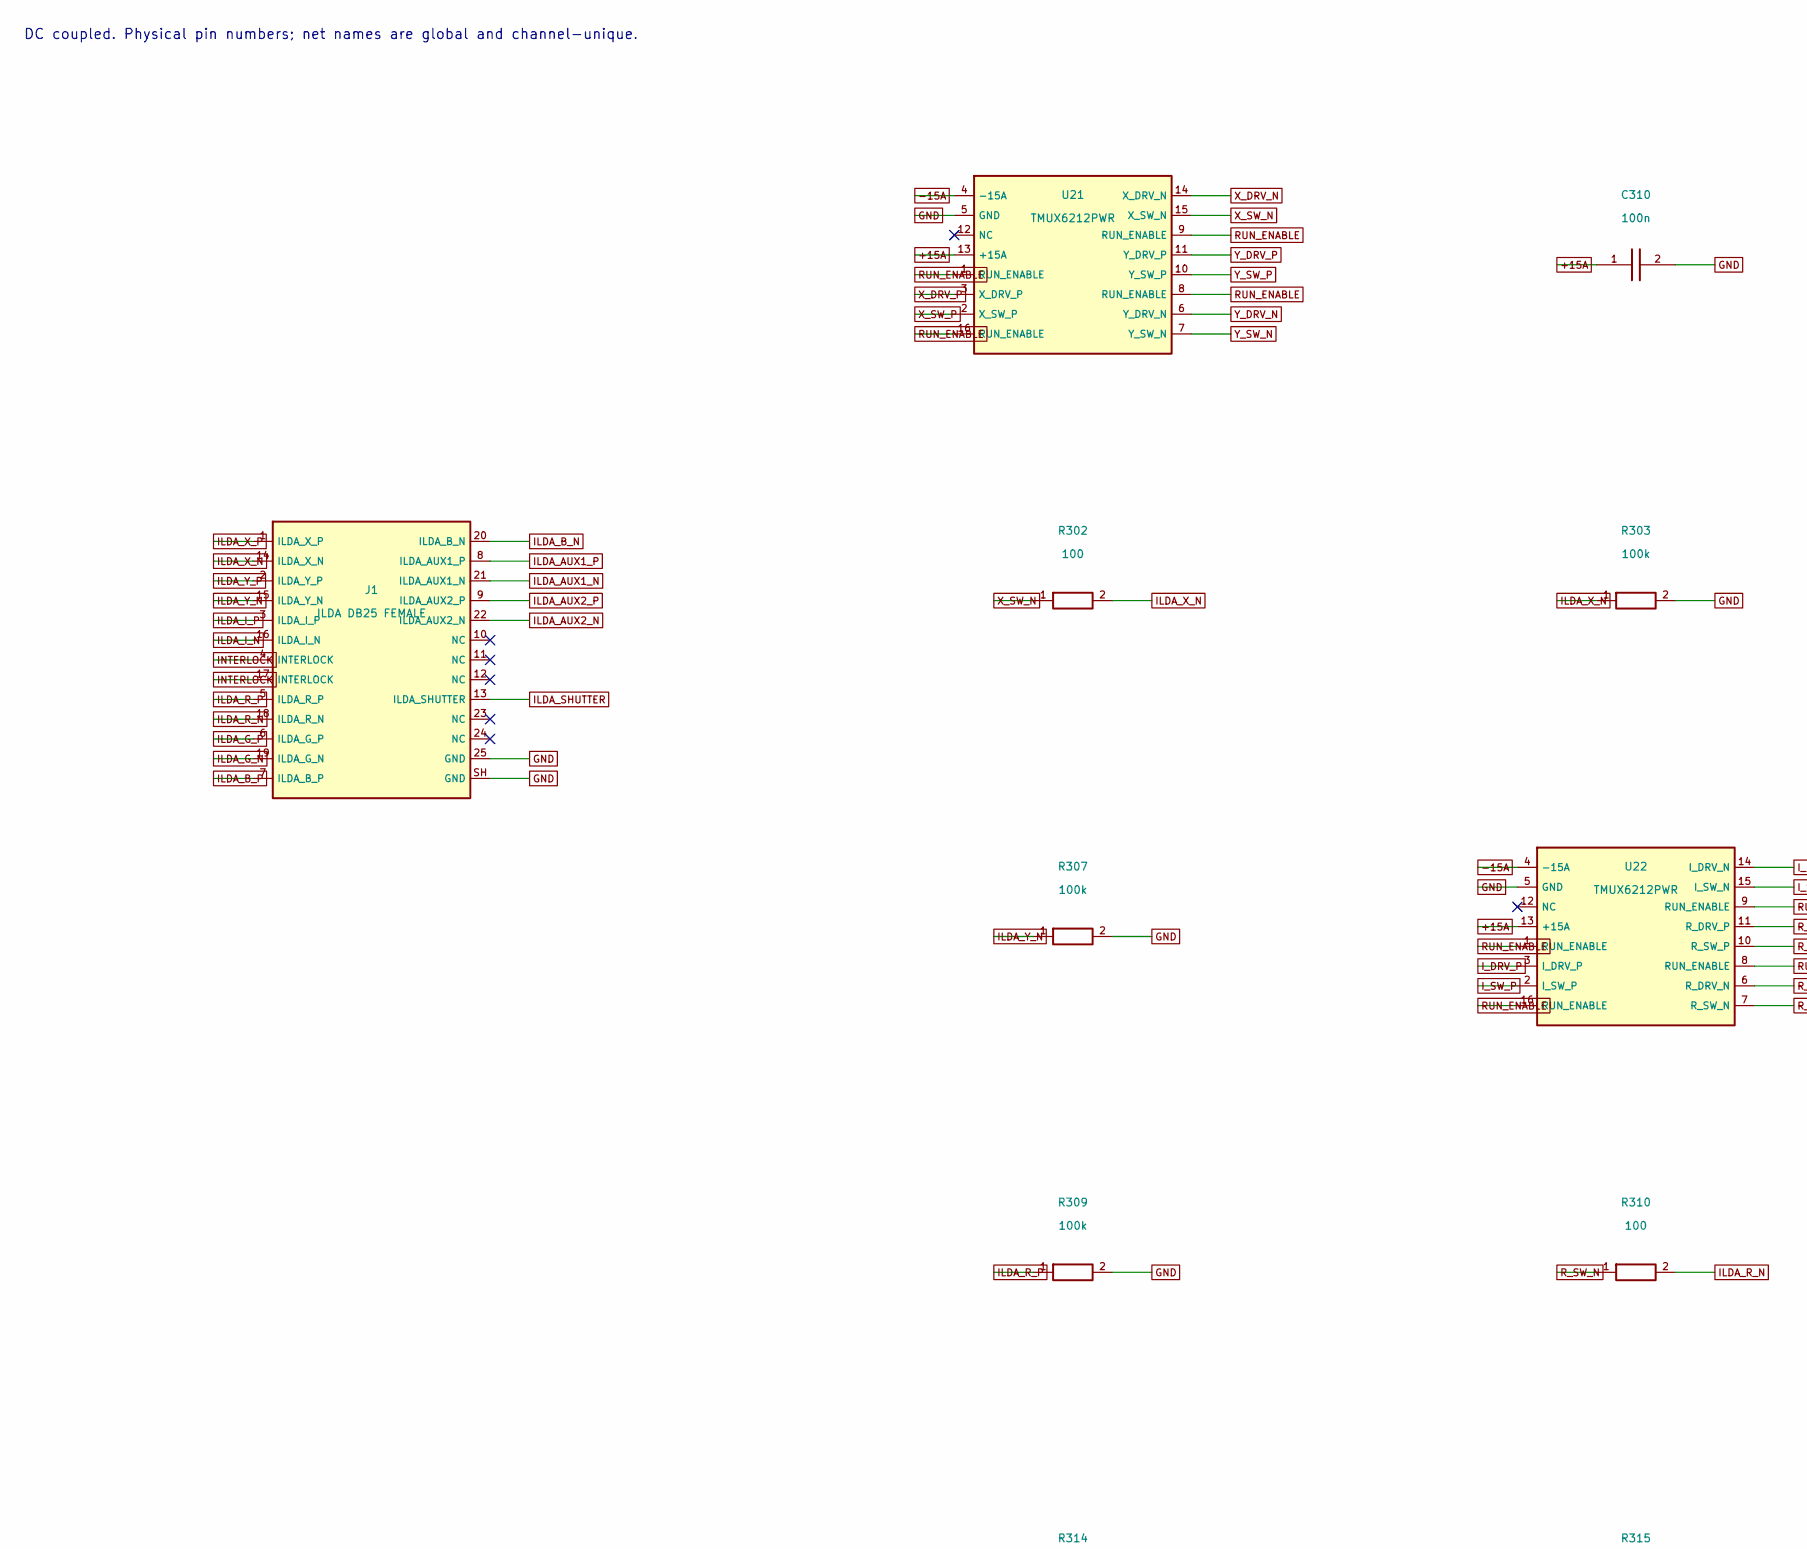
[picture p19: schematic Outputs.kicad_sch, ILDA8CH RevB-P4 / Outputs, part in row 1, column 1]

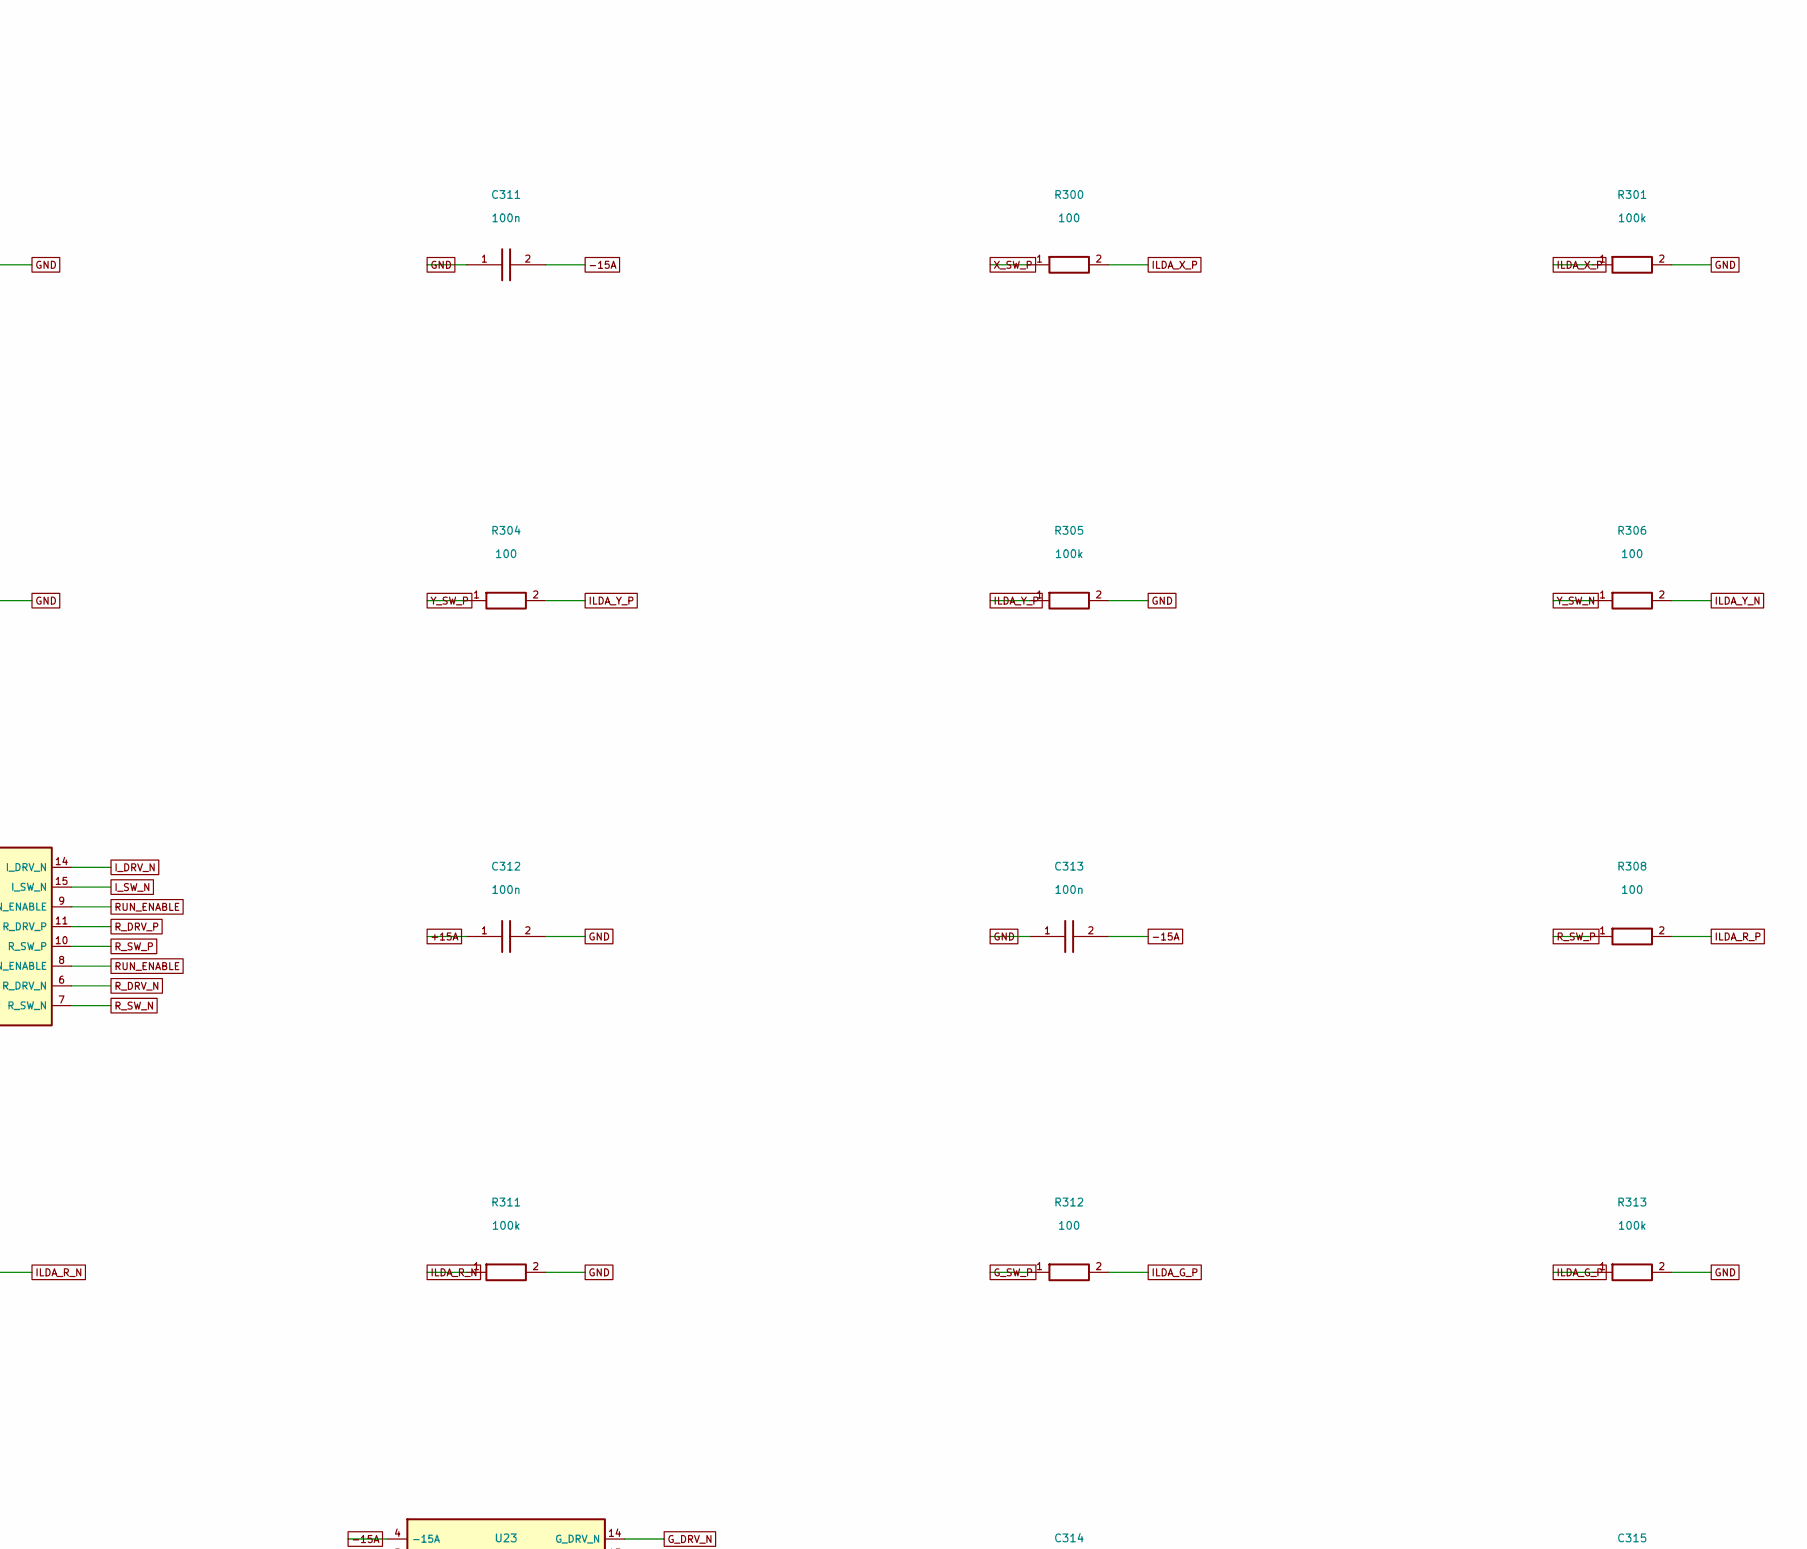
[picture p20: schematic Outputs.kicad_sch, ILDA8CH RevB-P4 / Outputs, part in row 1, column 2]

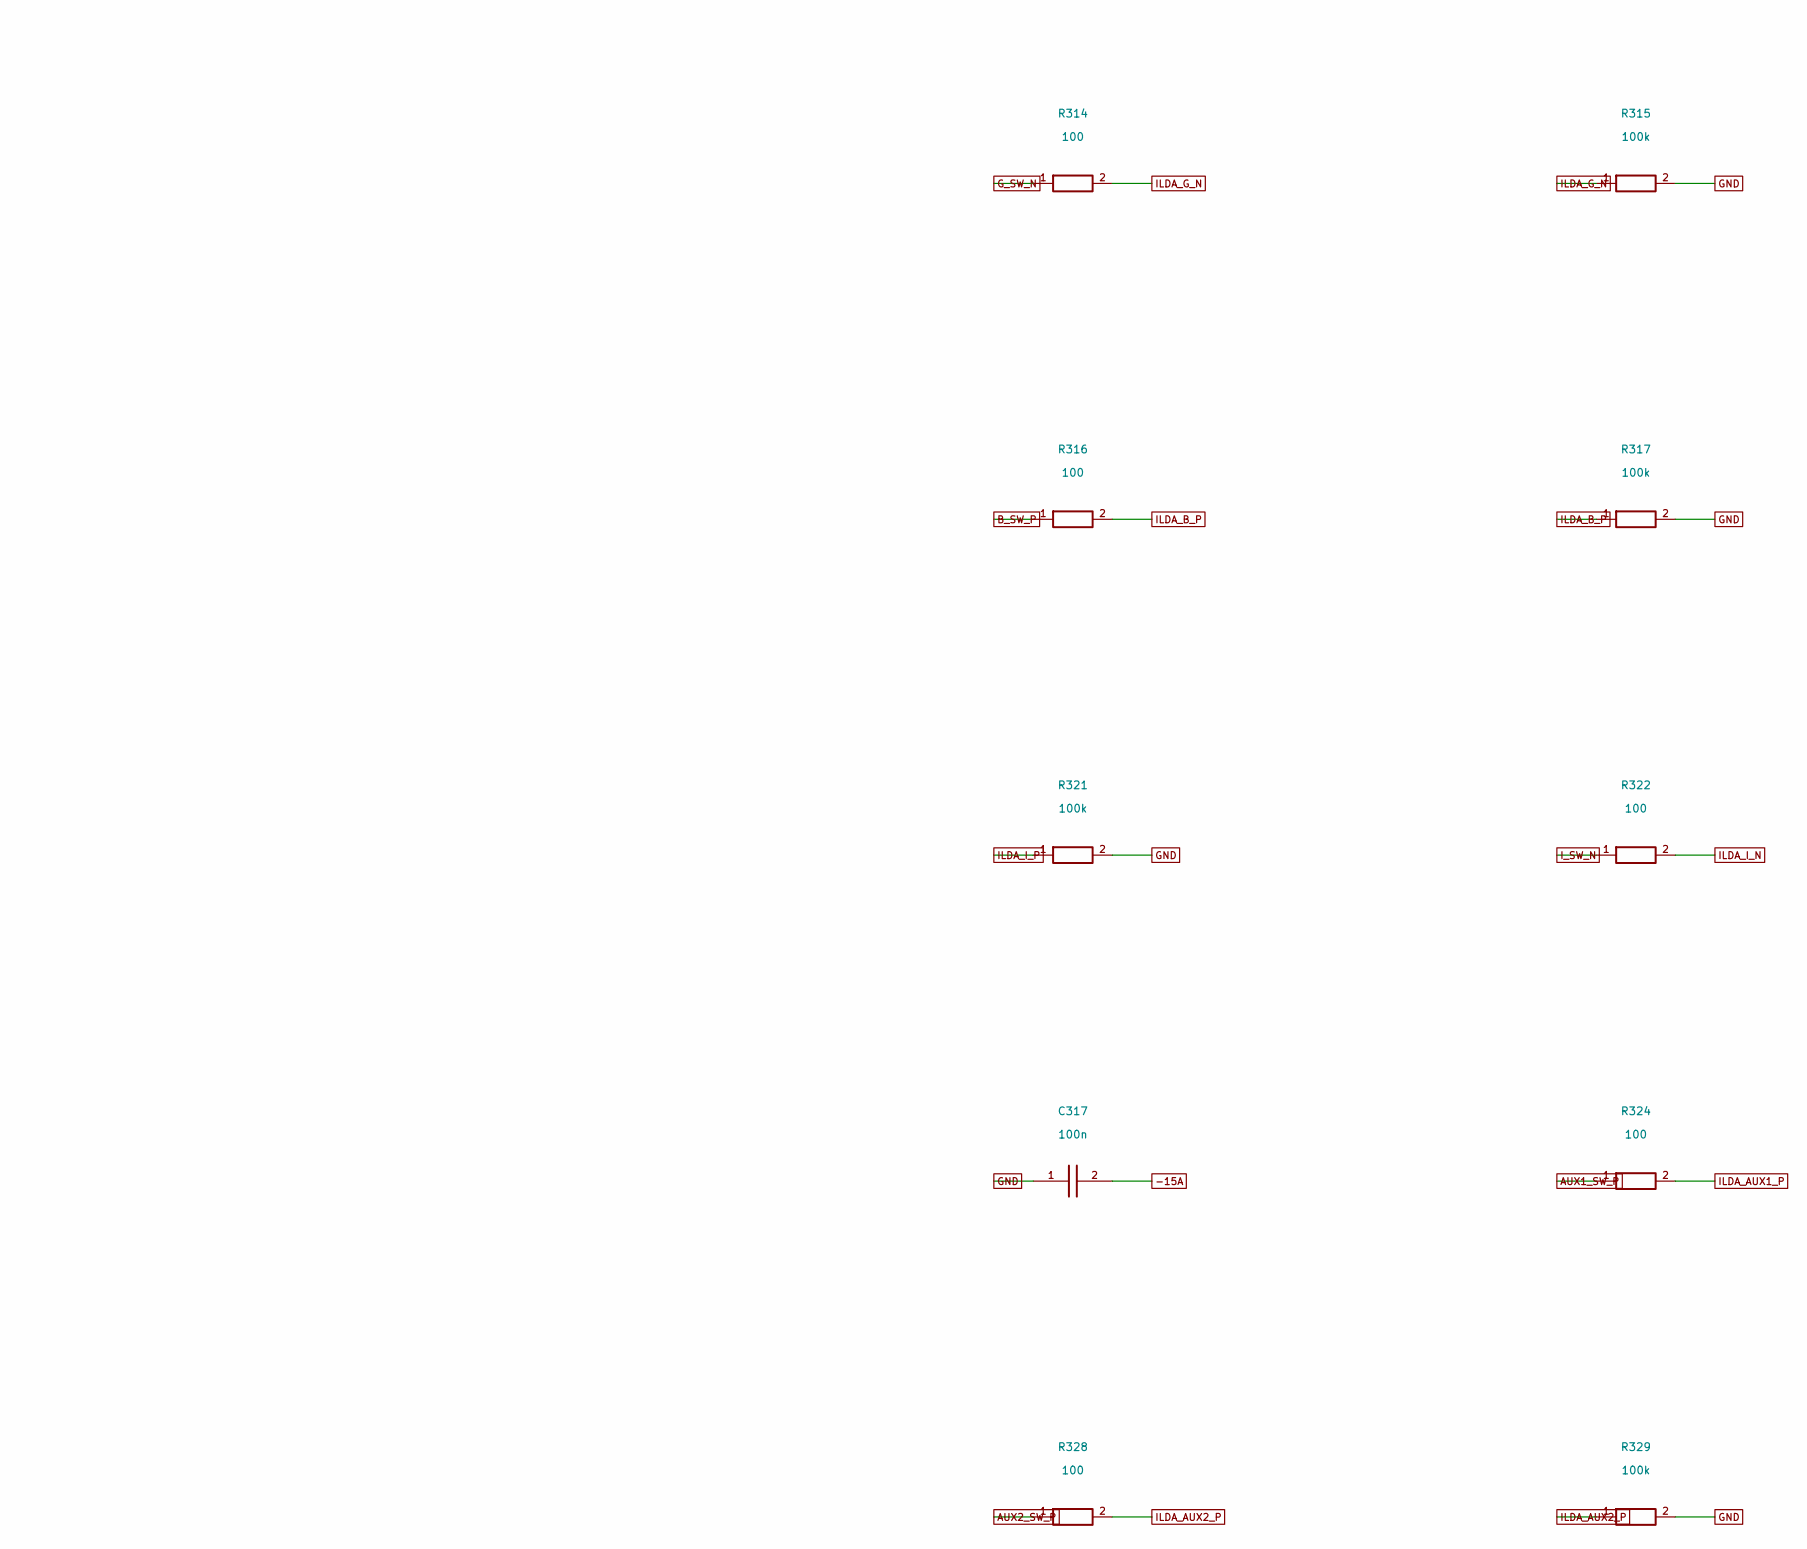
[picture p21: schematic Outputs.kicad_sch, ILDA8CH RevB-P4 / Outputs, part in row 2, column 1]

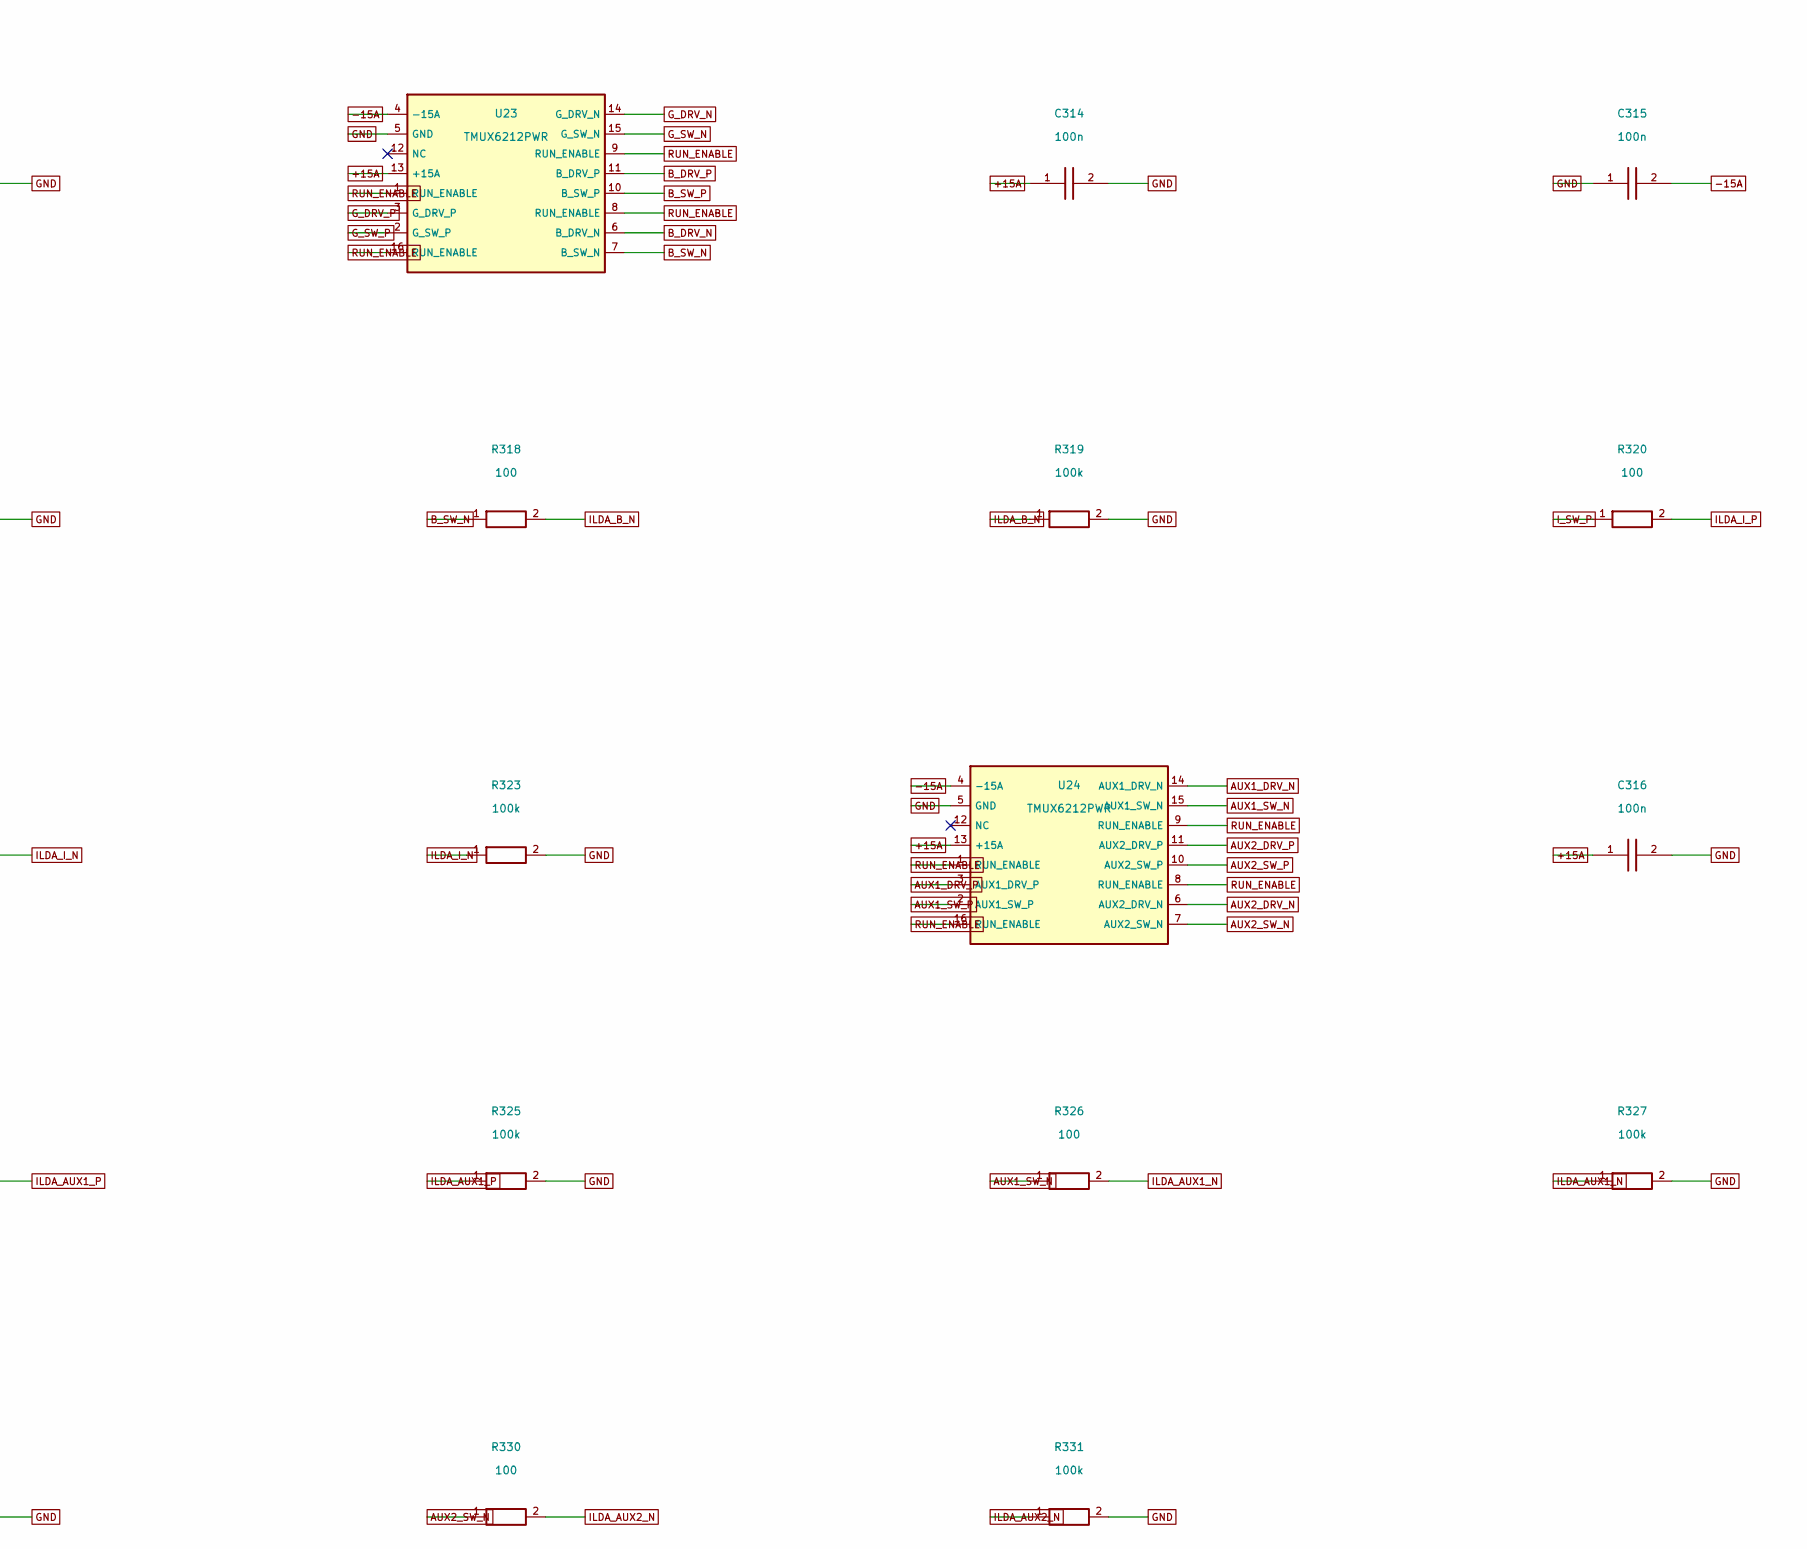
[picture p22: schematic Outputs.kicad_sch, ILDA8CH RevB-P4 / Outputs, part in row 2, column 2]

Parts:
C310, C311, C312, C313, C314, C315, C316, C317: 100n; Capacitor_SMD__C_0603_1608Metric; MPN GRM188R71H104KA93D; LCSC C77055
J1: ILDA DB25 FEMALE; Connector_Dsub__DSUB-25_Socket_Horizontal_P2.77x2.84mm_Edge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; MPN CANDIDATE: RA DB25 female, 7.70mm pin/e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
R300, R302, R304, R306, R308, R310, R312, R314, R316, R318, R320, R322, R324, R326, R328, R330: 100; Resistor_SMD__R_2512_6332Metric; MPN RC2512FK-07100RL; LCSC C309603
R301, R303, R305, R307, R309, R311, R313, R315, R317, R319, R321, R323, R325, R327, R329, R331: 100k; Resistor_SMD__R_0603_1608Metric; MPN RC0603FR-07100KL; LCSC C14675
U21, U22, U23, U24: TMUX6212PWR; Package_SO__TSSOP-16_4.4x5mm_P0.65mm; MPN TMUX6212PWR; LCSC C2902526

Connections:
+15A: C310.1, C312.1, C314.1, C316.1, U21.13 (+15A), U22.13 (+15A), U23.13 (+15A), U24.13 (+15A); also elsewhere on the board
-15A: C311.2, C313.2, C315.2, C317.2, U21.4 (-15A), U22.4 (-15A), U23.4 (-15A), U24.4 (-15A); also elsewhere on the board
AUX1_DRV_N: U24.14 (AUX1_DRV_N); also elsewhere on the board
AUX1_DRV_P: U24.3 (AUX1_DRV_P); also elsewhere on the board
AUX1_SW_N: R326.1, U24.15 (AUX1_SW_N)
AUX1_SW_P: R324.1, U24.2 (AUX1_SW_P)
AUX2_DRV_N: U24.6 (AUX2_DRV_N); also elsewhere on the board
AUX2_DRV_P: U24.11 (AUX2_DRV_P); also elsewhere on the board
AUX2_SW_N: R330.1, U24.7 (AUX2_SW_N)
AUX2_SW_P: R328.1, U24.10 (AUX2_SW_P)
B_DRV_N: U23.6 (B_DRV_N); also elsewhere on the board
B_DRV_P: U23.11 (B_DRV_P); also elsewhere on the board
B_SW_N: R318.1, U23.7 (B_SW_N)
B_SW_P: R316.1, U23.10 (B_SW_P)
GND: C310.2, C311.1, C312.2, C313.1, C314.2, C315.1, C316.2, C317.1, J1.25 (GND), J1.SH (GND), R301.2, R303.2, R305.2, R307.2, R309.2, R311.2, R313.2, R315.2, R317.2, R319.2, R321.2, R323.2, R325.2, R327.2, R329.2, R331.2, U21.5 (GND), U22.5 (GND), U23.5 (GND), U24.5 (GND); also elsewhere on the board
G_DRV_N: U23.14 (G_DRV_N); also elsewhere on the board
G_DRV_P: U23.3 (G_DRV_P); also elsewhere on the board
G_SW_N: R314.1, U23.15 (G_SW_N)
G_SW_P: R312.1, U23.2 (G_SW_P)
ILDA_AUX1_N: J1.21 (ILDA_AUX1_N), R326.2, R327.1
ILDA_AUX1_P: J1.8 (ILDA_AUX1_P), R324.2, R325.1
ILDA_AUX2_N: J1.22 (ILDA_AUX2_N), R330.2, R331.1
ILDA_AUX2_P: J1.9 (ILDA_AUX2_P), R328.2, R329.1
ILDA_B_N: J1.20 (ILDA_B_N), R318.2, R319.1
ILDA_B_P: J1.7 (ILDA_B_P), R316.2, R317.1
ILDA_G_N: J1.19 (ILDA_G_N), R314.2, R315.1
ILDA_G_P: J1.6 (ILDA_G_P), R312.2, R313.1
ILDA_I_N: J1.16 (ILDA_I_N), R322.2, R323.1
ILDA_I_P: J1.3 (ILDA_I_P), R320.2, R321.1
ILDA_R_N: J1.18 (ILDA_R_N), R310.2, R311.1
ILDA_R_P: J1.5 (ILDA_R_P), R308.2, R309.1
ILDA_SHUTTER: J1.13 (ILDA_SHUTTER); also elsewhere on the board
ILDA_X_N: J1.14 (ILDA_X_N), R302.2, R303.1
ILDA_X_P: J1.1 (ILDA_X_P), R300.2, R301.1
ILDA_Y_N: J1.15 (ILDA_Y_N), R306.2, R307.1
ILDA_Y_P: J1.2 (ILDA_Y_P), R304.2, R305.1
INTERLOCK: J1.4 (INTERLOCK), J1.17 (INTERLOCK)
I_DRV_N: U22.14 (I_DRV_N); also elsewhere on the board
I_DRV_P: U22.3 (I_DRV_P); also elsewhere on the board
I_SW_N: R322.1, U22.15 (I_SW_N)
I_SW_P: R320.1, U22.2 (I_SW_P)
RUN_ENABLE: U21.1 (RUN_ENABLE), U21.8 (RUN_ENABLE), U21.9 (RUN_ENABLE), U21.16 (RUN_ENABLE), U22.1 (RUN_ENABLE), U22.8 (RUN_ENABLE), U22.9 (RUN_ENABLE), U22.16 (RUN_ENABLE), U23.1 (RUN_ENABLE), U23.8 (RUN_ENABLE), U23.9 (RUN_ENABLE), U23.16 (RUN_ENABLE), U24.1 (RUN_ENABLE), U24.8 (RUN_ENABLE), U24.9 (RUN_ENABLE), U24.16 (RUN_ENABLE); also elsewhere on the board
R_DRV_N: U22.6 (R_DRV_N); also elsewhere on the board
R_DRV_P: U22.11 (R_DRV_P); also elsewhere on the board
R_SW_N: R310.1, U22.7 (R_SW_N)
R_SW_P: R308.1, U22.10 (R_SW_P)
X_DRV_N: U21.14 (X_DRV_N); also elsewhere on the board
X_DRV_P: U21.3 (X_DRV_P); also elsewhere on the board
X_SW_N: R302.1, U21.15 (X_SW_N)
X_SW_P: R300.1, U21.2 (X_SW_P)
Y_DRV_N: U21.6 (Y_DRV_N); also elsewhere on the board
Y_DRV_P: U21.11 (Y_DRV_P); also elsewhere on the board
Y_SW_N: R306.1, U21.7 (Y_SW_N)
Y_SW_P: R304.1, U21.10 (Y_SW_P)

Notes on the sheet:
DC coupled. Physical pin numbers; net names are global and channel-unique.
