weiweiweiopen/teensy-4-RGBgalvos/hardware/revB/KiCad/ILDA8CH.kicad_pcb

## KiCad design hardware/revB/KiCad/ILDA8CH.kicad_pcb (continued)

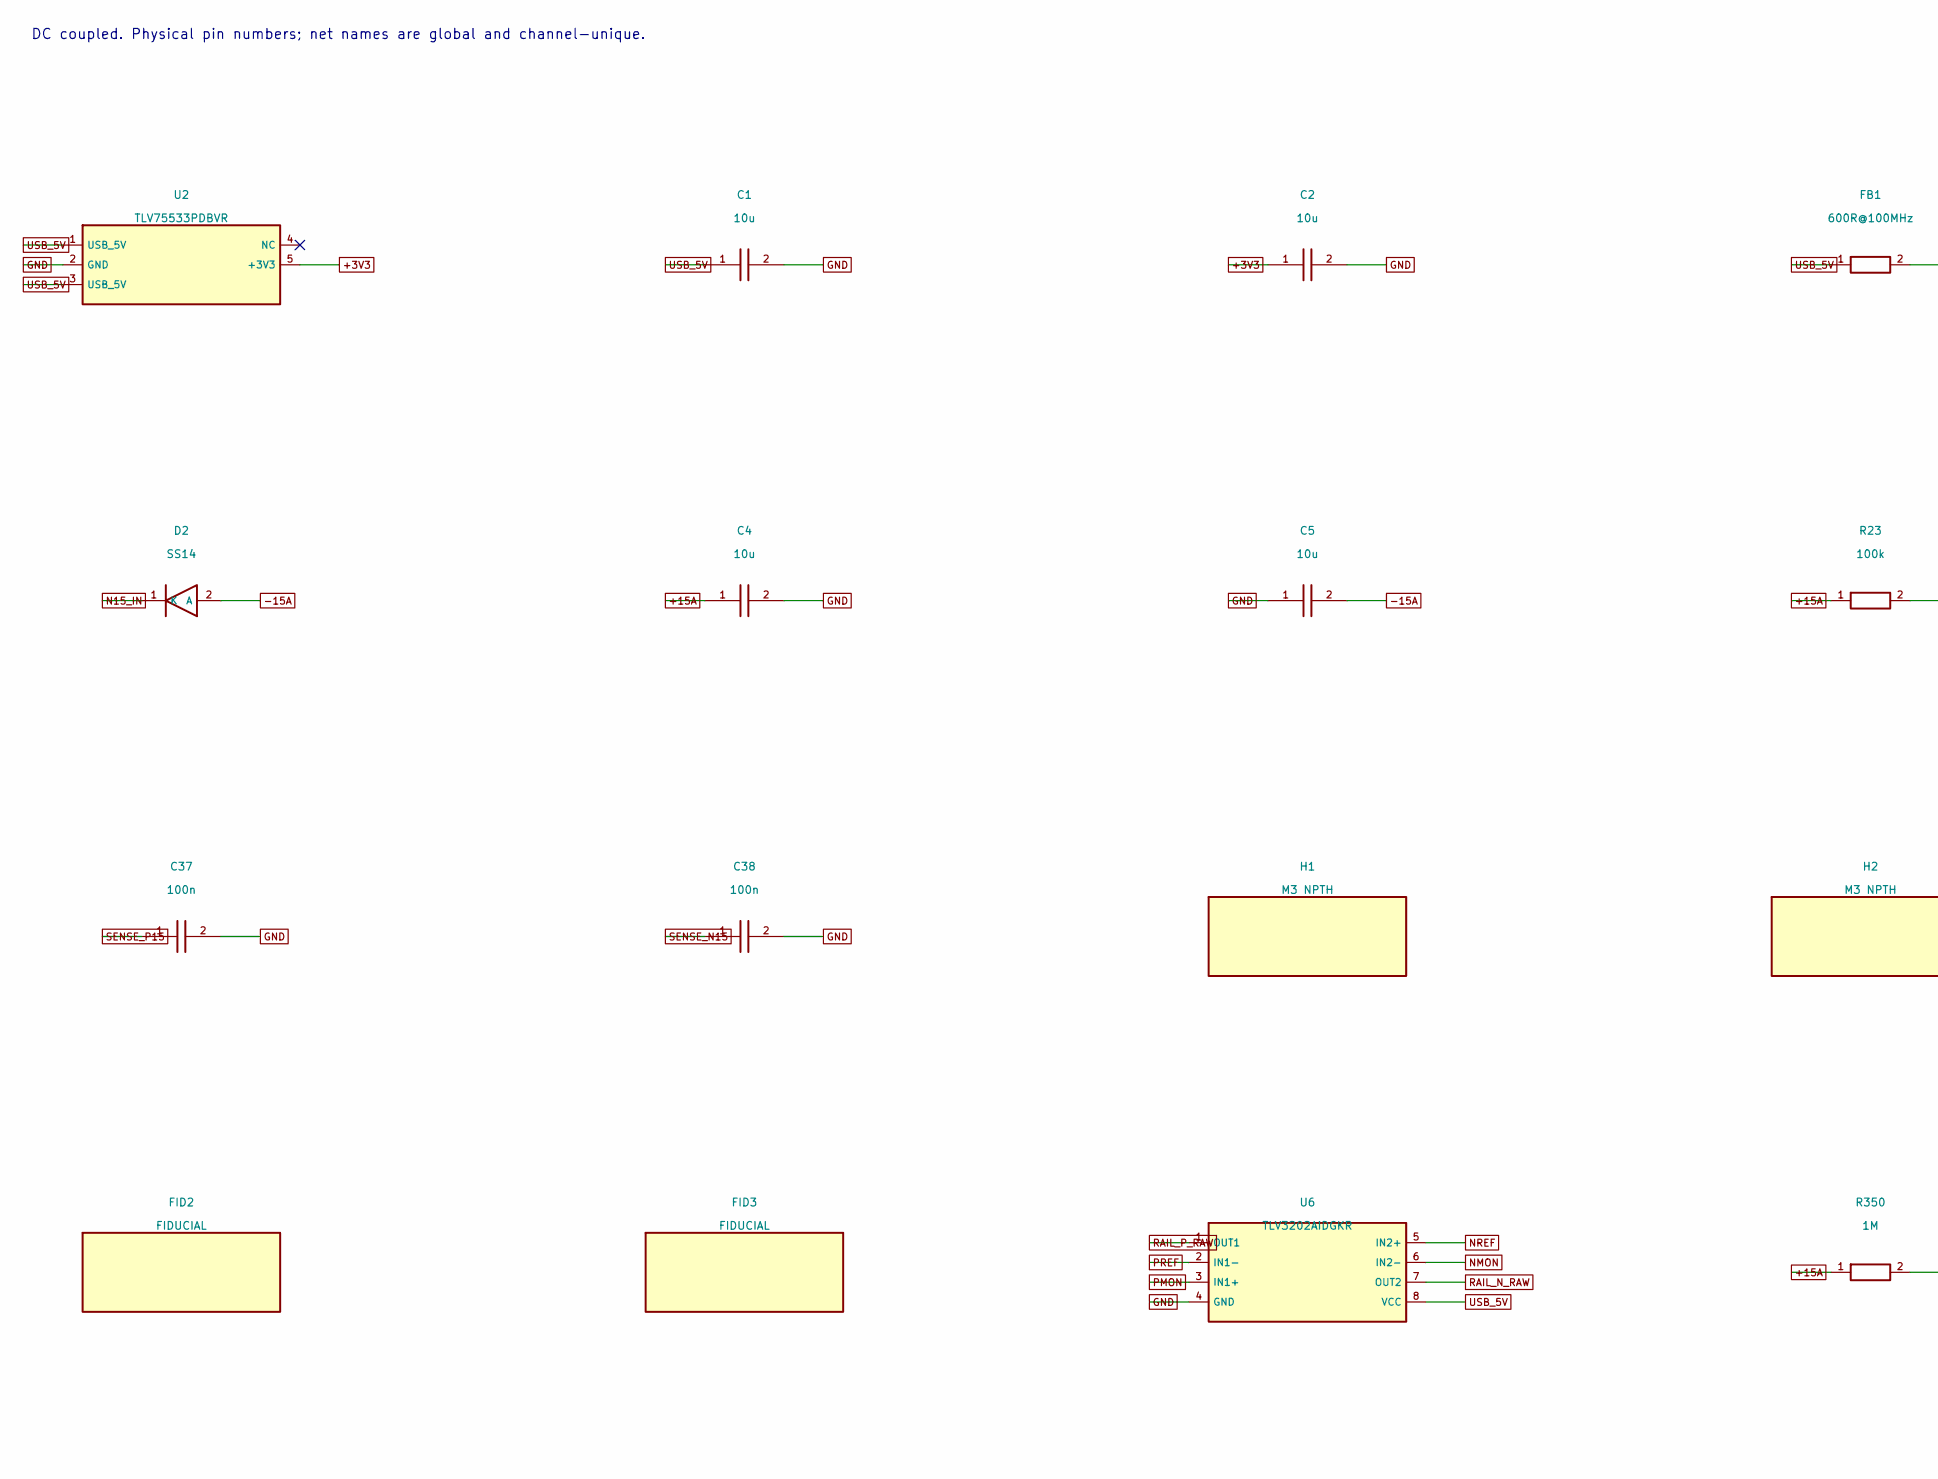
[picture p23: schematic Power.kicad_sch, ILDA8CH RevB-P4 / Power, part in row 1, column 1]

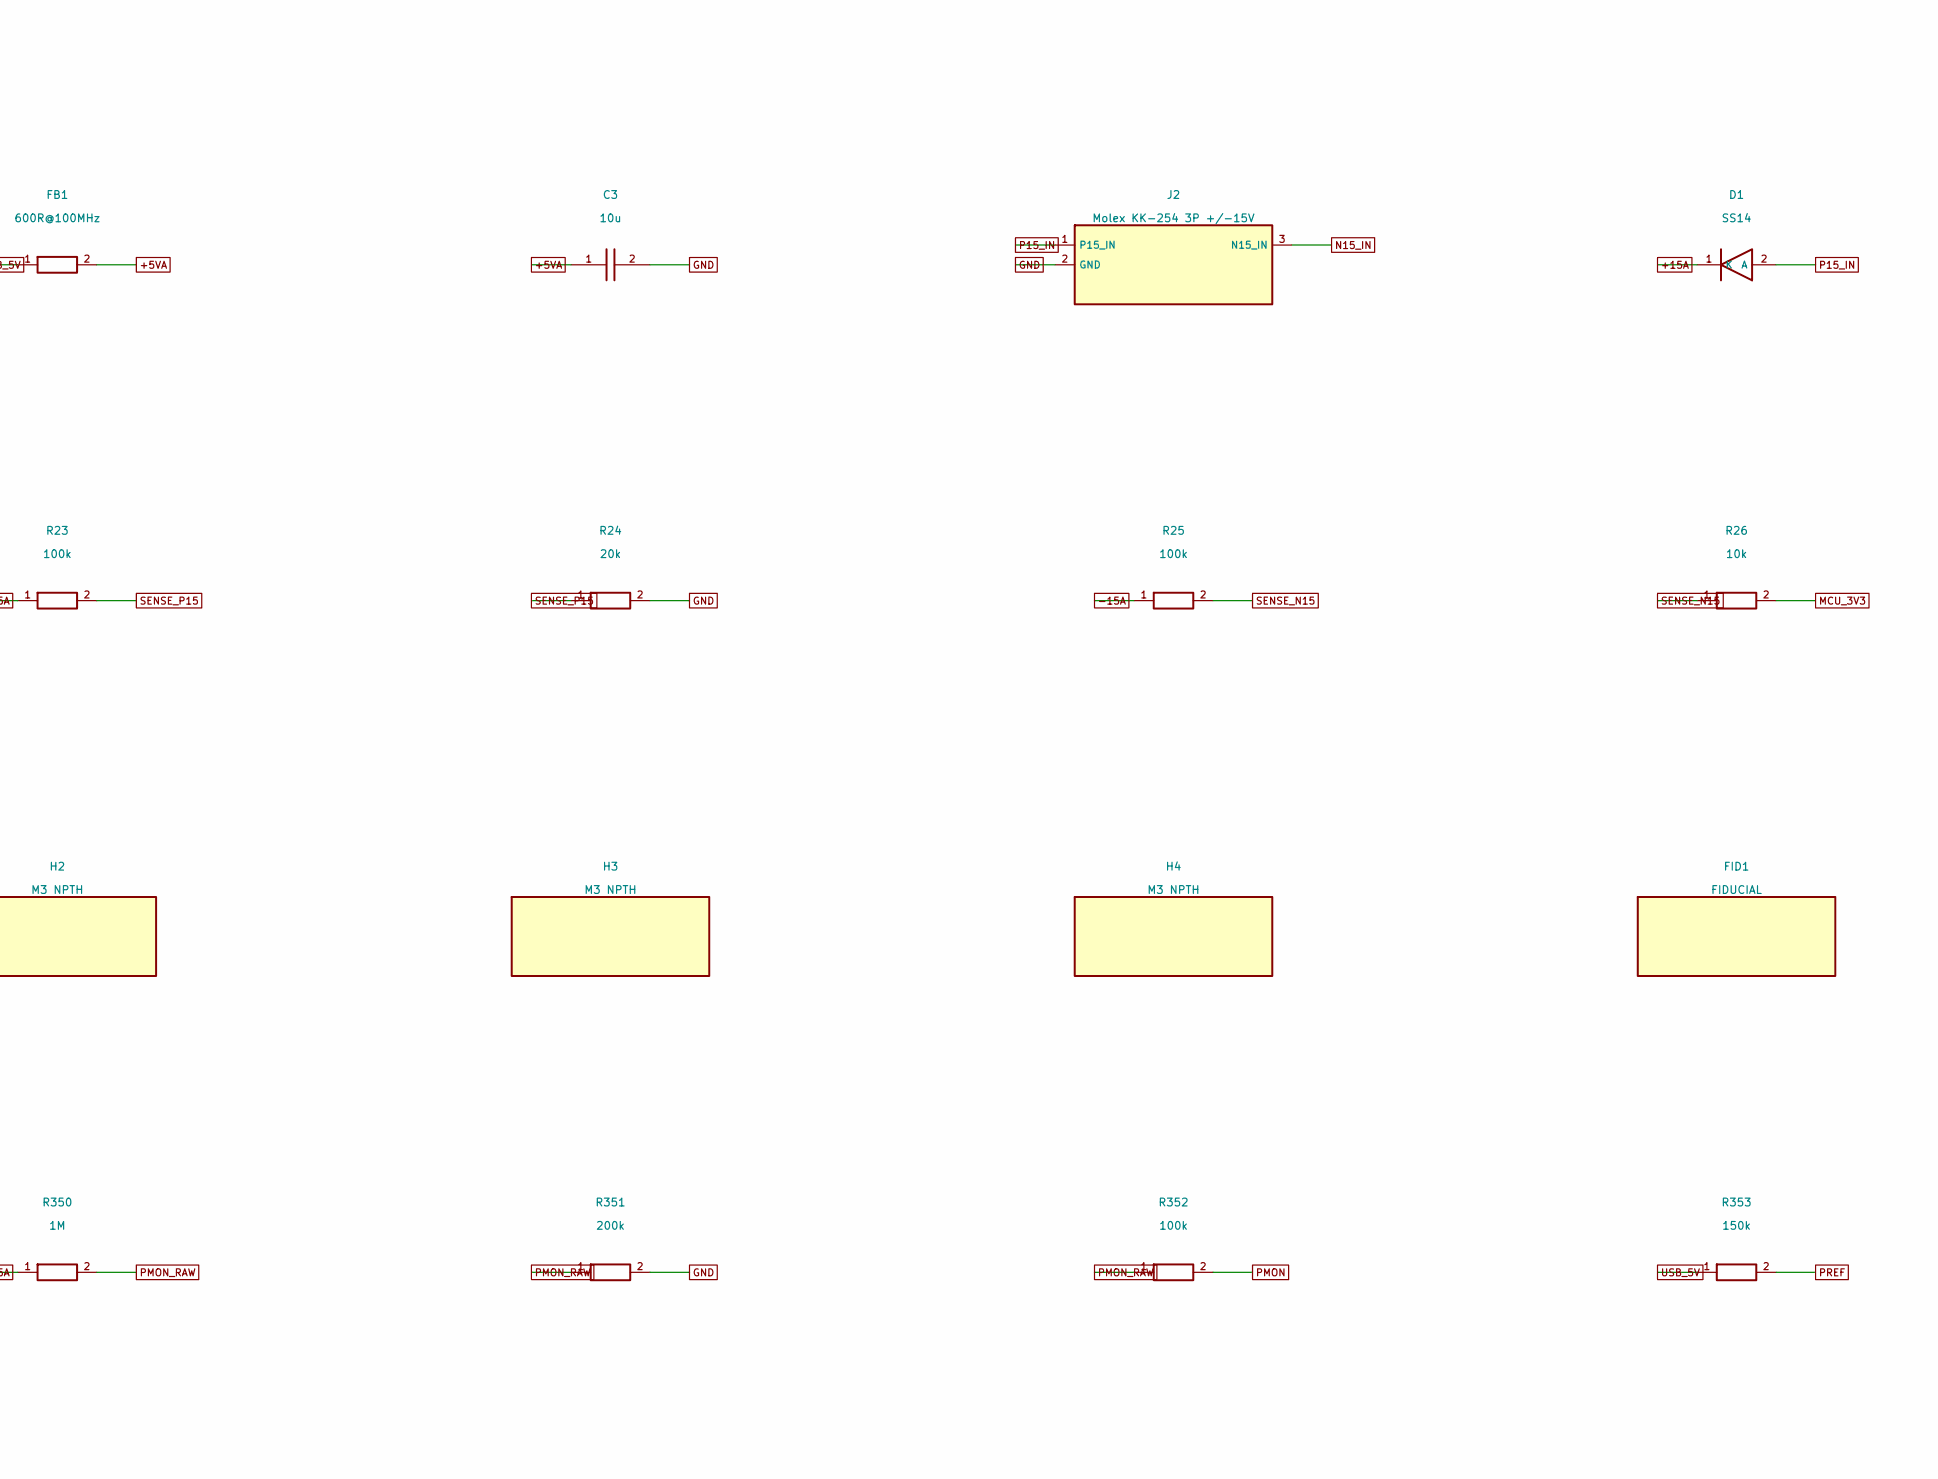
[picture p24: schematic Power.kicad_sch, ILDA8CH RevB-P4 / Power, part in row 1, column 2]

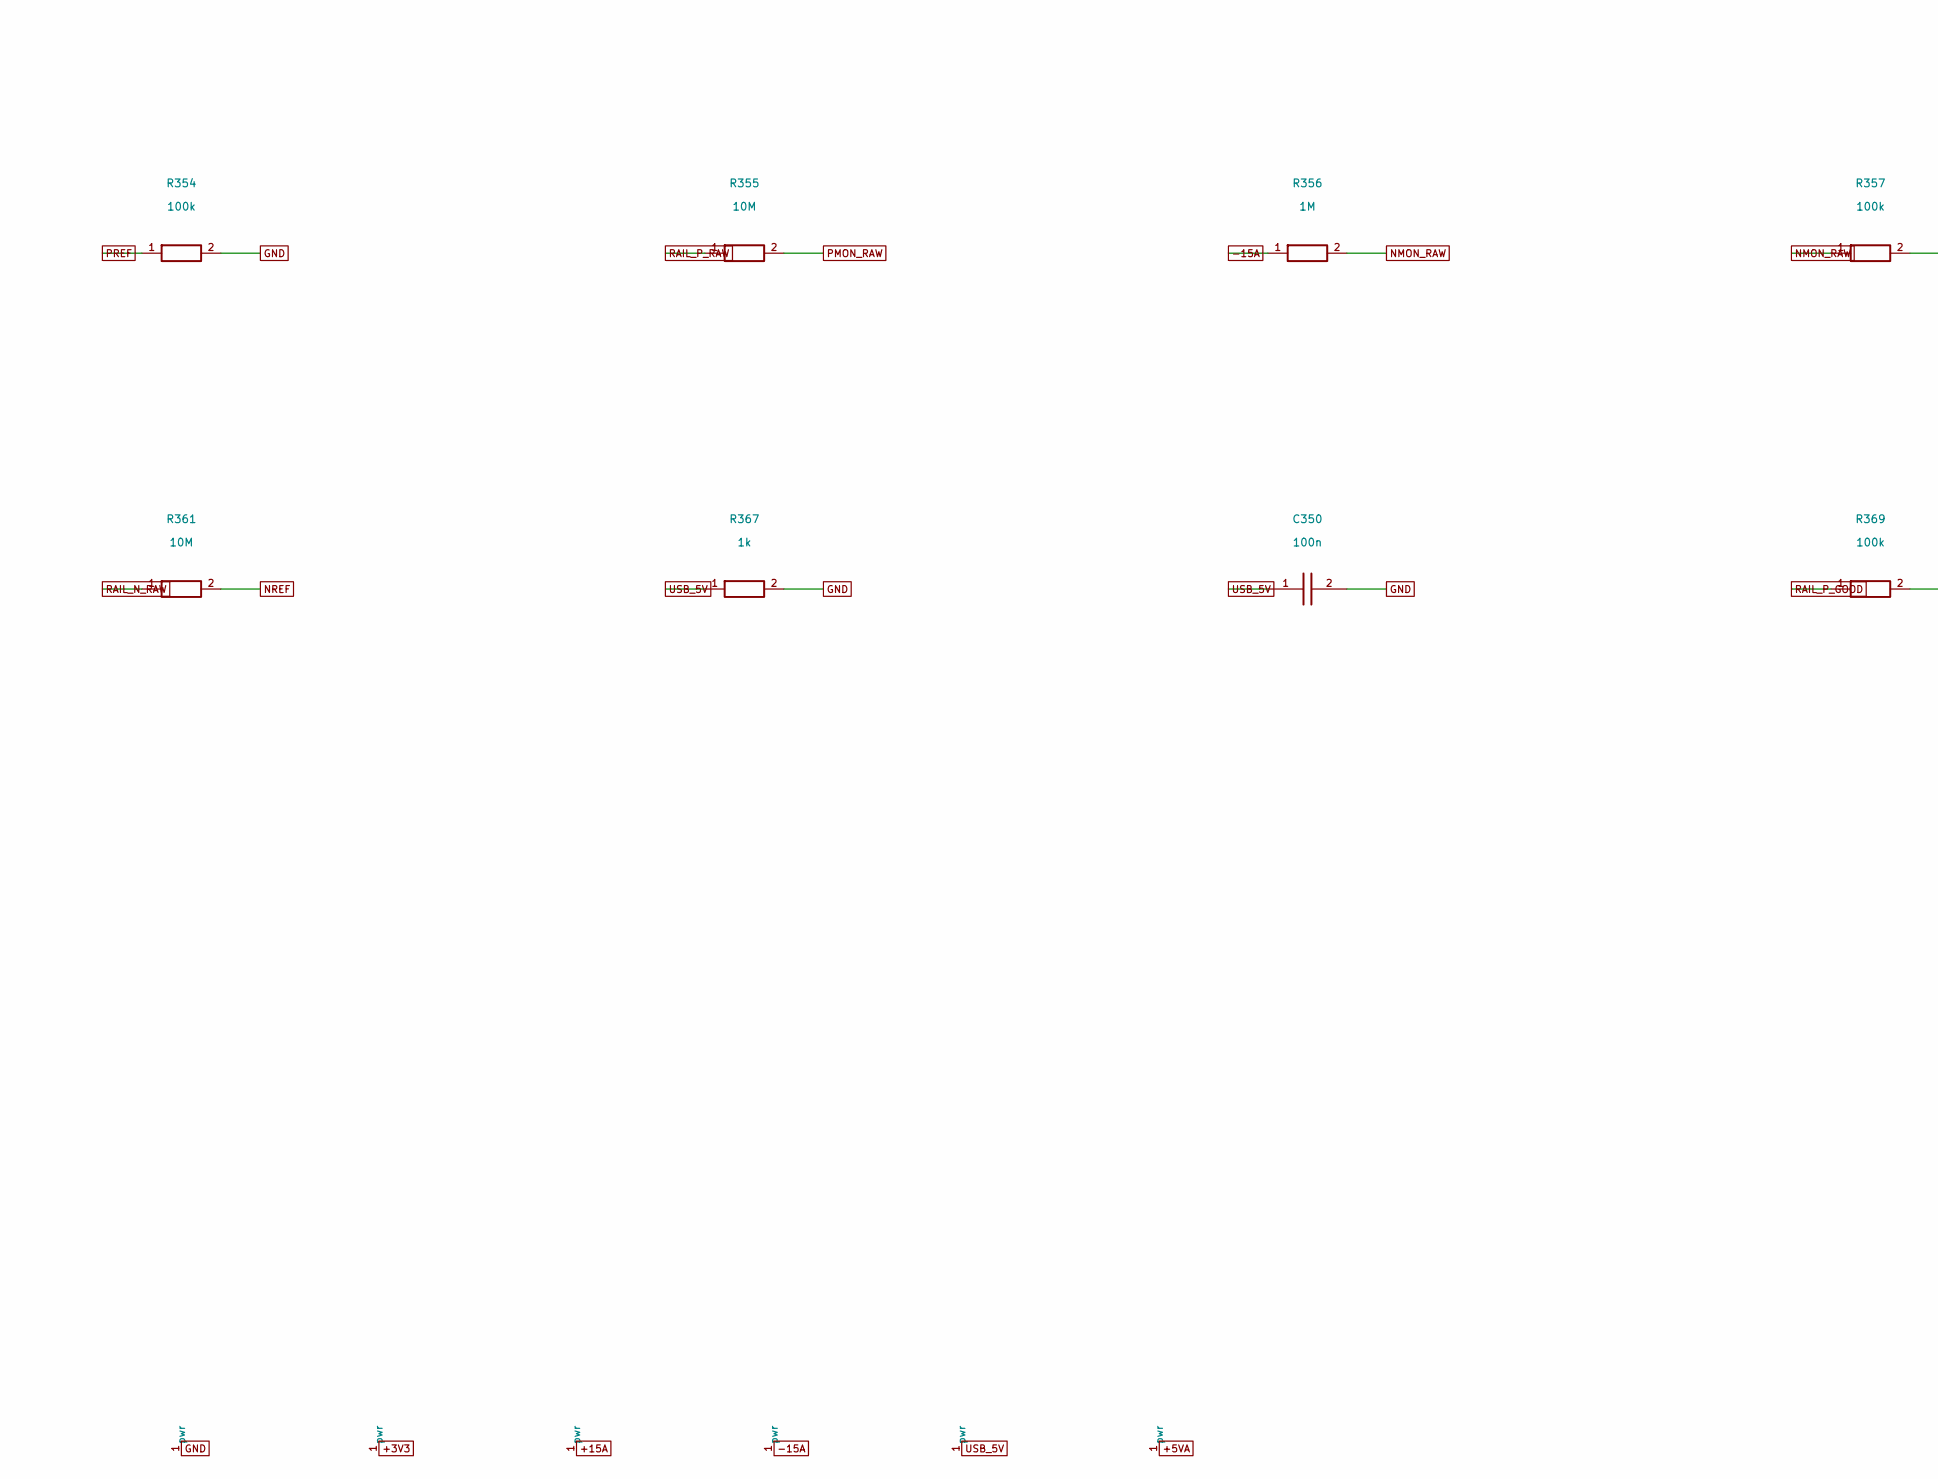
[picture p25: schematic Power.kicad_sch, ILDA8CH RevB-P4 / Power, part in row 2, column 1]

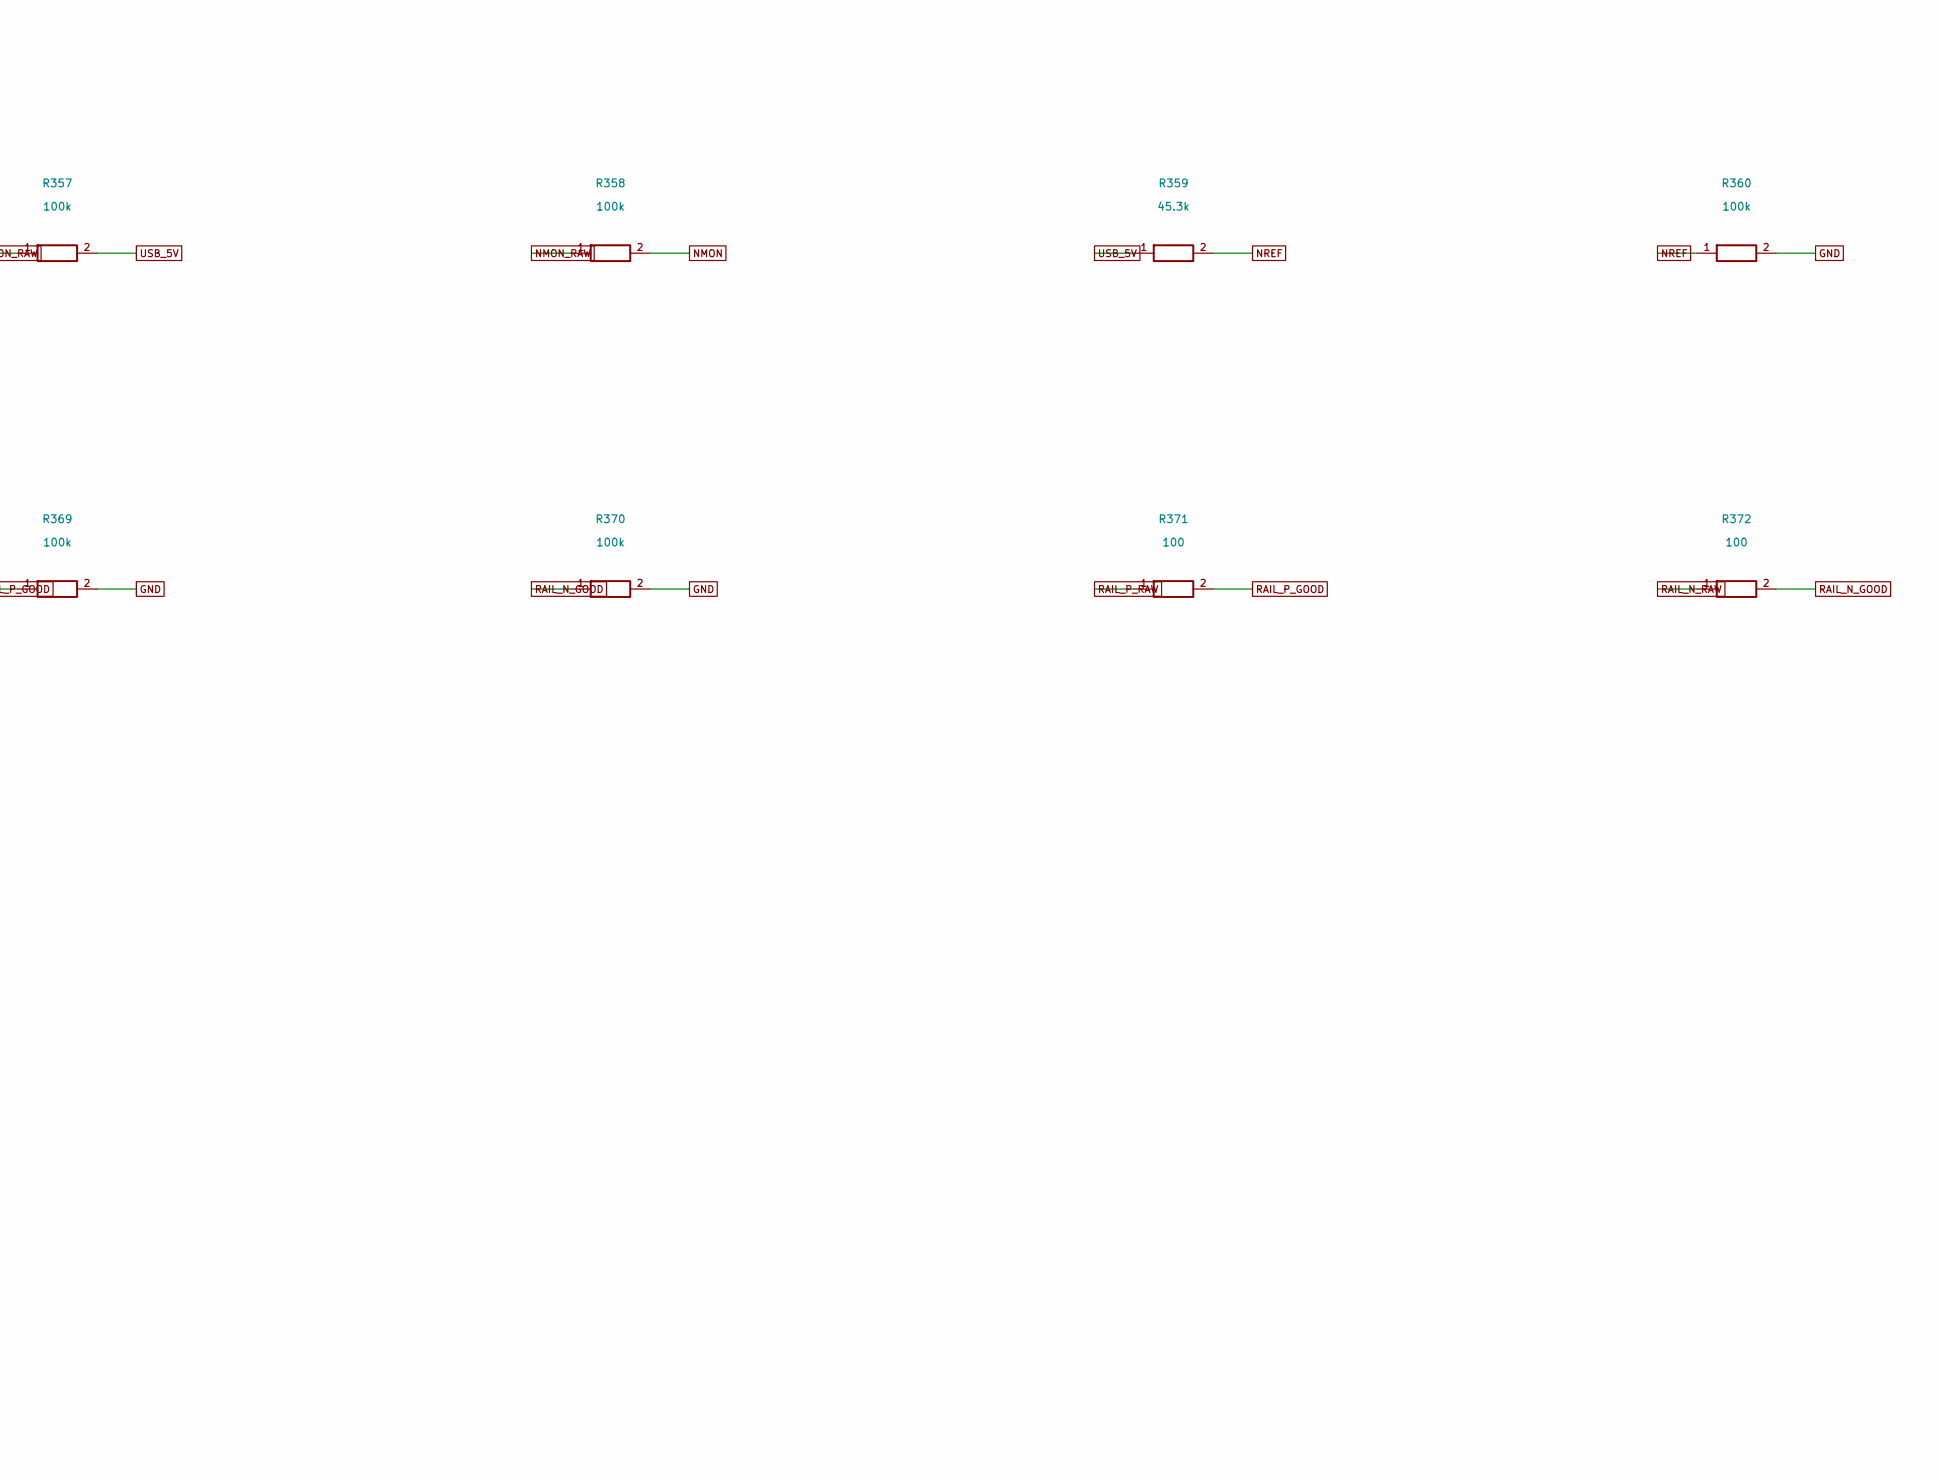
[picture p26: schematic Power.kicad_sch, ILDA8CH RevB-P4 / Power, part in row 2, column 2]

Parts:
C1, C2, C3, C4, C5: 10u; Capacitor_SMD__C_0805_2012Metric; MPN GRM21BR61E106KA73L; LCSC C84416
C37, C38, C350: 100n; Capacitor_SMD__C_0603_1608Metric; MPN GRM188R71H104KA93D; LCSC C77055
D1, D2: SS14; Diode_SMD__D_SMA; MPN SS14; LCSC C2480
FB1: 600R@100MHz; Inductor_SMD__L_0805_2012Metric; MPN BLM21PG601SN1D; LCSC C41556732
FID1, FID2, FID3: FIDUCIAL; Fiducial__Fiducial_1mm_Mask2mm
H1, H2, H3, H4: M3 NPTH; MountingHole__MountingHole_3.2mm_M3
J2: Molex KK-254 3P +/-15V; Connector_Molex__Molex_KK-254_AE-6410-03A_1x03_P2.54mm_Vert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; MPN 22-27-2031
R23, R25, R352, R354, R357, R358, R360, R369, R370: 100k; Resistor_SMD__R_0603_1608Metric; MPN RC0603FR-07100KL; LCSC C14675
R24: 20k; Resistor_SMD__R_0603_1608Metric; MPN RT0603BRD0720KL; LCSC C723637
R26: 10k; Resistor_SMD__R_0603_1608Metric; MPN RT0603BRD0710KL; LCSC C95204
R350, R356: 1M; Resistor_SMD__R_0603_1608Metric; MPN RC0603FR-071ML; LCSC C105578
R351: 200k; Resistor_SMD__R_0603_1608Metric; MPN RC0603FR-07200KL; LCSC C105574
R353: 150k; Resistor_SMD__R_0603_1608Metric; MPN RC0603FR-07150KL; LCSC C114660
R355, R361: 10M; Resistor_SMD__R_0603_1608Metric; MPN RC0603FR-0710ML; LCSC C114606
R359: 45.3k; Resistor_SMD__R_0603_1608Metric; MPN RC0603FR-0745K3L; LCSC C245971
R367: 1k; Resistor_SMD__R_0603_1608Metric; MPN RT0603BRD071KL; LCSC C110776
R371, R372: 100; Resistor_SMD__R_0603_1608Metric; MPN RC0603FR-07100RL; LCSC C105588
U2: TLV75533PDBVR; Package_TO_SOT_SMD__SOT-23-5; MPN TLV75533PDBVR; LCSC C404027
U6: TLV3202AIDGKR; TI_DGK0008A_VSSOP8_3x3_P0.65_Land1.4x0.45; MPN TLV3202AIDGKR; LCSC C478075

Connections:
+3V3: C2.1, U2.5 (+3V3); also elsewhere on the board
+5VA: C3.1, FB1.2; also elsewhere on the board
+15A: C4.1, D1.1 (K), R23.1, R350.1; also elsewhere on the board
-15A: C5.2, D2.2 (A), R25.1, R356.1; also elsewhere on the board
GND: C1.2, C2.2, C3.2, C4.2, C5.1, C37.2, C38.2, C350.2, J2.2 (GND), R24.2, R351.2, R354.2, R360.2, R367.2, R369.2, R370.2, U2.2 (GND), U6.4 (GND); also elsewhere on the board
MCU_3V3: R26.2; also elsewhere on the board
N15_IN: D2.1 (K), J2.3 (N15_IN)
NMON: R358.2, U6.6 (IN2-)
NMON_RAW: R356.2, R357.1, R358.1
NREF: R359.2, R360.1, R361.2, U6.5 (IN2+)
P15_IN: D1.2 (A), J2.1 (P15_IN)
PMON: R352.2, U6.3 (IN1+)
PMON_RAW: R350.2, R351.1, R352.1, R355.2
PREF: R353.2, R354.1, U6.2 (IN1-)
RAIL_N_GOOD: R370.1, R372.2; also elsewhere on the board
RAIL_N_RAW: R361.1, R372.1, U6.7 (OUT2)
RAIL_P_GOOD: R369.1, R371.2; also elsewhere on the board
RAIL_P_RAW: R355.1, R371.1, U6.1 (OUT1)
SENSE_N15: C38.1, R25.2, R26.1; also elsewhere on the board
SENSE_P15: C37.1, R23.2, R24.1; also elsewhere on the board
USB_5V: C1.1, C350.1, FB1.1, R353.1, R357.2, R359.1, R367.1, U2.1 (USB_5V), U2.3 (USB_5V), U6.8 (VCC); also elsewhere on the board

Notes on the sheet:
DC coupled. Physical pin numbers; net names are global and channel-unique.
