weiweiweiopen/teensy-4-RGBgalvos/hardware/revB/KiCad/ILDA8CH.kicad_pcb

## KiCad design hardware/revB/KiCad/ILDA8CH.kicad_pcb (continued)

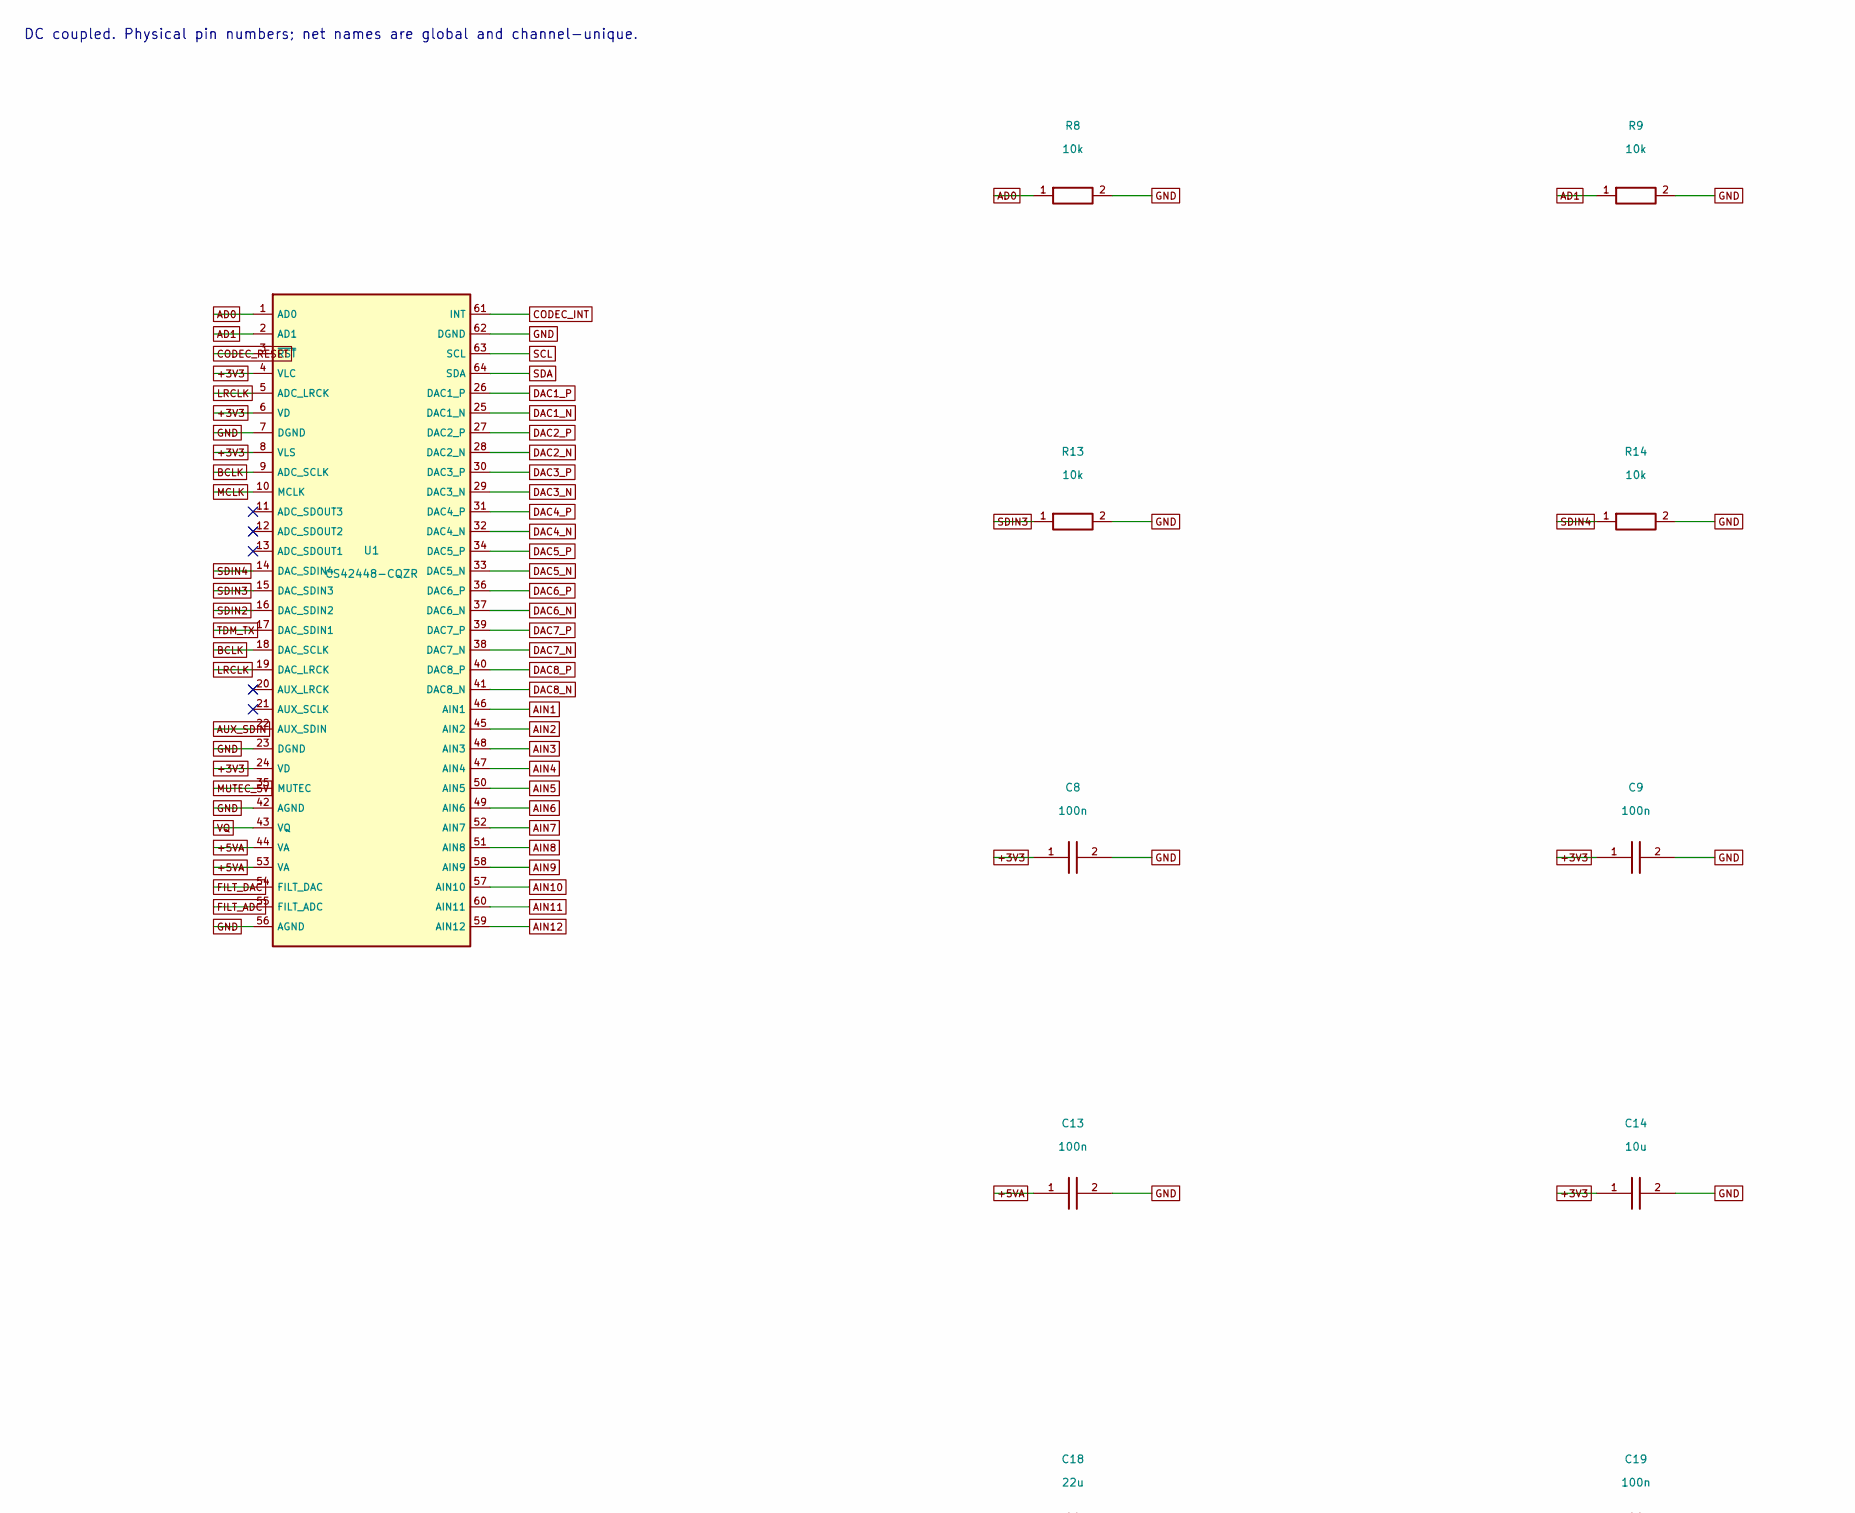
[picture p27: schematic Codec.kicad_sch, ILDA8CH RevB-P4 / Codec, part in row 1, column 1]

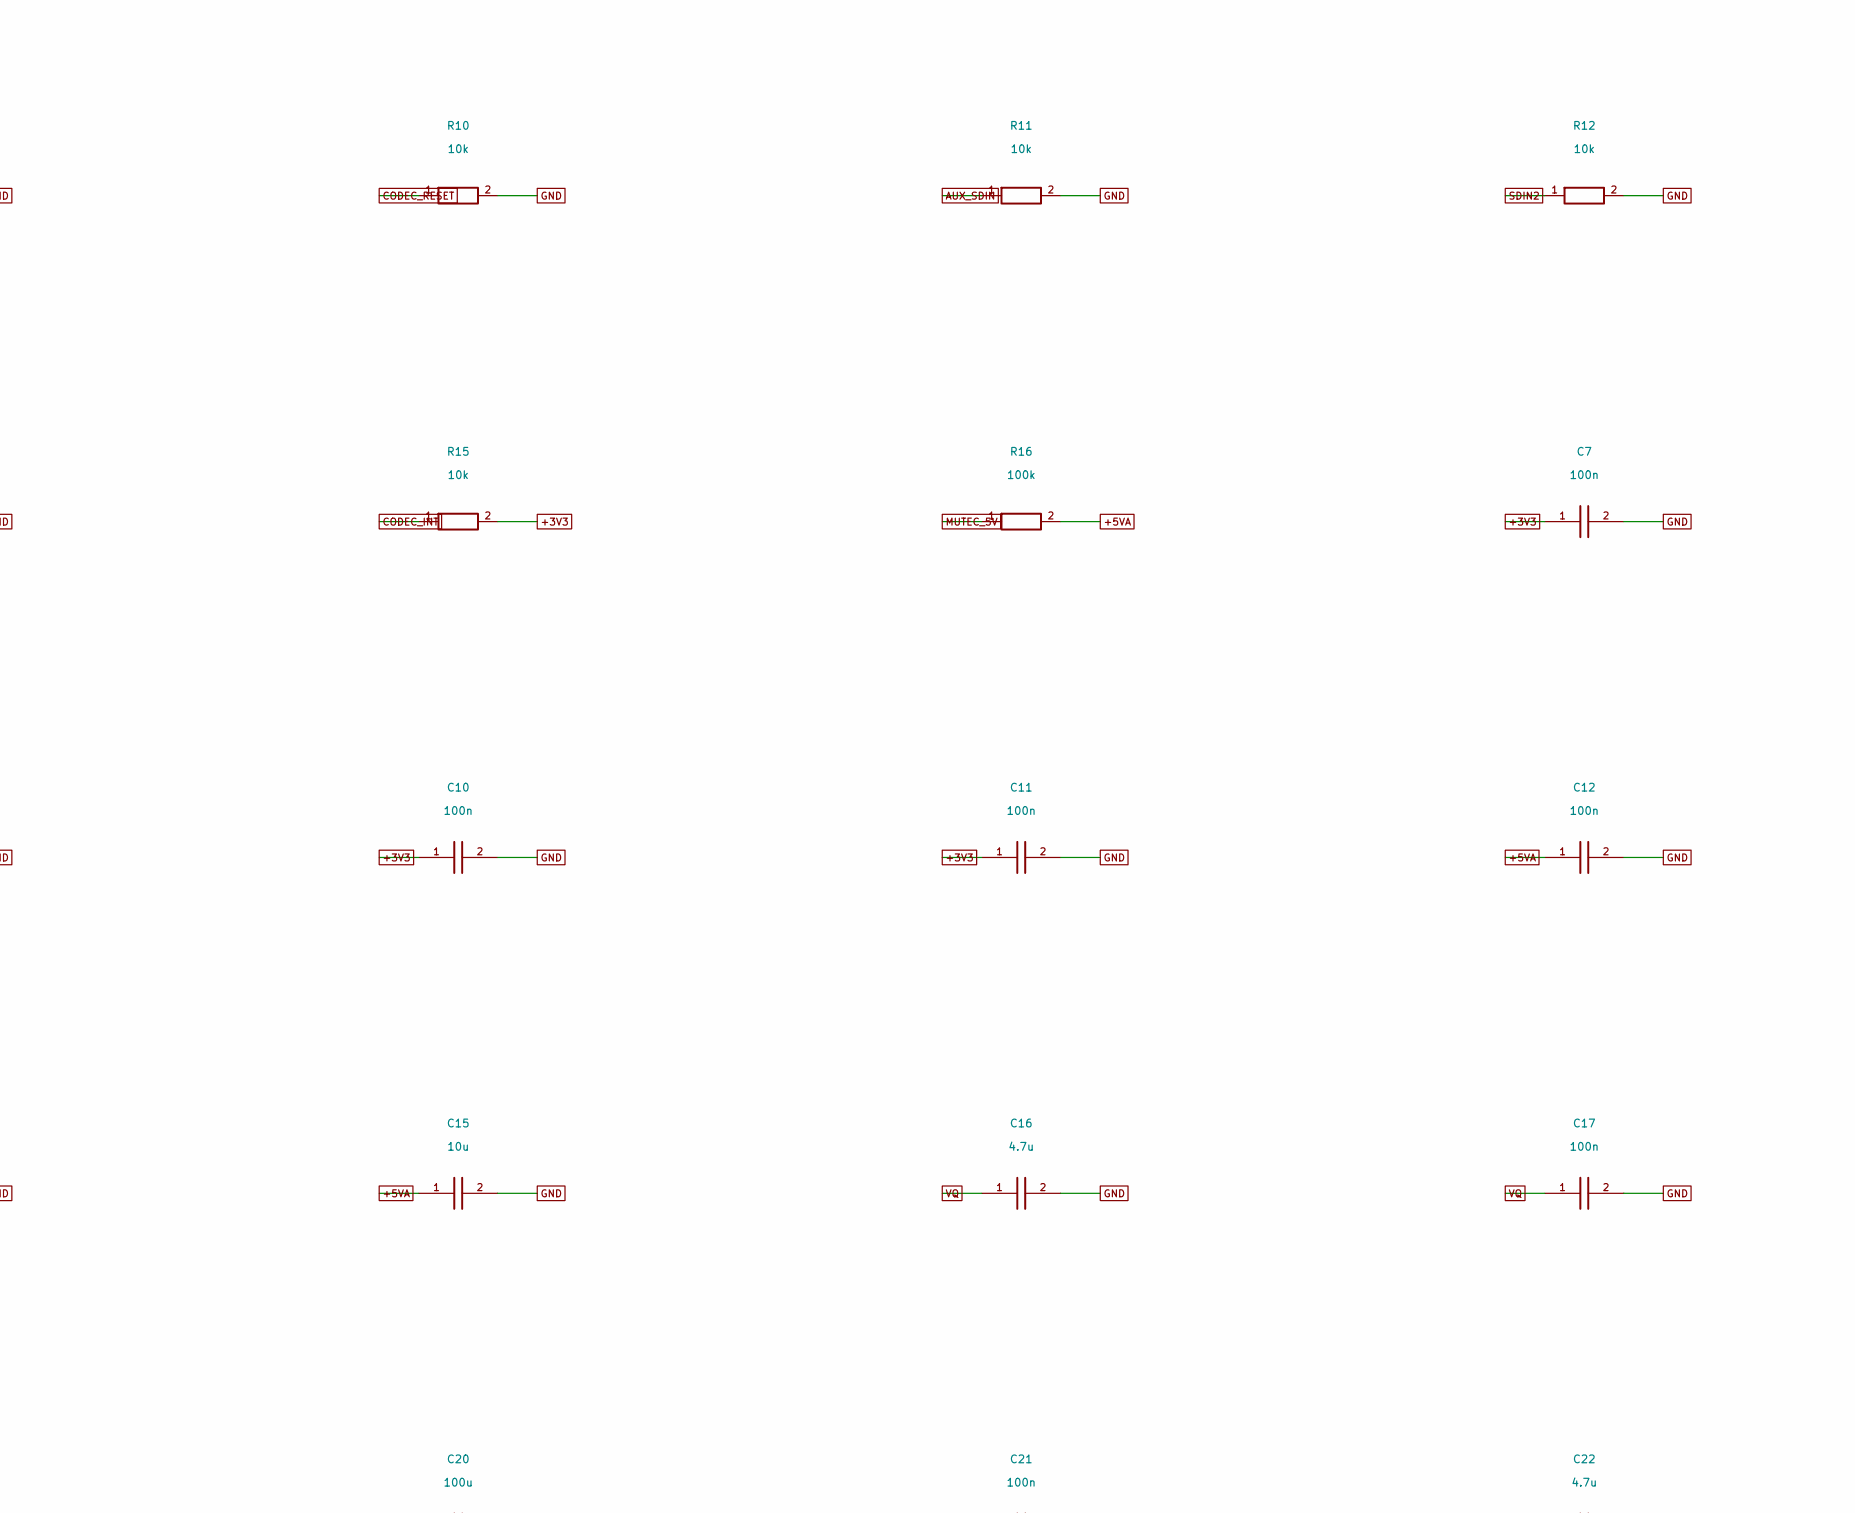
[picture p28: schematic Codec.kicad_sch, ILDA8CH RevB-P4 / Codec, part in row 1, column 2]

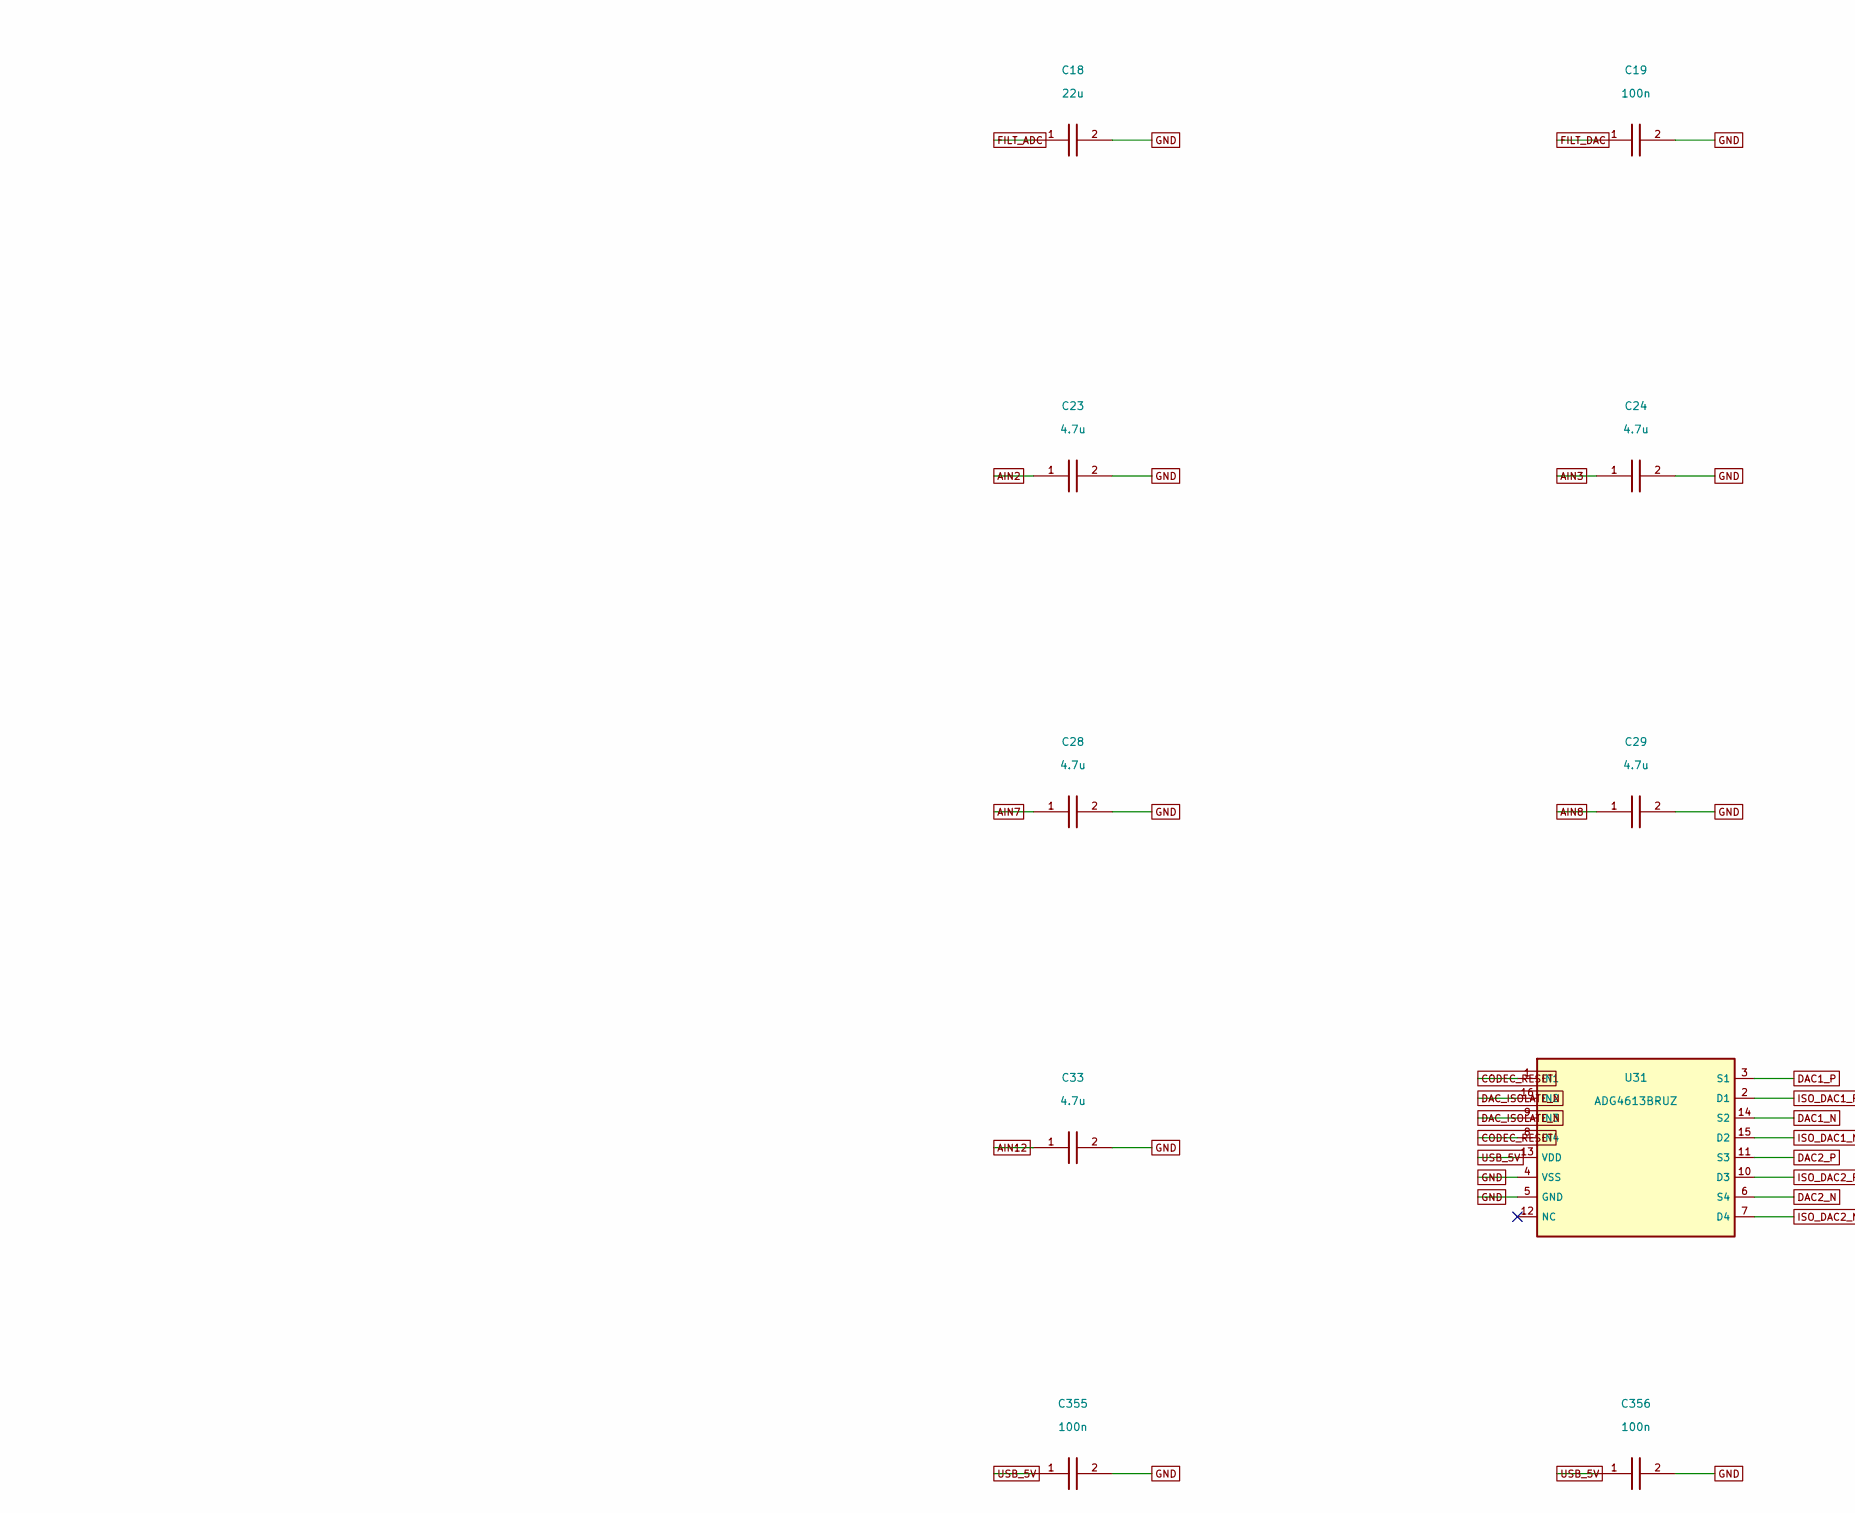
[picture p29: schematic Codec.kicad_sch, ILDA8CH RevB-P4 / Codec, part in row 2, column 1]

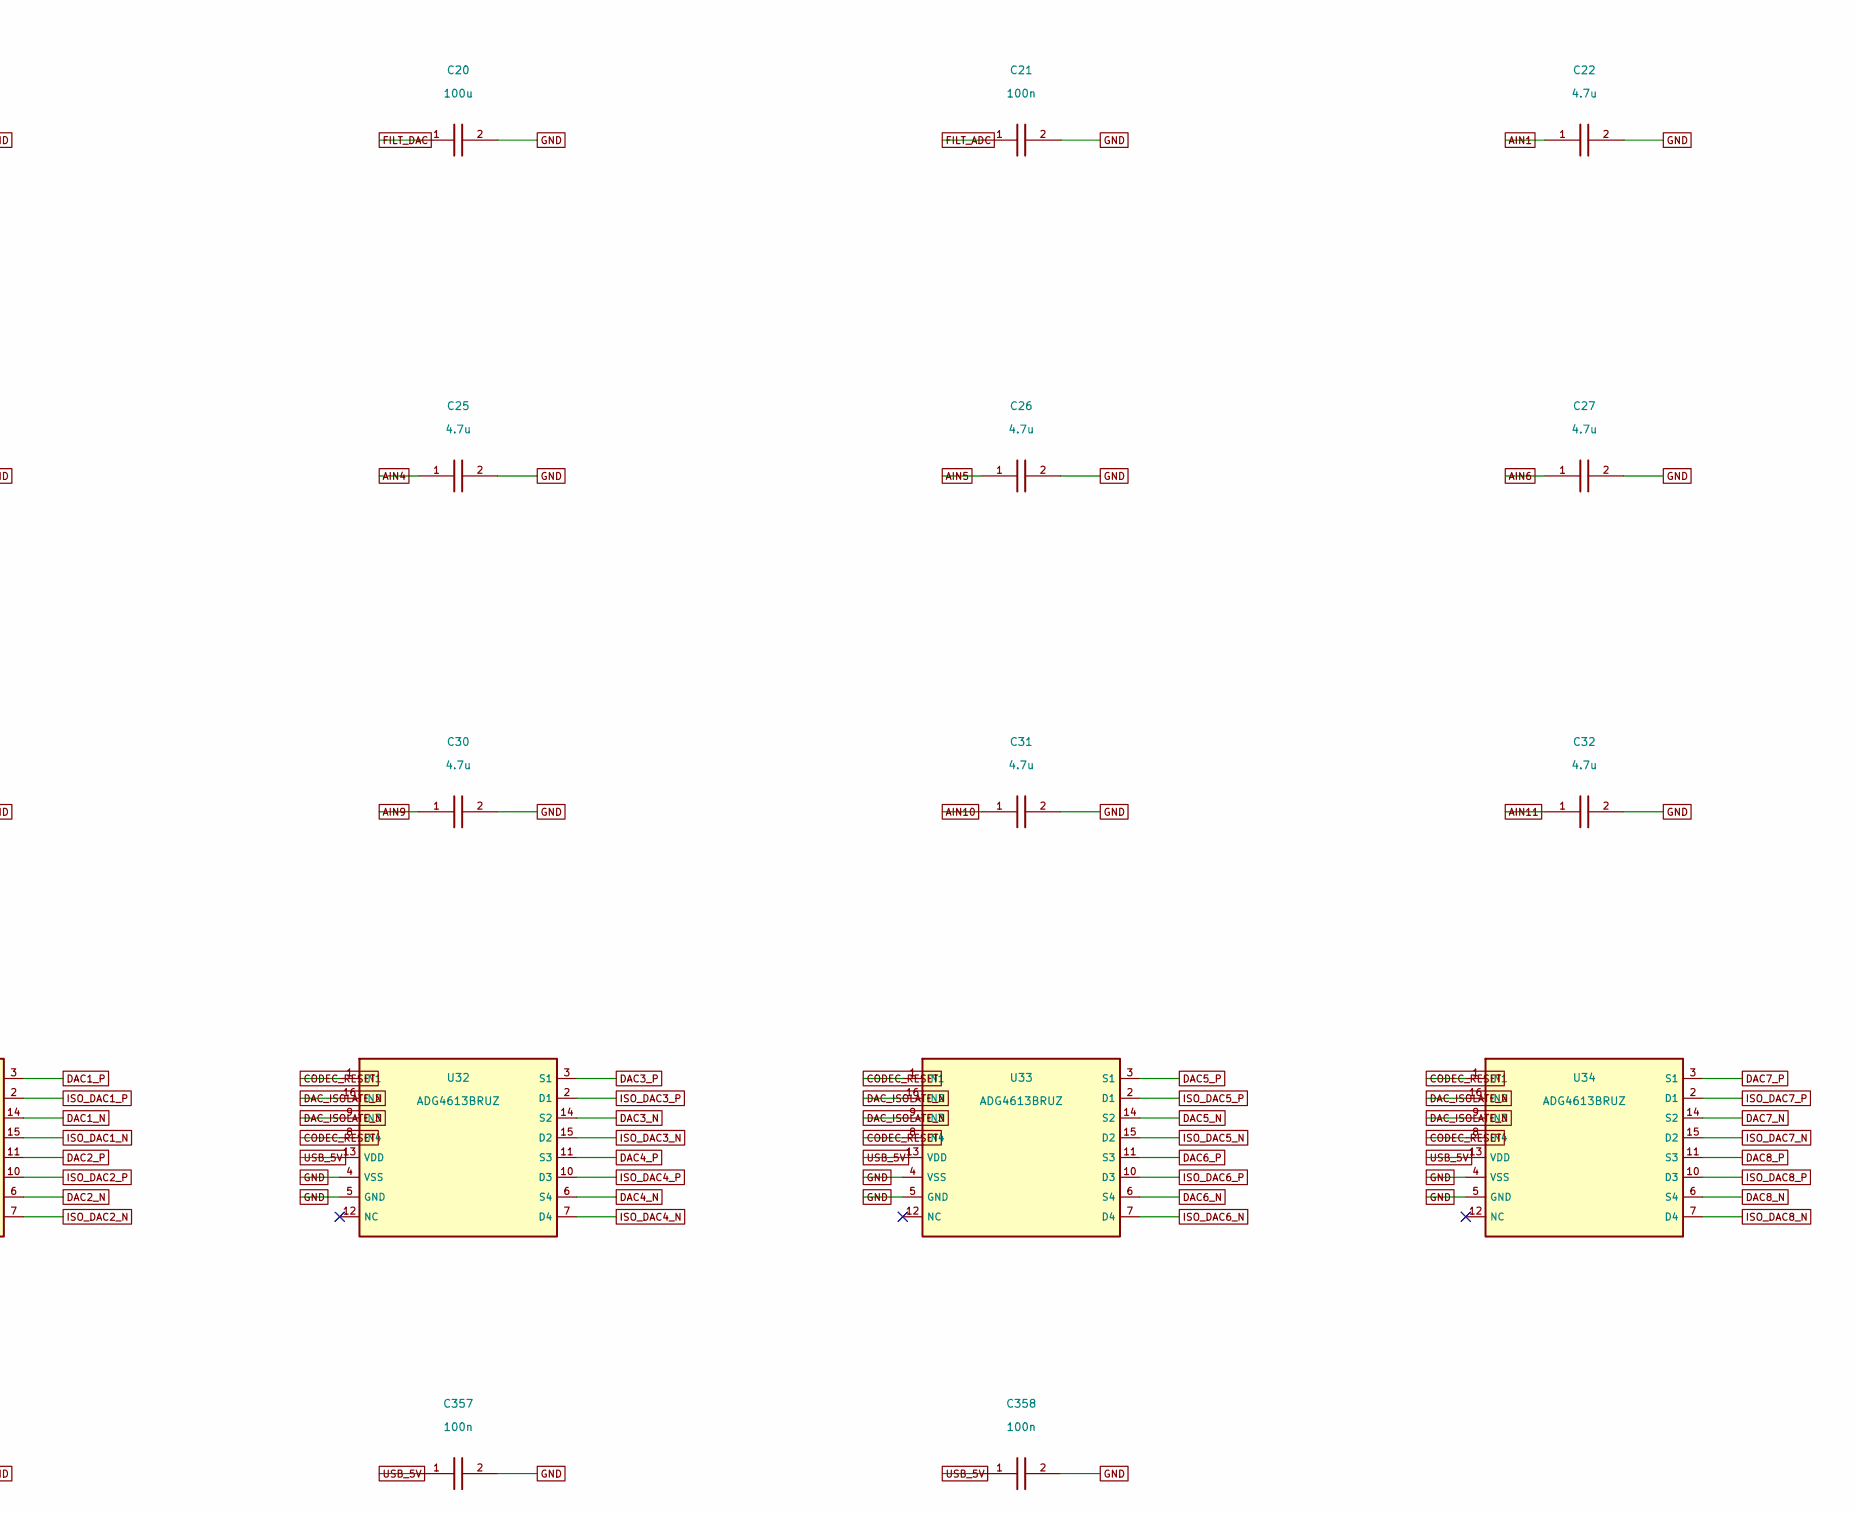
[picture p30: schematic Codec.kicad_sch, ILDA8CH RevB-P4 / Codec, part in row 2, column 2]

Parts:
C7, C8, C9, C10, C11, C12, C13, C17, C19, C21, C355, C356, C357, C358: 100n; Capacitor_SMD__C_0603_1608Metric; MPN GRM188R71H104KA93D; LCSC C77055
C14, C15: 10u; Capacitor_SMD__C_0805_2012Metric; MPN GRM21BR61E106KA73L; LCSC C84416
C16, C22, C23, C24, C25, C26, C27, C28, C29, C30, C31, C32, C33: 4.7u; Capacitor_SMD__C_0805_2012Metric; MPN GRM21BR61E475KA12L; LCSC C77077
C18: 22u; Capacitor_SMD__C_1206_3216Metric; MPN GRM31CR61E226KE15L; LCSC C77091
C20: 100u; Capacitor_SMD__C_1210_3225Metric; MPN GRM32ER61A107ME20L; LCSC C84455
R8, R9, R10, R11, R12, R13, R14, R15: 10k; Resistor_SMD__R_0603_1608Metric; MPN RT0603BRD0710KL; LCSC C95204
R16: 100k; Resistor_SMD__R_0603_1608Metric; MPN RC0603FR-07100KL; LCSC C14675
U1: CS42448-CQZR; Package_QFP__LQFP-64_10x10mm_P0.5mm; MPN CS42448-CQZR; LCSC C2151089
U31, U32, U33, U34: ADG4613BRUZ; Package_SO__TSSOP-16_4.4x5mm_P0.65mm; MPN ADG4613BRUZ; LCSC C657392

Connections:
+3V3: C7.1, C8.1, C9.1, C10.1, C11.1, C14.1, R15.2, U1.4 (VLC), U1.6 (VD), U1.8 (VLS), U1.24 (VD); also elsewhere on the board
+5VA: C12.1, C13.1, C15.1, R16.2, U1.44 (VA), U1.53 (VA); also elsewhere on the board
AD0: R8.1, U1.1 (AD0)
AD1: R9.1, U1.2 (AD1)
AIN1: C22.1, U1.46 (AIN1)
AIN2: C23.1, U1.45 (AIN2)
AIN3: C24.1, U1.48 (AIN3)
AIN4: C25.1, U1.47 (AIN4)
AIN5: C26.1, U1.50 (AIN5)
AIN6: C27.1, U1.49 (AIN6)
AIN7: C28.1, U1.52 (AIN7)
AIN8: C29.1, U1.51 (AIN8)
AIN9: C30.1, U1.58 (AIN9)
AIN10: C31.1, U1.57 (AIN10)
AIN11: C32.1, U1.60 (AIN11)
AIN12: C33.1, U1.59 (AIN12)
AUX_SDIN: R11.1, U1.22 (AUX_SDIN)
BCLK: U1.9 (ADC_SCLK), U1.18 (DAC_SCLK); also elsewhere on the board
CODEC_INT: R15.1, U1.61 (INT); also elsewhere on the board
CODEC_RESET: R10.1, U1.3 (~RST), U31.1 (IN1), U31.8 (IN4), U32.1 (IN1), U32.8 (IN4), U33.1 (IN1), U33.8 (IN4), U34.1 (IN1), U34.8 (IN4); also elsewhere on the board
DAC1_N: U1.25 (DAC1_N), U31.14 (S2)
DAC1_P: U1.26 (DAC1_P), U31.3 (S1)
DAC2_N: U1.28 (DAC2_N), U31.6 (S4)
DAC2_P: U1.27 (DAC2_P), U31.11 (S3)
DAC3_N: U1.29 (DAC3_N), U32.14 (S2)
DAC3_P: U1.30 (DAC3_P), U32.3 (S1)
DAC4_N: U1.32 (DAC4_N), U32.6 (S4)
DAC4_P: U1.31 (DAC4_P), U32.11 (S3)
DAC5_N: U1.33 (DAC5_N), U33.14 (S2)
DAC5_P: U1.34 (DAC5_P), U33.3 (S1)
DAC6_N: U1.37 (DAC6_N), U33.6 (S4)
DAC6_P: U1.36 (DAC6_P), U33.11 (S3)
DAC7_N: U1.38 (DAC7_N), U34.14 (S2)
DAC7_P: U1.39 (DAC7_P), U34.3 (S1)
DAC8_N: U1.41 (DAC8_N), U34.6 (S4)
DAC8_P: U1.40 (DAC8_P), U34.11 (S3)
DAC_ISOLATE_N: U31.9 (IN3), U31.16 (IN2), U32.9 (IN3), U32.16 (IN2), U33.9 (IN3), U33.16 (IN2), U34.9 (IN3), U34.16 (IN2); also elsewhere on the board
FILT_ADC: C18.1, C21.1, U1.55 (FILT_ADC)
FILT_DAC: C19.1, C20.1, U1.54 (FILT_DAC)
GND: C7.2, C8.2, C9.2, C10.2, C11.2, C12.2, C13.2, C14.2, C15.2, C16.2, C17.2, C18.2, C19.2, C20.2, C21.2, C22.2, C23.2, C24.2, C25.2, C26.2, C27.2, C28.2, C29.2, C30.2, C31.2, C32.2, C33.2, C355.2, C356.2, C357.2, C358.2, R8.2, R9.2, R10.2, R11.2, R12.2, R13.2, R14.2, U1.7 (DGND), U1.23 (DGND), U1.42 (AGND), U1.56 (AGND), U1.62 (DGND), U31.4 (VSS), U31.5 (GND), U32.4 (VSS), U32.5 (GND), U33.4 (VSS), U33.5 (GND), U34.4 (VSS), U34.5 (GND); also elsewhere on the board
ISO_DAC1_N: U31.15 (D2); also elsewhere on the board
ISO_DAC1_P: U31.2 (D1); also elsewhere on the board
ISO_DAC2_N: U31.7 (D4); also elsewhere on the board
ISO_DAC2_P: U31.10 (D3); also elsewhere on the board
ISO_DAC3_N: U32.15 (D2); also elsewhere on the board
ISO_DAC3_P: U32.2 (D1); also elsewhere on the board
ISO_DAC4_N: U32.7 (D4); also elsewhere on the board
ISO_DAC4_P: U32.10 (D3); also elsewhere on the board
ISO_DAC5_N: U33.15 (D2); also elsewhere on the board
ISO_DAC5_P: U33.2 (D1); also elsewhere on the board
ISO_DAC6_N: U33.7 (D4); also elsewhere on the board
ISO_DAC6_P: U33.10 (D3); also elsewhere on the board
ISO_DAC7_N: U34.15 (D2); also elsewhere on the board
ISO_DAC7_P: U34.2 (D1); also elsewhere on the board
ISO_DAC8_N: U34.7 (D4); also elsewhere on the board
ISO_DAC8_P: U34.10 (D3); also elsewhere on the board
LRCLK: U1.5 (ADC_LRCK), U1.19 (DAC_LRCK); also elsewhere on the board
MCLK: U1.10 (MCLK); also elsewhere on the board
MUTEC_5V: R16.1, U1.35 (MUTEC); also elsewhere on the board
SCL: U1.63 (SCL); also elsewhere on the board
SDA: U1.64 (SDA); also elsewhere on the board
SDIN2: R12.1, U1.16 (DAC_SDIN2)
SDIN3: R13.1, U1.15 (DAC_SDIN3)
SDIN4: R14.1, U1.14 (DAC_SDIN4)
TDM_TX: U1.17 (DAC_SDIN1); also elsewhere on the board
USB_5V: C355.1, C356.1, C357.1, C358.1, U31.13 (VDD), U32.13 (VDD), U33.13 (VDD), U34.13 (VDD); also elsewhere on the board
VQ: C16.1, C17.1, U1.43 (VQ); also elsewhere on the board

Notes on the sheet:
DC coupled. Physical pin numbers; net names are global and channel-unique.
