weiweiweiopen/teensy-4-RGBgalvos/hardware/revB/KiCad/ILDA8CH.kicad_pcb

## KiCad design hardware/revB/KiCad/ILDA8CH.kicad_pcb (continued)

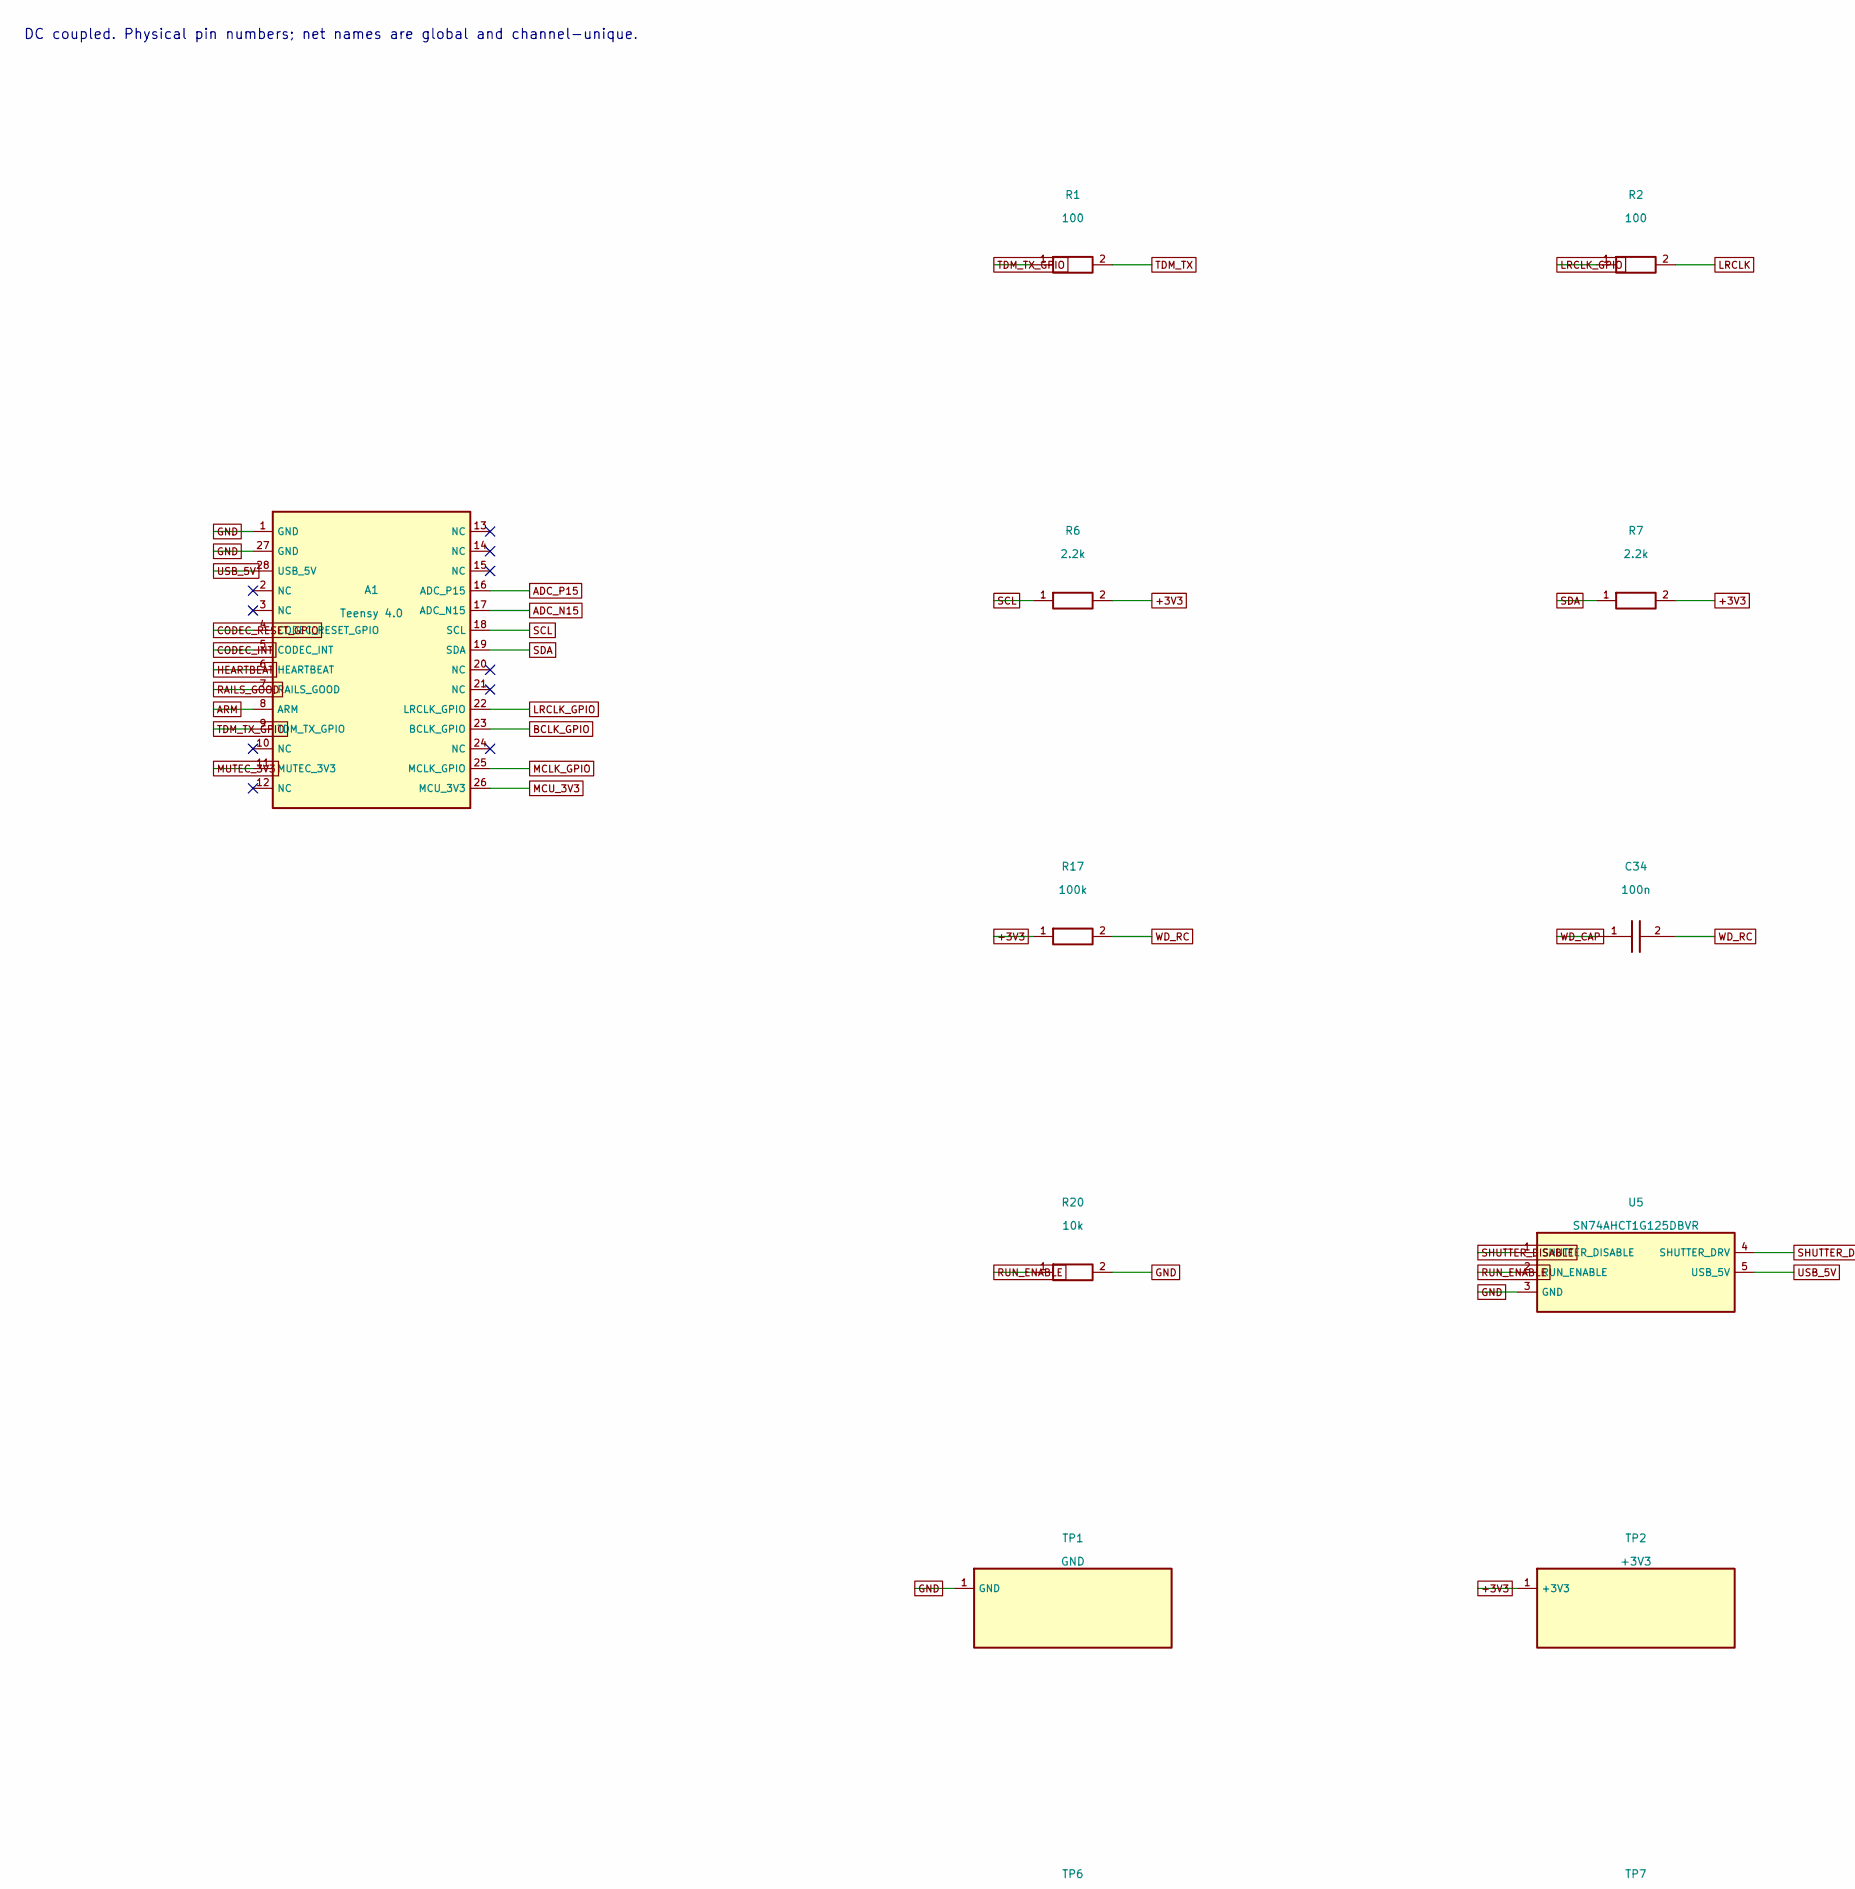
[picture p31: schematic Control.kicad_sch, ILDA8CH RevB-P4 / Control, part in row 1, column 1]

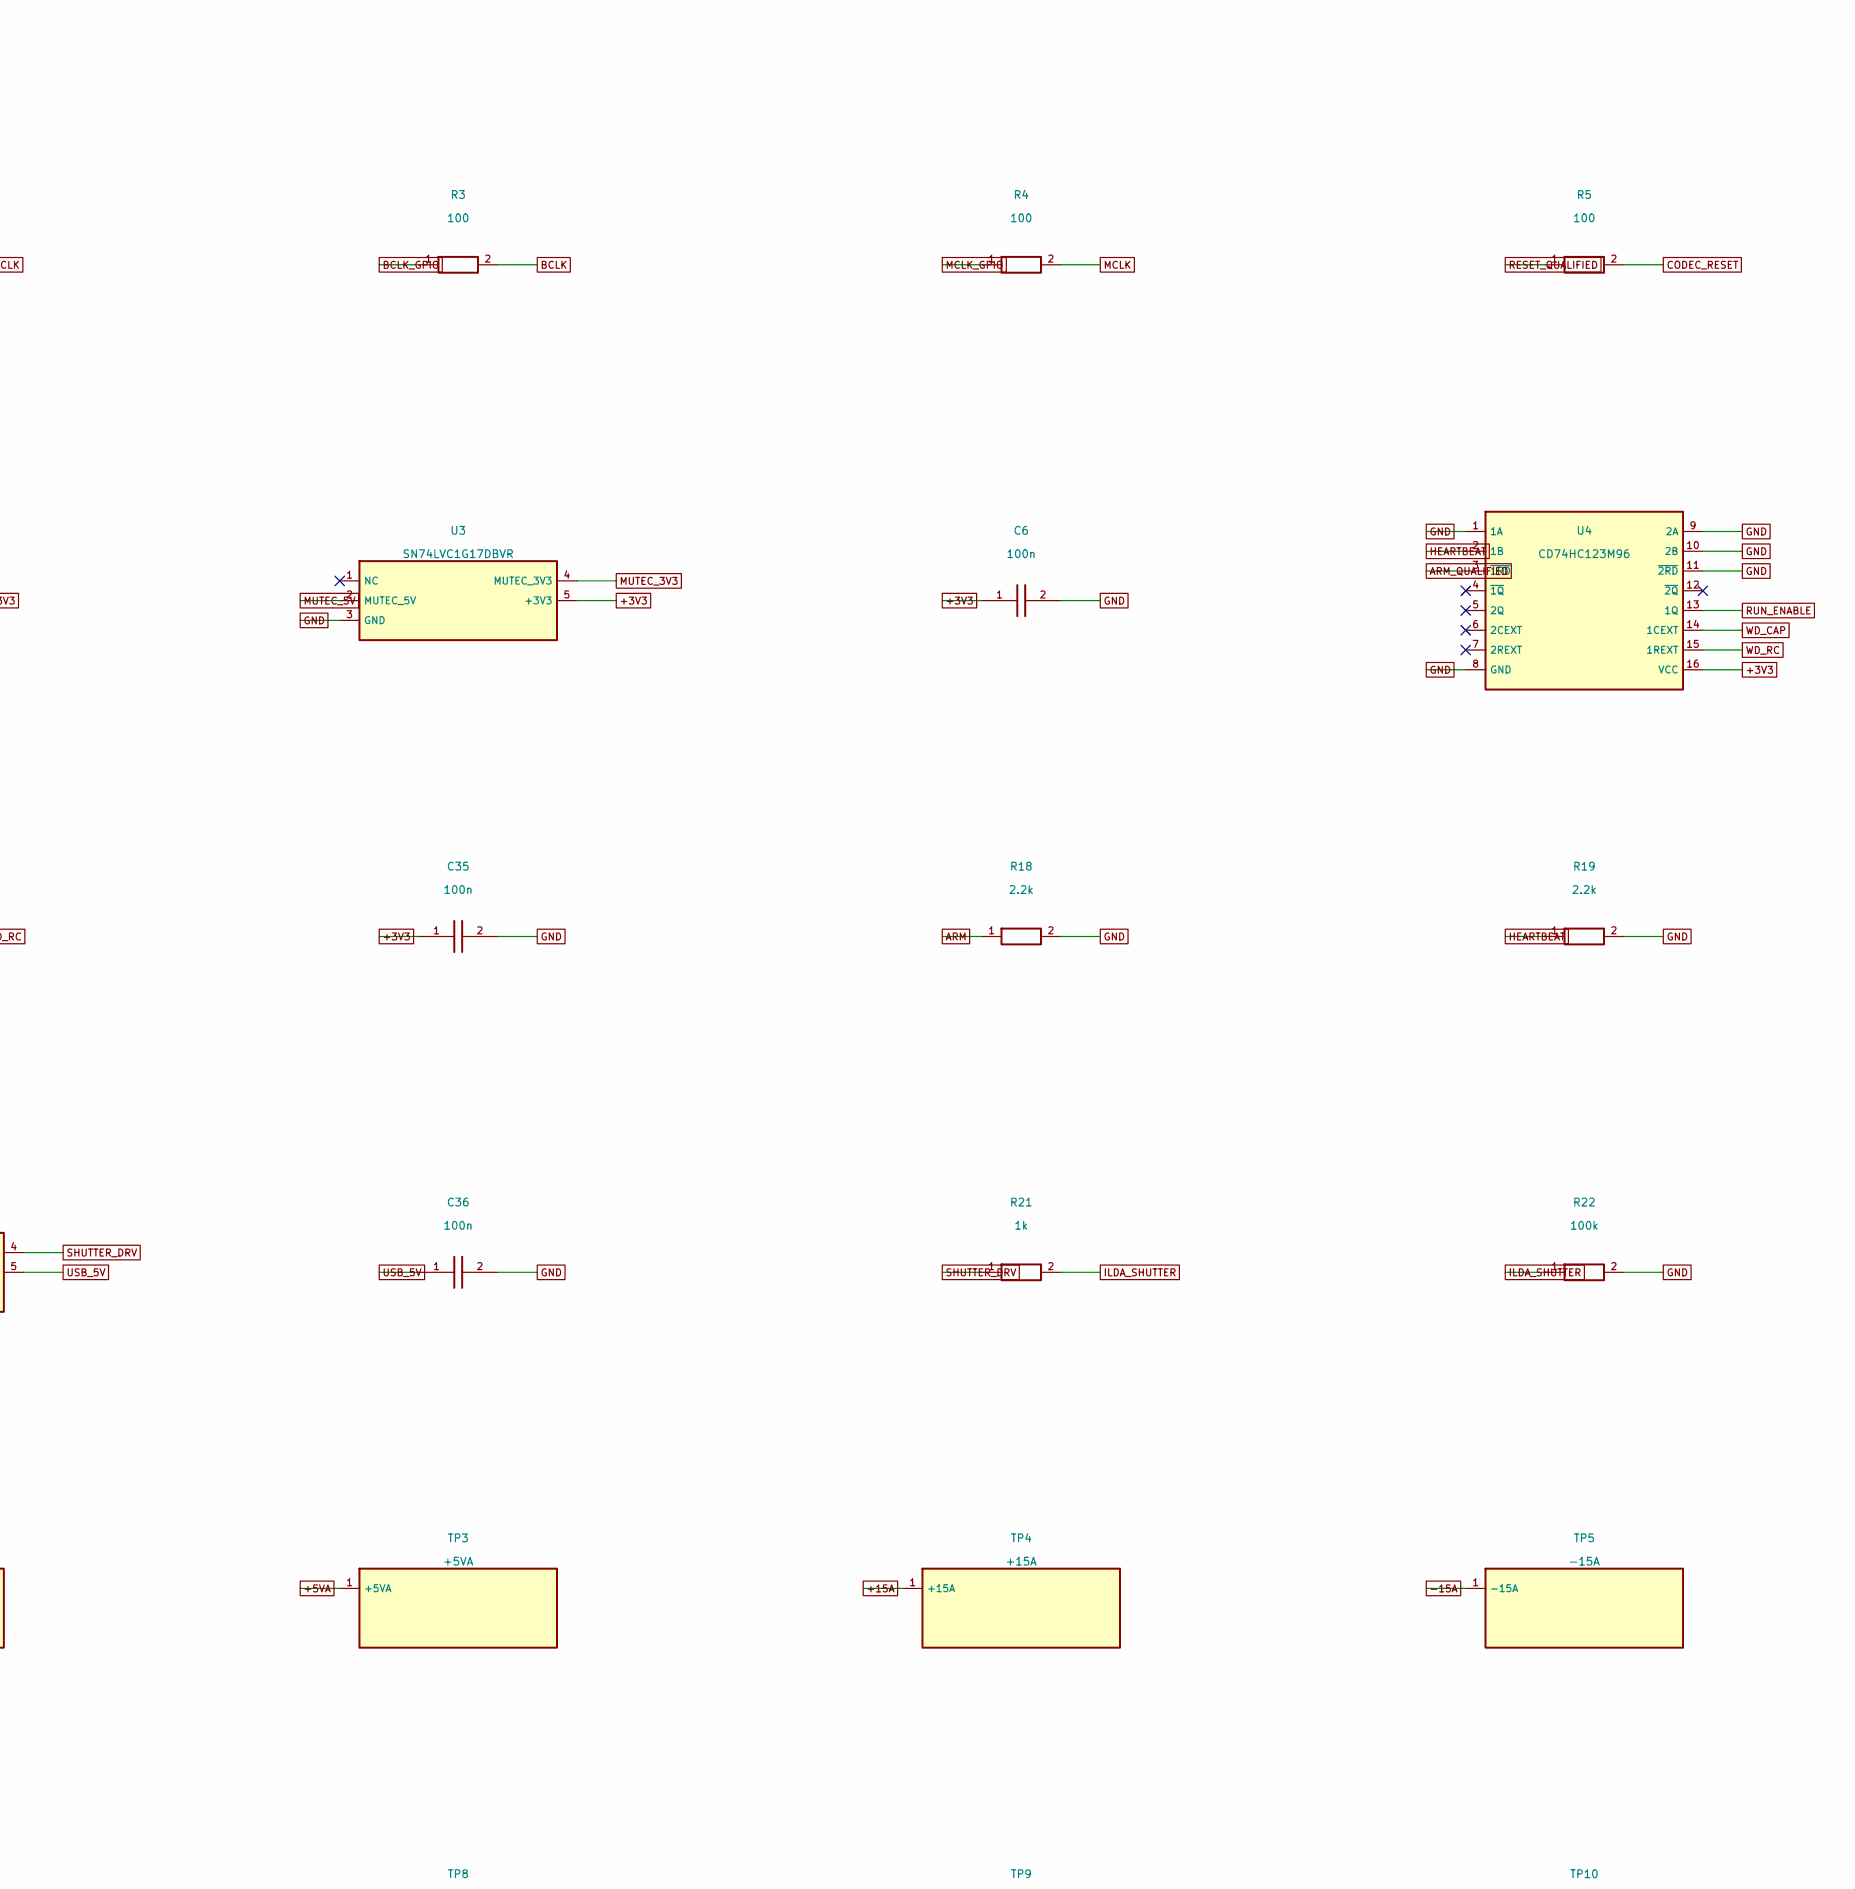
[picture p32: schematic Control.kicad_sch, ILDA8CH RevB-P4 / Control, part in row 1, column 2]

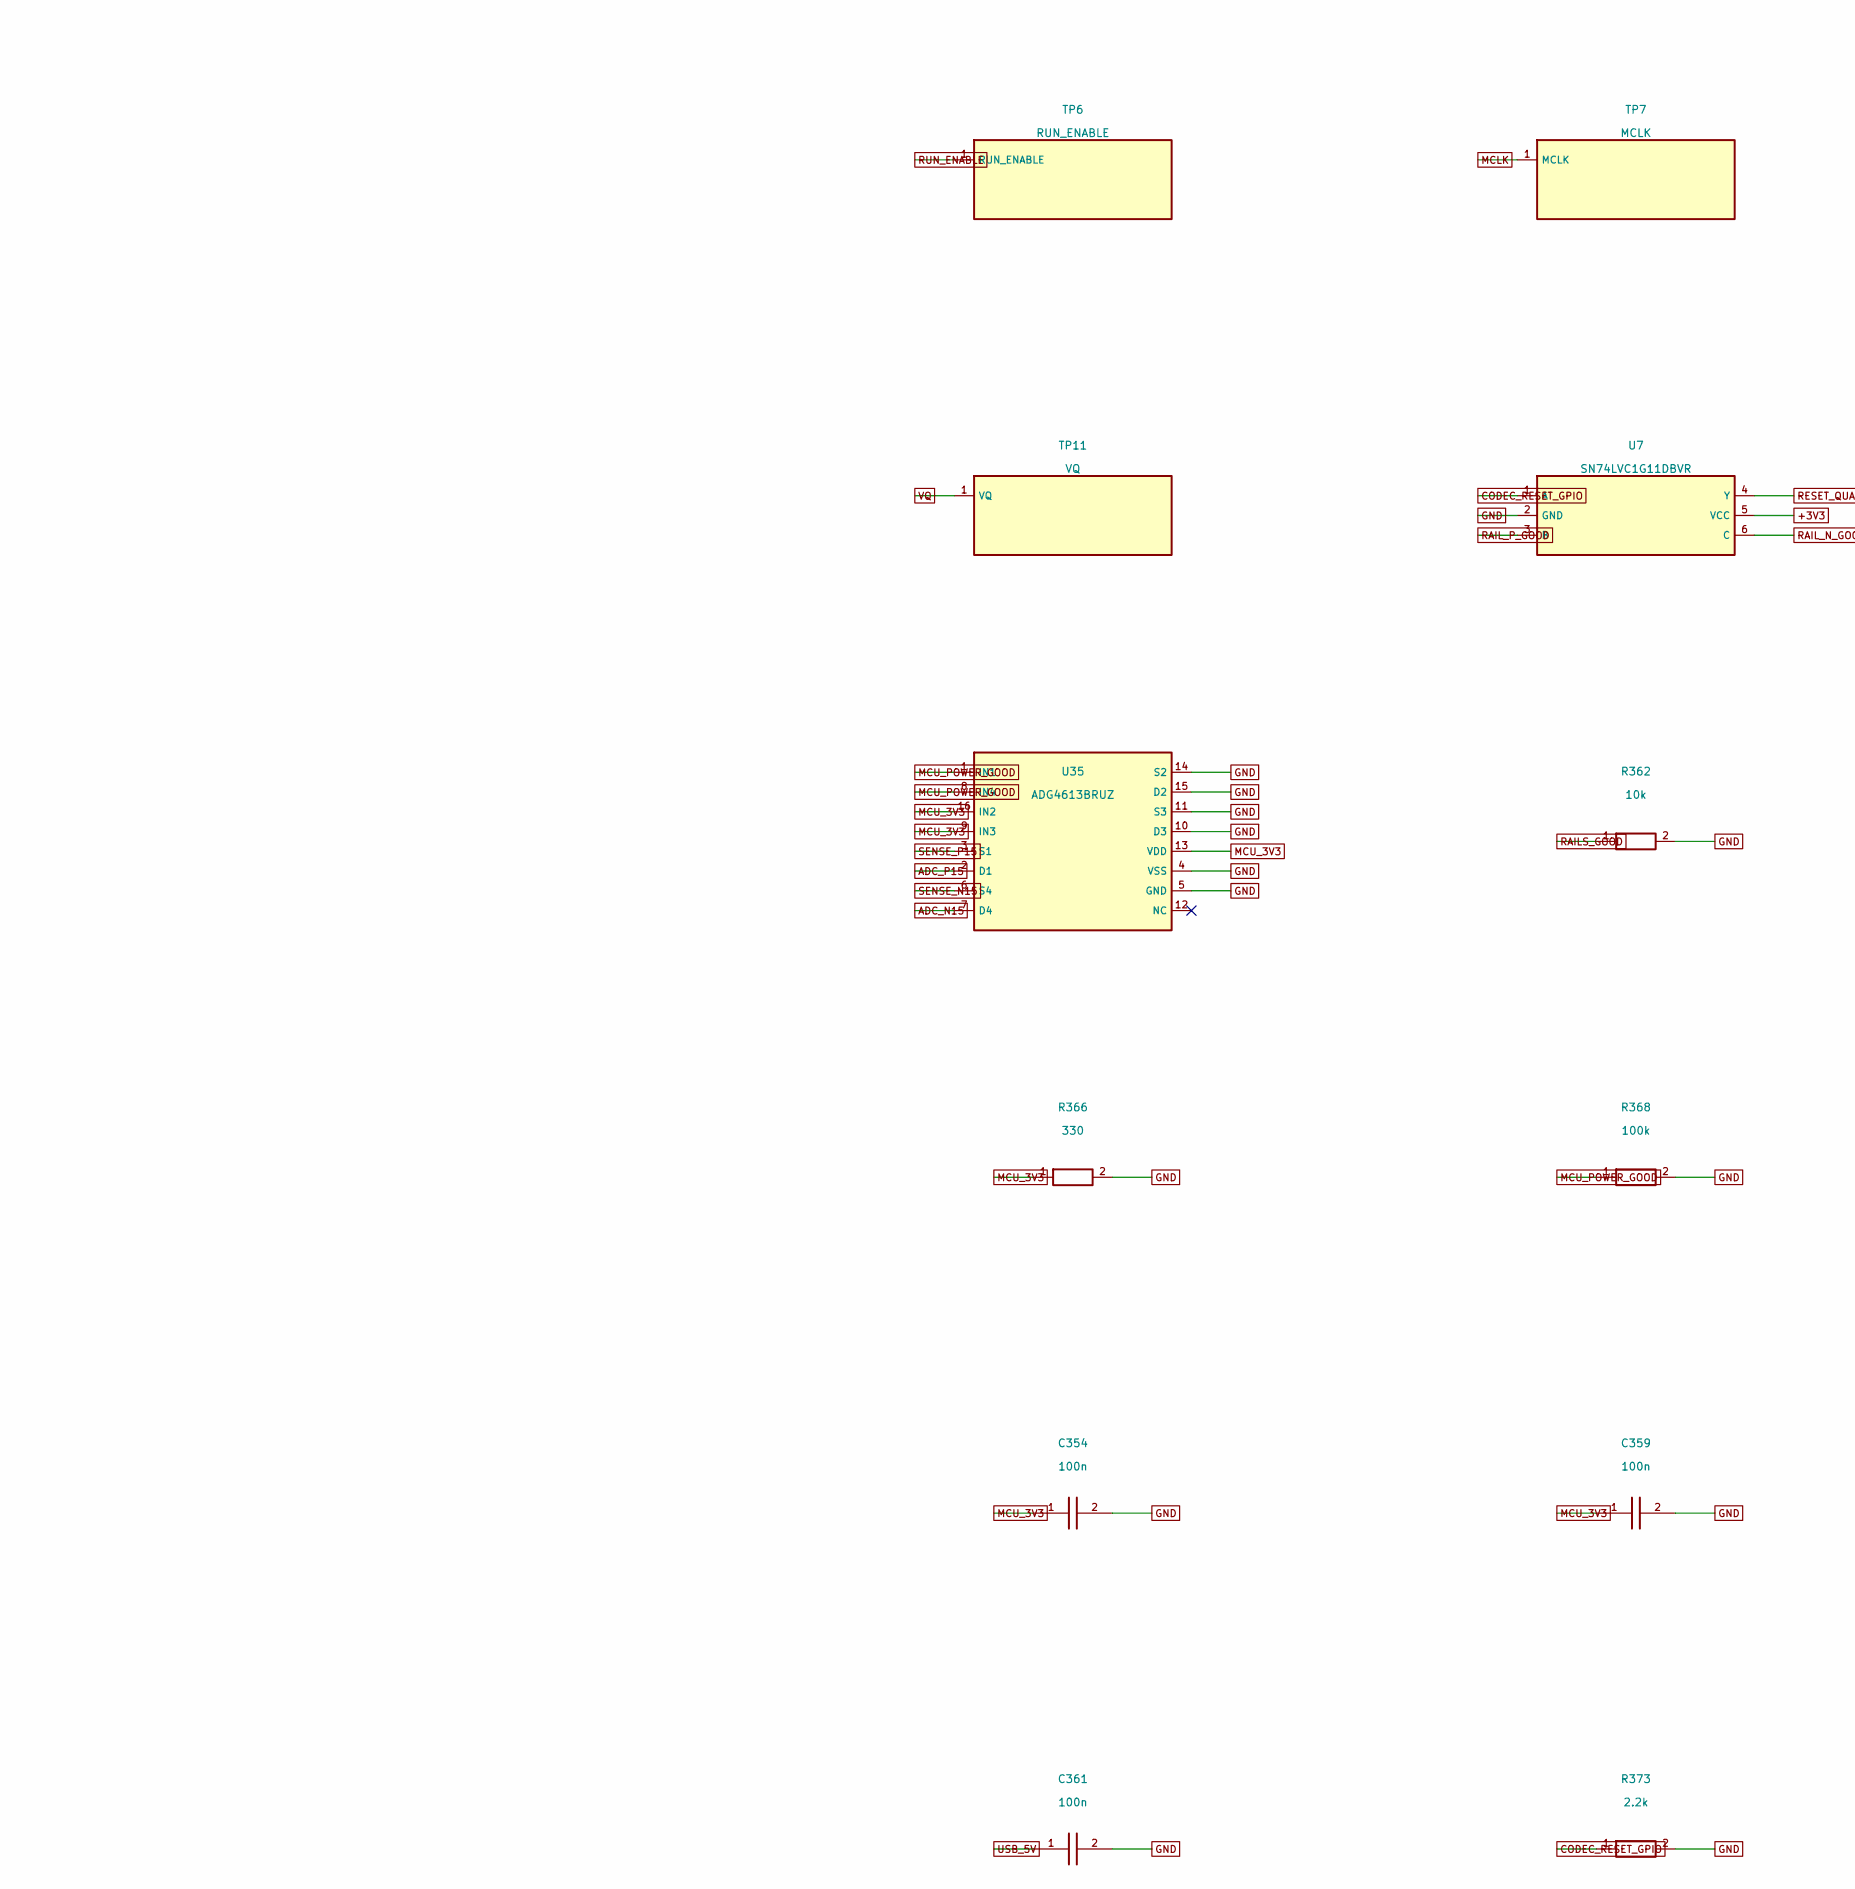
[picture p33: schematic Control.kicad_sch, ILDA8CH RevB-P4 / Control, part in row 2, column 1]

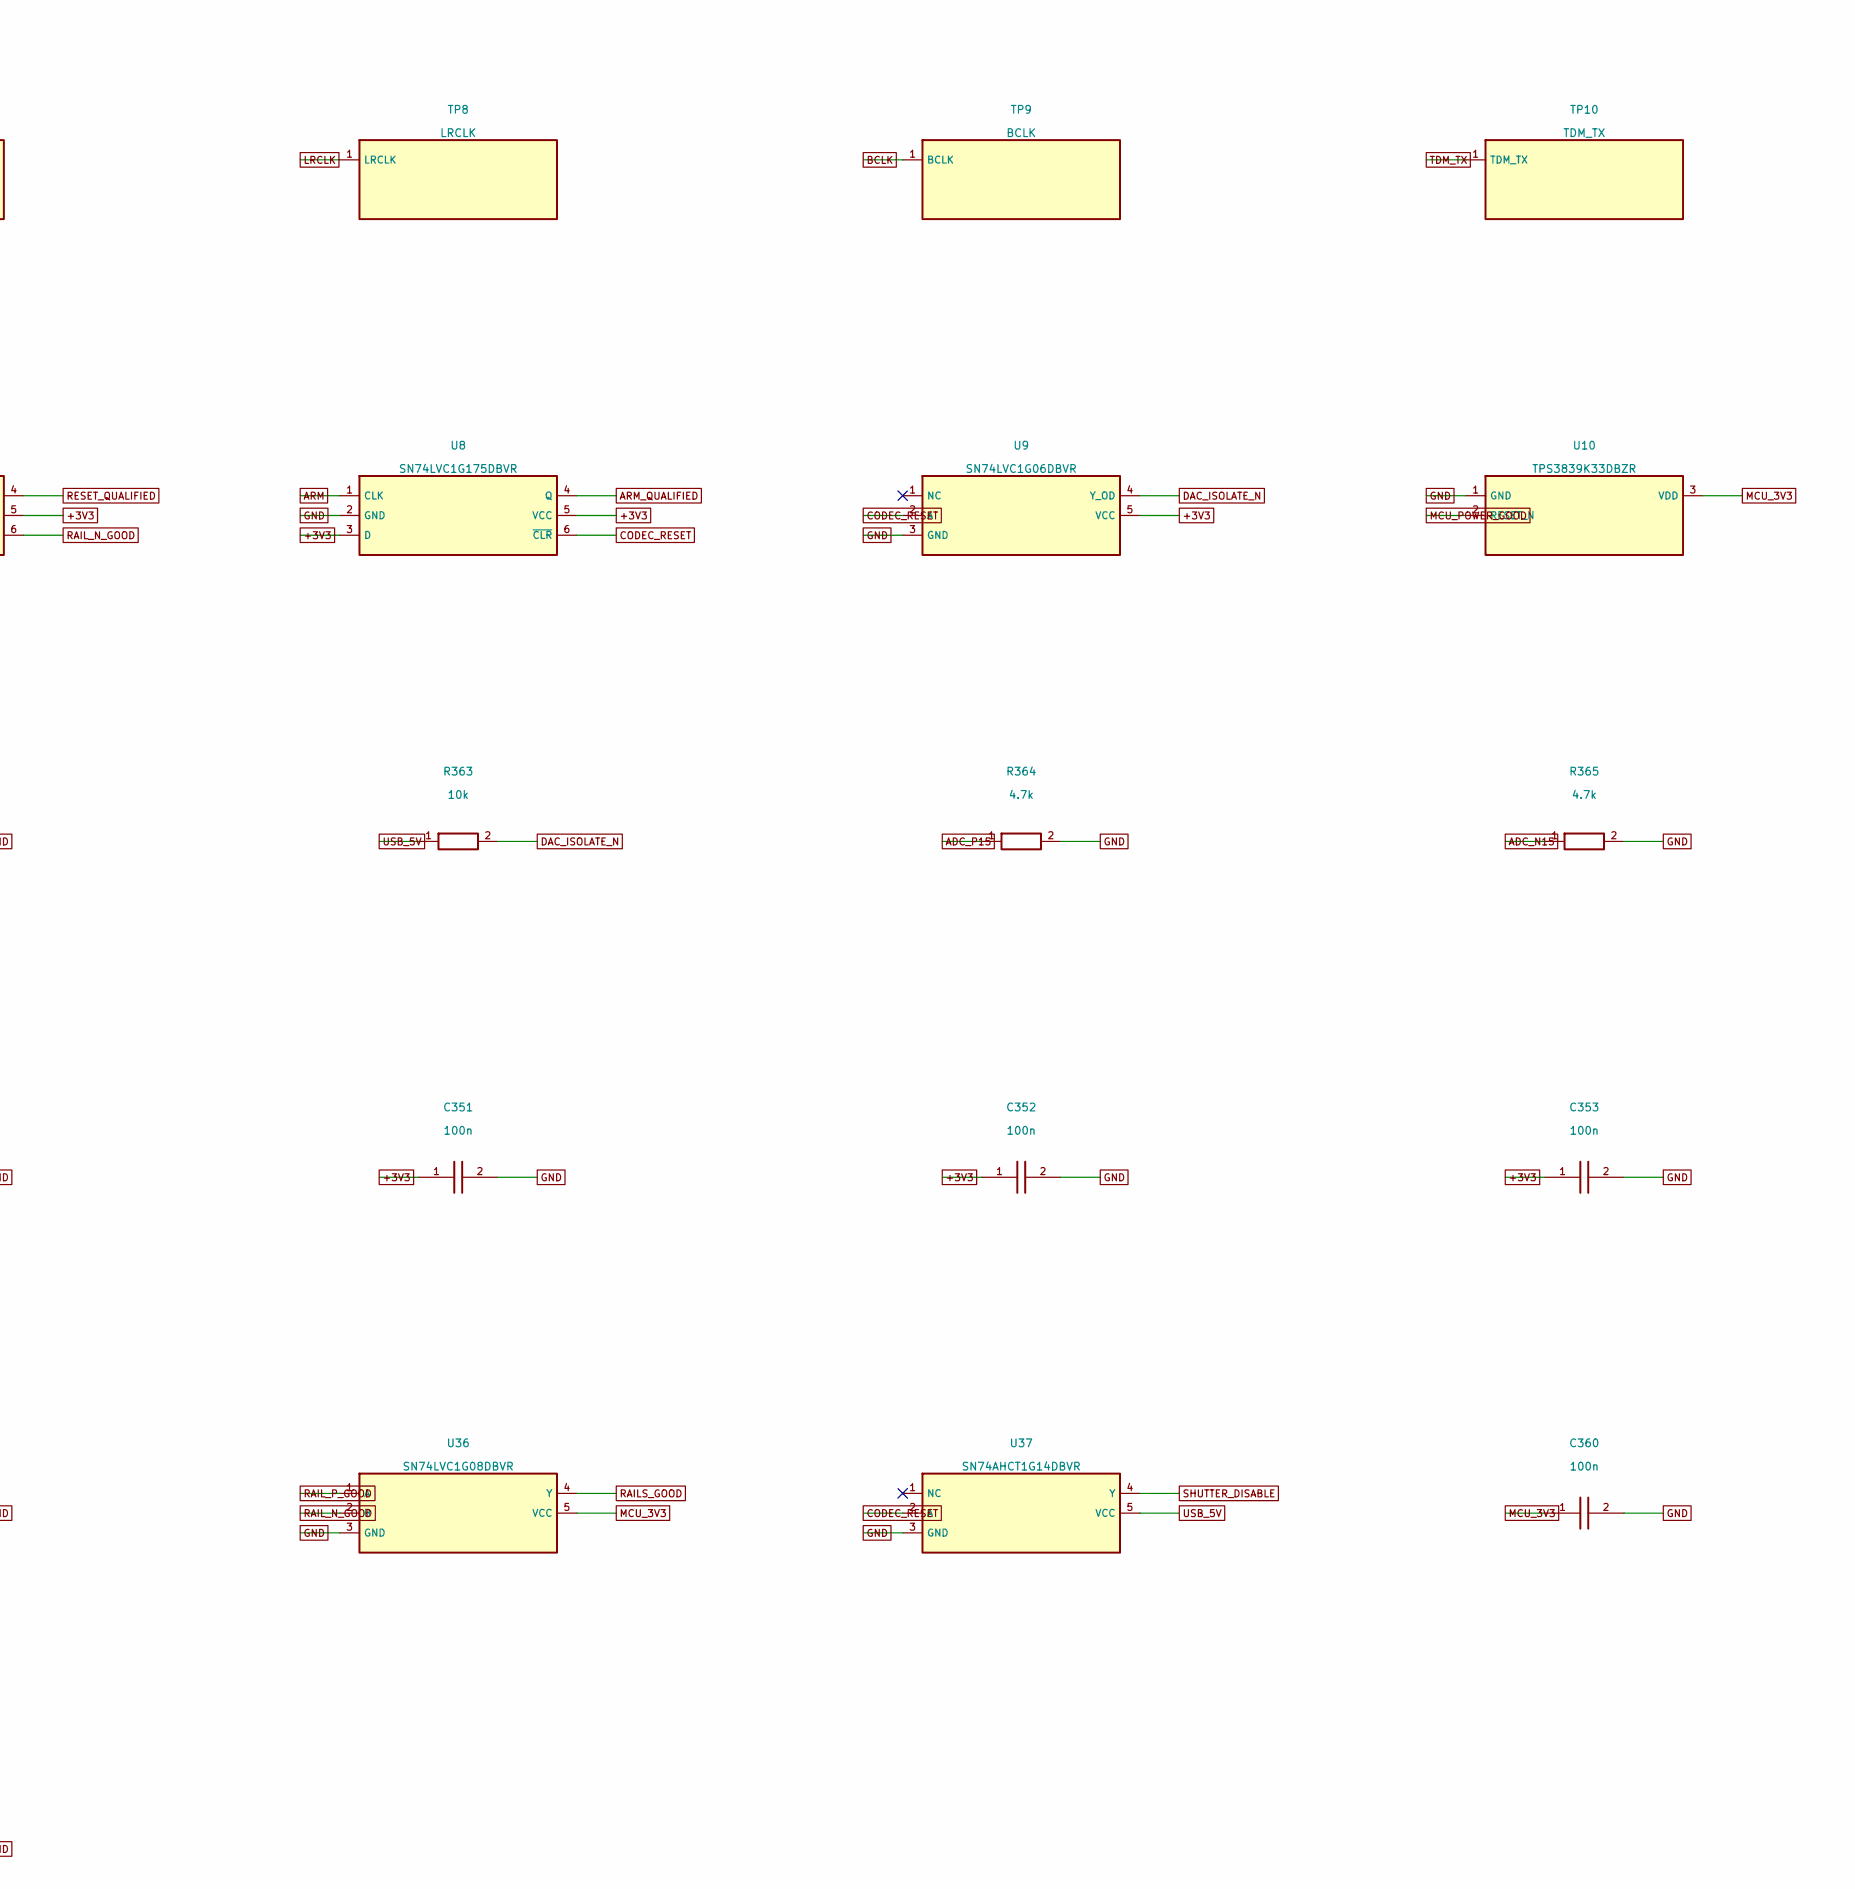
[picture p34: schematic Control.kicad_sch, ILDA8CH RevB-P4 / Control, part in row 2, column 2]

Parts:
A1: Teensy 4.0; Teensy40_Socket; MPN TEENSY40
C6, C34, C35, C36, C351, C352, C353, C354, C359, C360, C361: 100n; Capacitor_SMD__C_0603_1608Metric; MPN GRM188R71H104KA93D; LCSC C77055
R1, R2, R3, R4, R5: 100; Resistor_SMD__R_0603_1608Metric; MPN RC0603FR-07100RL; LCSC C105588
R6, R7, R18, R19, R373: 2.2k; Resistor_SMD__R_0603_1608Metric; MPN RC0603FR-072K2L; LCSC C114662
R17, R22, R368: 100k; Resistor_SMD__R_0603_1608Metric; MPN RC0603FR-07100KL; LCSC C14675
R20, R362, R363: 10k; Resistor_SMD__R_0603_1608Metric; MPN RT0603BRD0710KL; LCSC C95204
R21: 1k; Resistor_SMD__R_0603_1608Metric; MPN RT0603BRD071KL; LCSC C110776
R364, R365: 4.7k; Resistor_SMD__R_0603_1608Metric; MPN RT0603BRD074K7L; LCSC C513565
R366: 330; Resistor_SMD__R_0603_1608Metric; MPN RC0603FR-07330RL; LCSC C105881
TP1: GND; TestPoint__TestPoint_Pad_D1.0mm
TP2: +3V3; TestPoint__TestPoint_Pad_D1.0mm
TP3: +5VA; TestPoint__TestPoint_Pad_D1.0mm
TP4: +15A; TestPoint__TestPoint_Pad_D1.0mm
TP5: -15A; TestPoint__TestPoint_Pad_D1.0mm
TP6: RUN_ENABLE; TestPoint__TestPoint_Pad_D1.0mm
TP7: MCLK; TestPoint__TestPoint_Pad_D1.0mm
TP8: LRCLK; TestPoint__TestPoint_Pad_D1.0mm
TP9: BCLK; TestPoint__TestPoint_Pad_D1.0mm
TP10: TDM_TX; TestPoint__TestPoint_Pad_D1.0mm
TP11: VQ; TestPoint__TestPoint_Pad_D1.0mm
U3: SN74LVC1G17DBVR; Package_TO_SOT_SMD__SOT-23-5; MPN SN74LVC1G17DBVR; LCSC C7836
U4: CD74HC123M96; Package_SO__SOIC-16_3.9x9.9mm_P1.27mm; MPN CD74HC123M96; LCSC C133784
U5: SN74AHCT1G125DBVR; Package_TO_SOT_SMD__SOT-23-5; MPN SN74AHCT1G125DBVR; LCSC C7484
U7: SN74LVC1G11DBVR; Package_TO_SOT_SMD__SOT-23-6; MPN SN74LVC1G11DBVR; LCSC C22046
U8: SN74LVC1G175DBVR; Package_TO_SOT_SMD__SOT-23-6; MPN SN74LVC1G175DBVR; LCSC C128412
U9: SN74LVC1G06DBVR; Package_TO_SOT_SMD__SOT-23-5; MPN SN74LVC1G06DBVR; LCSC C840103
U10: TPS3839K33DBZR; Package_TO_SOT_SMD__SOT-23; MPN TPS3839K33DBZR; LCSC C96333
U35: ADG4613BRUZ; Package_SO__TSSOP-16_4.4x5mm_P0.65mm; MPN ADG4613BRUZ; LCSC C657392
U36: SN74LVC1G08DBVR; Package_TO_SOT_SMD__SOT-23-5; MPN SN74LVC1G08DBVR; LCSC C7666
U37: SN74AHCT1G14DBVR; Package_TO_SOT_SMD__SOT-23-5; MPN SN74AHCT1G14DBVR; LCSC C55250

Connections:
+3V3: C6.1, C35.1, C351.1, C352.1, C353.1, R6.2, R7.2, R17.1, TP2.1, U3.5 (+3V3), U4.16 (VCC), U7.5 (VCC), U8.3 (D), U8.5 (VCC), U9.5 (VCC); also elsewhere on the board
+5VA: TP3.1; also elsewhere on the board
+15A: TP4.1; also elsewhere on the board
-15A: TP5.1; also elsewhere on the board
ADC_N15: A1.17 (ADC_N15), R365.1, U35.7 (D4)
ADC_P15: A1.16 (ADC_P15), R364.1, U35.2 (D1)
ARM: A1.8 (ARM), R18.1, U8.1 (CLK)
ARM_QUALIFIED: U4.3 (~1RD), U8.4 (Q)
BCLK: R3.2, TP9.1; also elsewhere on the board
BCLK_GPIO: A1.23 (BCLK_GPIO), R3.1
CODEC_INT: A1.5 (CODEC_INT); also elsewhere on the board
CODEC_RESET: R5.2, U8.6 (~CLR), U9.2 (A), U37.2 (A); also elsewhere on the board
CODEC_RESET_GPIO: A1.4 (CODEC_RESET_GPIO), R373.1, U7.1 (A)
DAC_ISOLATE_N: R363.2, U9.4 (Y_OD); also elsewhere on the board
GND: A1.1 (GND), A1.27 (GND), C6.2, C35.2, C36.2, C351.2, C352.2, C353.2, C354.2, C359.2, C360.2, C361.2, R18.2, R19.2, R20.2, R22.2, R362.2, R364.2, R365.2, R366.2, R368.2, R373.2, TP1.1, U3.3 (GND), U4.1 (1A), U4.8 (GND), U4.9 (2A), U4.10 (2B), U4.11 (~2RD), U5.3 (GND), U7.2 (GND), U8.2 (GND), U9.3 (GND), U10.1 (GND), U35.4 (VSS), U35.5 (GND), U35.10 (D3), U35.11 (S3), U35.14 (S2), U35.15 (D2), U36.3 (GND), U37.3 (GND); also elsewhere on the board
HEARTBEAT: A1.6 (HEARTBEAT), R19.1, U4.2 (1B)
ILDA_SHUTTER: R21.2, R22.1; also elsewhere on the board
LRCLK: R2.2, TP8.1; also elsewhere on the board
LRCLK_GPIO: A1.22 (LRCLK_GPIO), R2.1
MCLK: R4.2, TP7.1; also elsewhere on the board
MCLK_GPIO: A1.25 (MCLK_GPIO), R4.1
MCU_3V3: A1.26 (MCU_3V3), C354.1, C359.1, C360.1, R366.1, U10.3 (VDD), U35.9 (IN3), U35.13 (VDD), U35.16 (IN2), U36.5 (VCC); also elsewhere on the board
MCU_POWER_GOOD: R368.1, U10.2 (RESET_N), U35.1 (IN1), U35.8 (IN4)
MUTEC_3V3: A1.11 (MUTEC_3V3), U3.4 (MUTEC_3V3)
MUTEC_5V: U3.2 (MUTEC_5V); also elsewhere on the board
RAILS_GOOD: A1.7 (RAILS_GOOD), R362.1, U36.4 (Y)
RAIL_N_GOOD: U7.6 (C), U36.2 (B); also elsewhere on the board
RAIL_P_GOOD: U7.3 (B), U36.1 (A); also elsewhere on the board
RESET_QUALIFIED: R5.1, U7.4 (Y)
RUN_ENABLE: R20.1, TP6.1, U4.13 (1Q), U5.2 (RUN_ENABLE); also elsewhere on the board
SCL: A1.18 (SCL), R6.1; also elsewhere on the board
SDA: A1.19 (SDA), R7.1; also elsewhere on the board
SENSE_N15: U35.6 (S4); also elsewhere on the board
SENSE_P15: U35.3 (S1); also elsewhere on the board
SHUTTER_DISABLE: U5.1 (SHUTTER_DISABLE), U37.4 (Y)
SHUTTER_DRV: R21.1, U5.4 (SHUTTER_DRV)
TDM_TX: R1.2, TP10.1; also elsewhere on the board
TDM_TX_GPIO: A1.9 (TDM_TX_GPIO), R1.1
USB_5V: A1.28 (USB_5V), C36.1, C361.1, R363.1, U5.5 (USB_5V), U37.5 (VCC); also elsewhere on the board
VQ: TP11.1; also elsewhere on the board
WD_CAP: C34.1, U4.14 (1CEXT)
WD_RC: C34.2, R17.2, U4.15 (1REXT)

Notes on the sheet:
DC coupled. Physical pin numbers; net names are global and channel-unique.
