weiweiweiopen/teensy-4-RGBgalvos/hardware/revB/KiCad/ILDA8CH.kicad_pcb

## KiCad design hardware/revB/KiCad/ILDA8CH.kicad_pcb (continued)

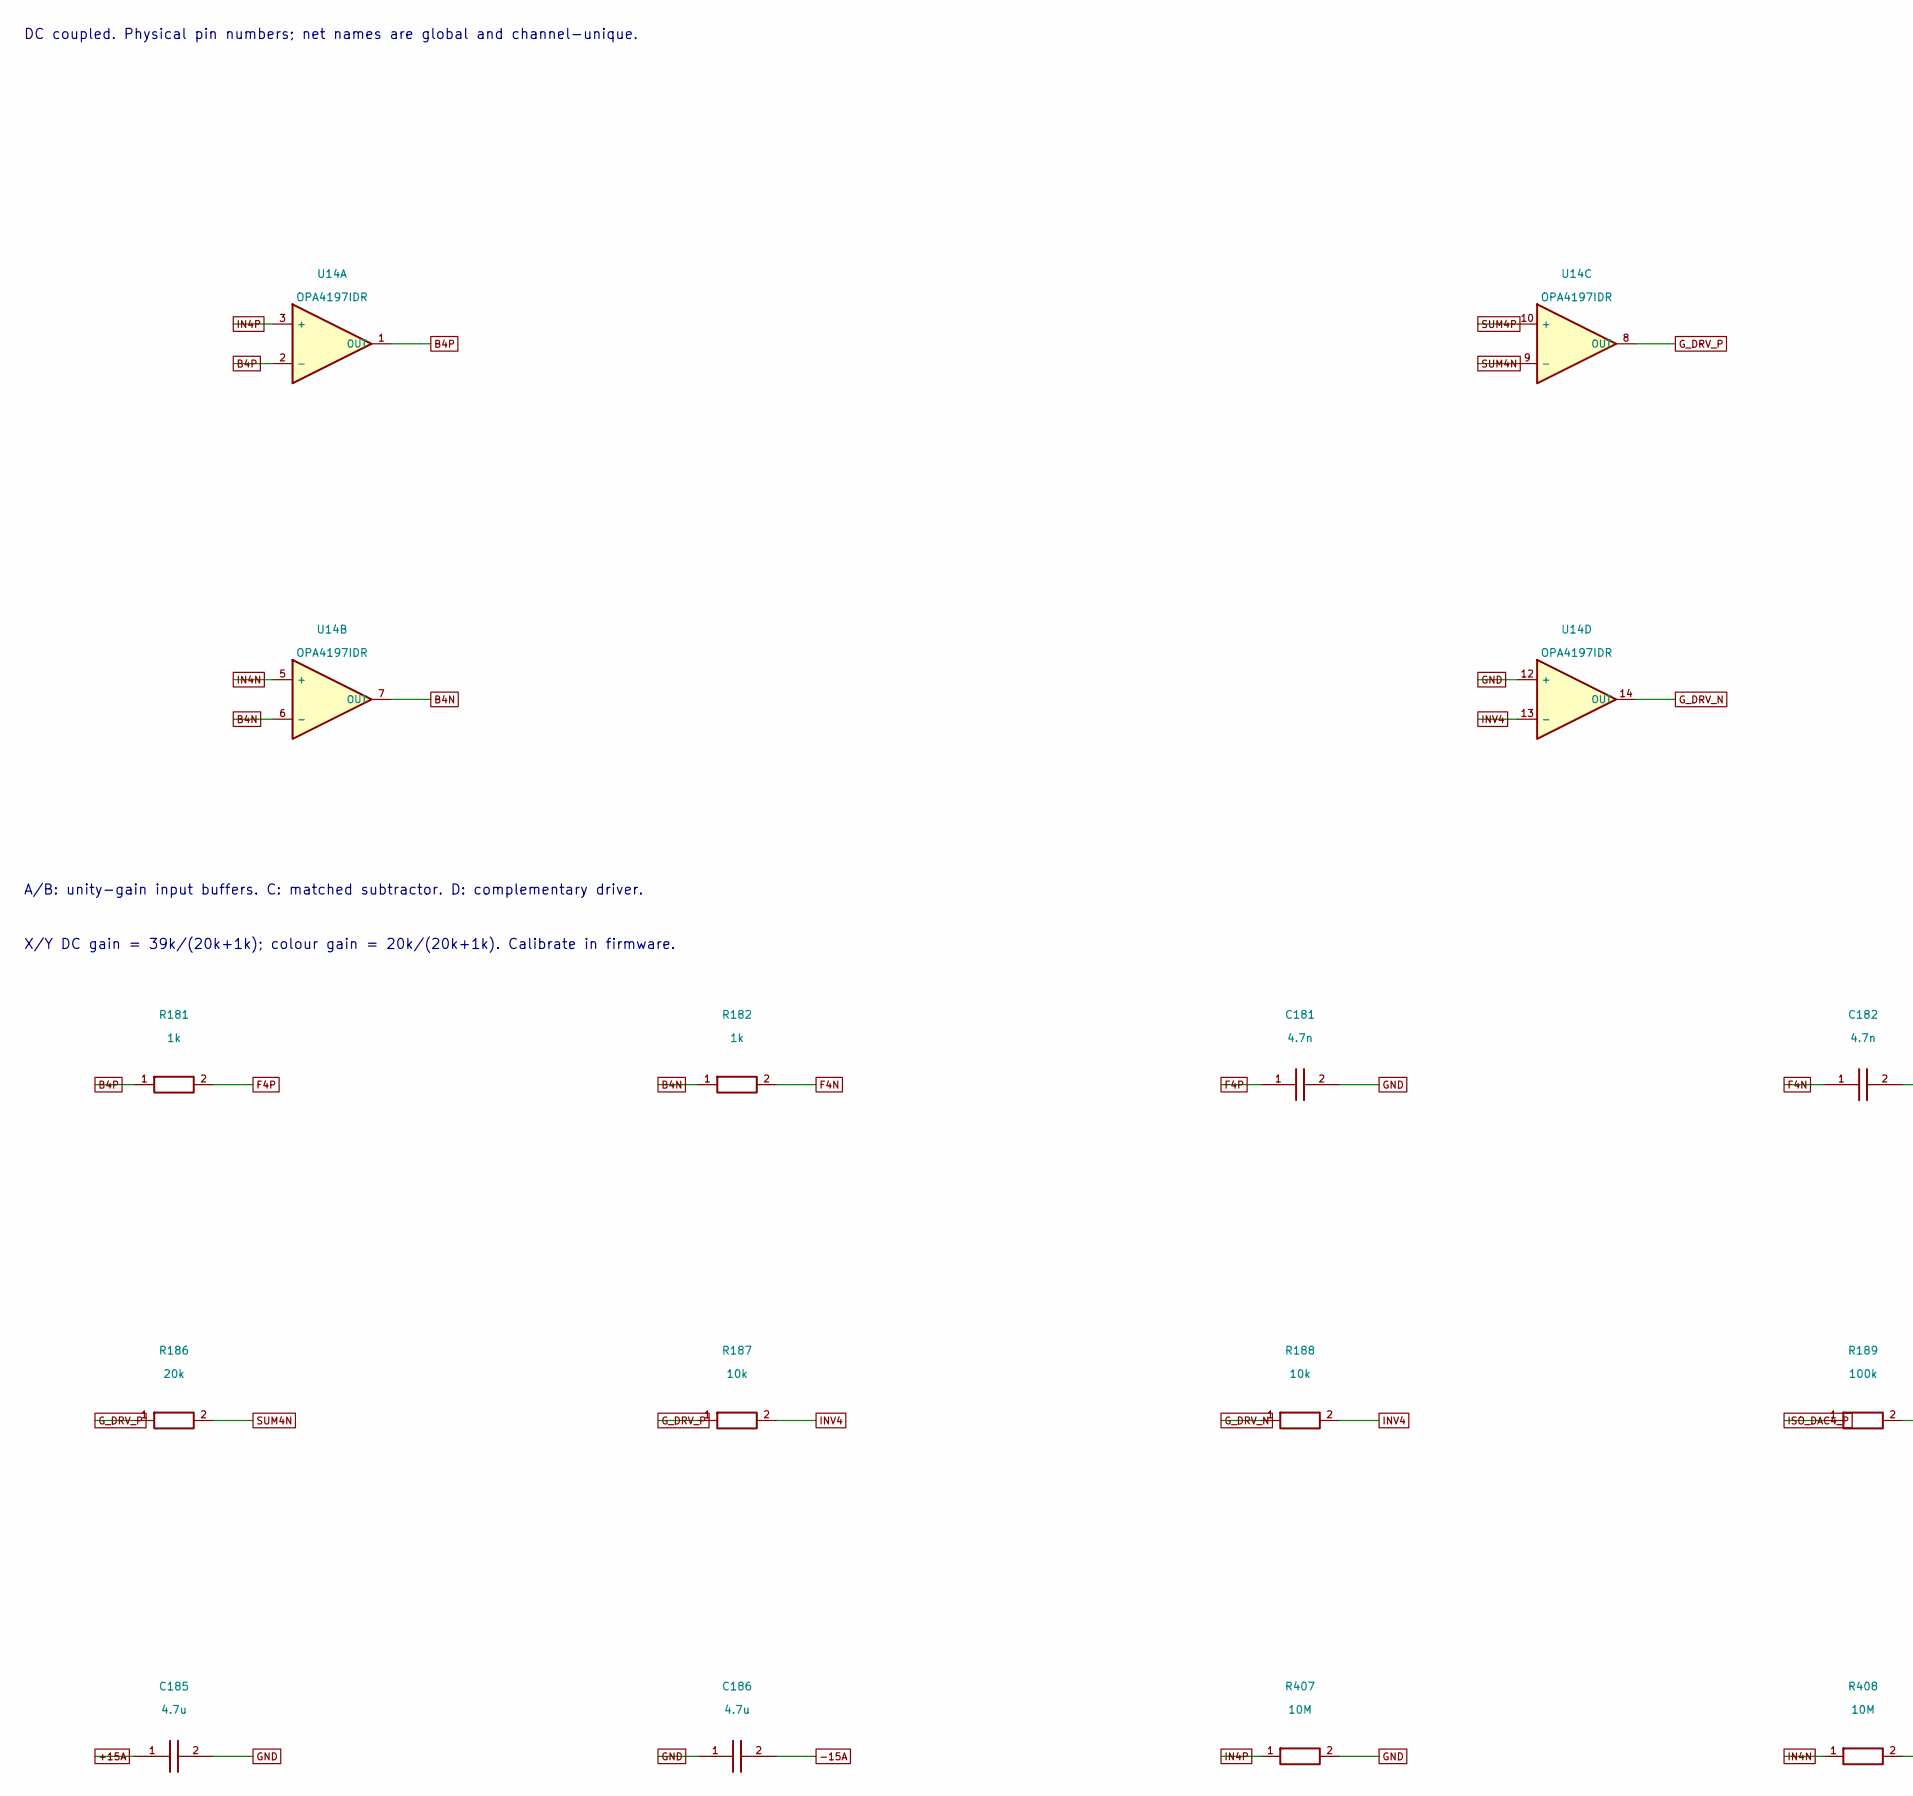
[picture p35: schematic CH4_G.kicad_sch, ILDA8CH RevB-P4 / CH4_G, part in row 1, column 1]

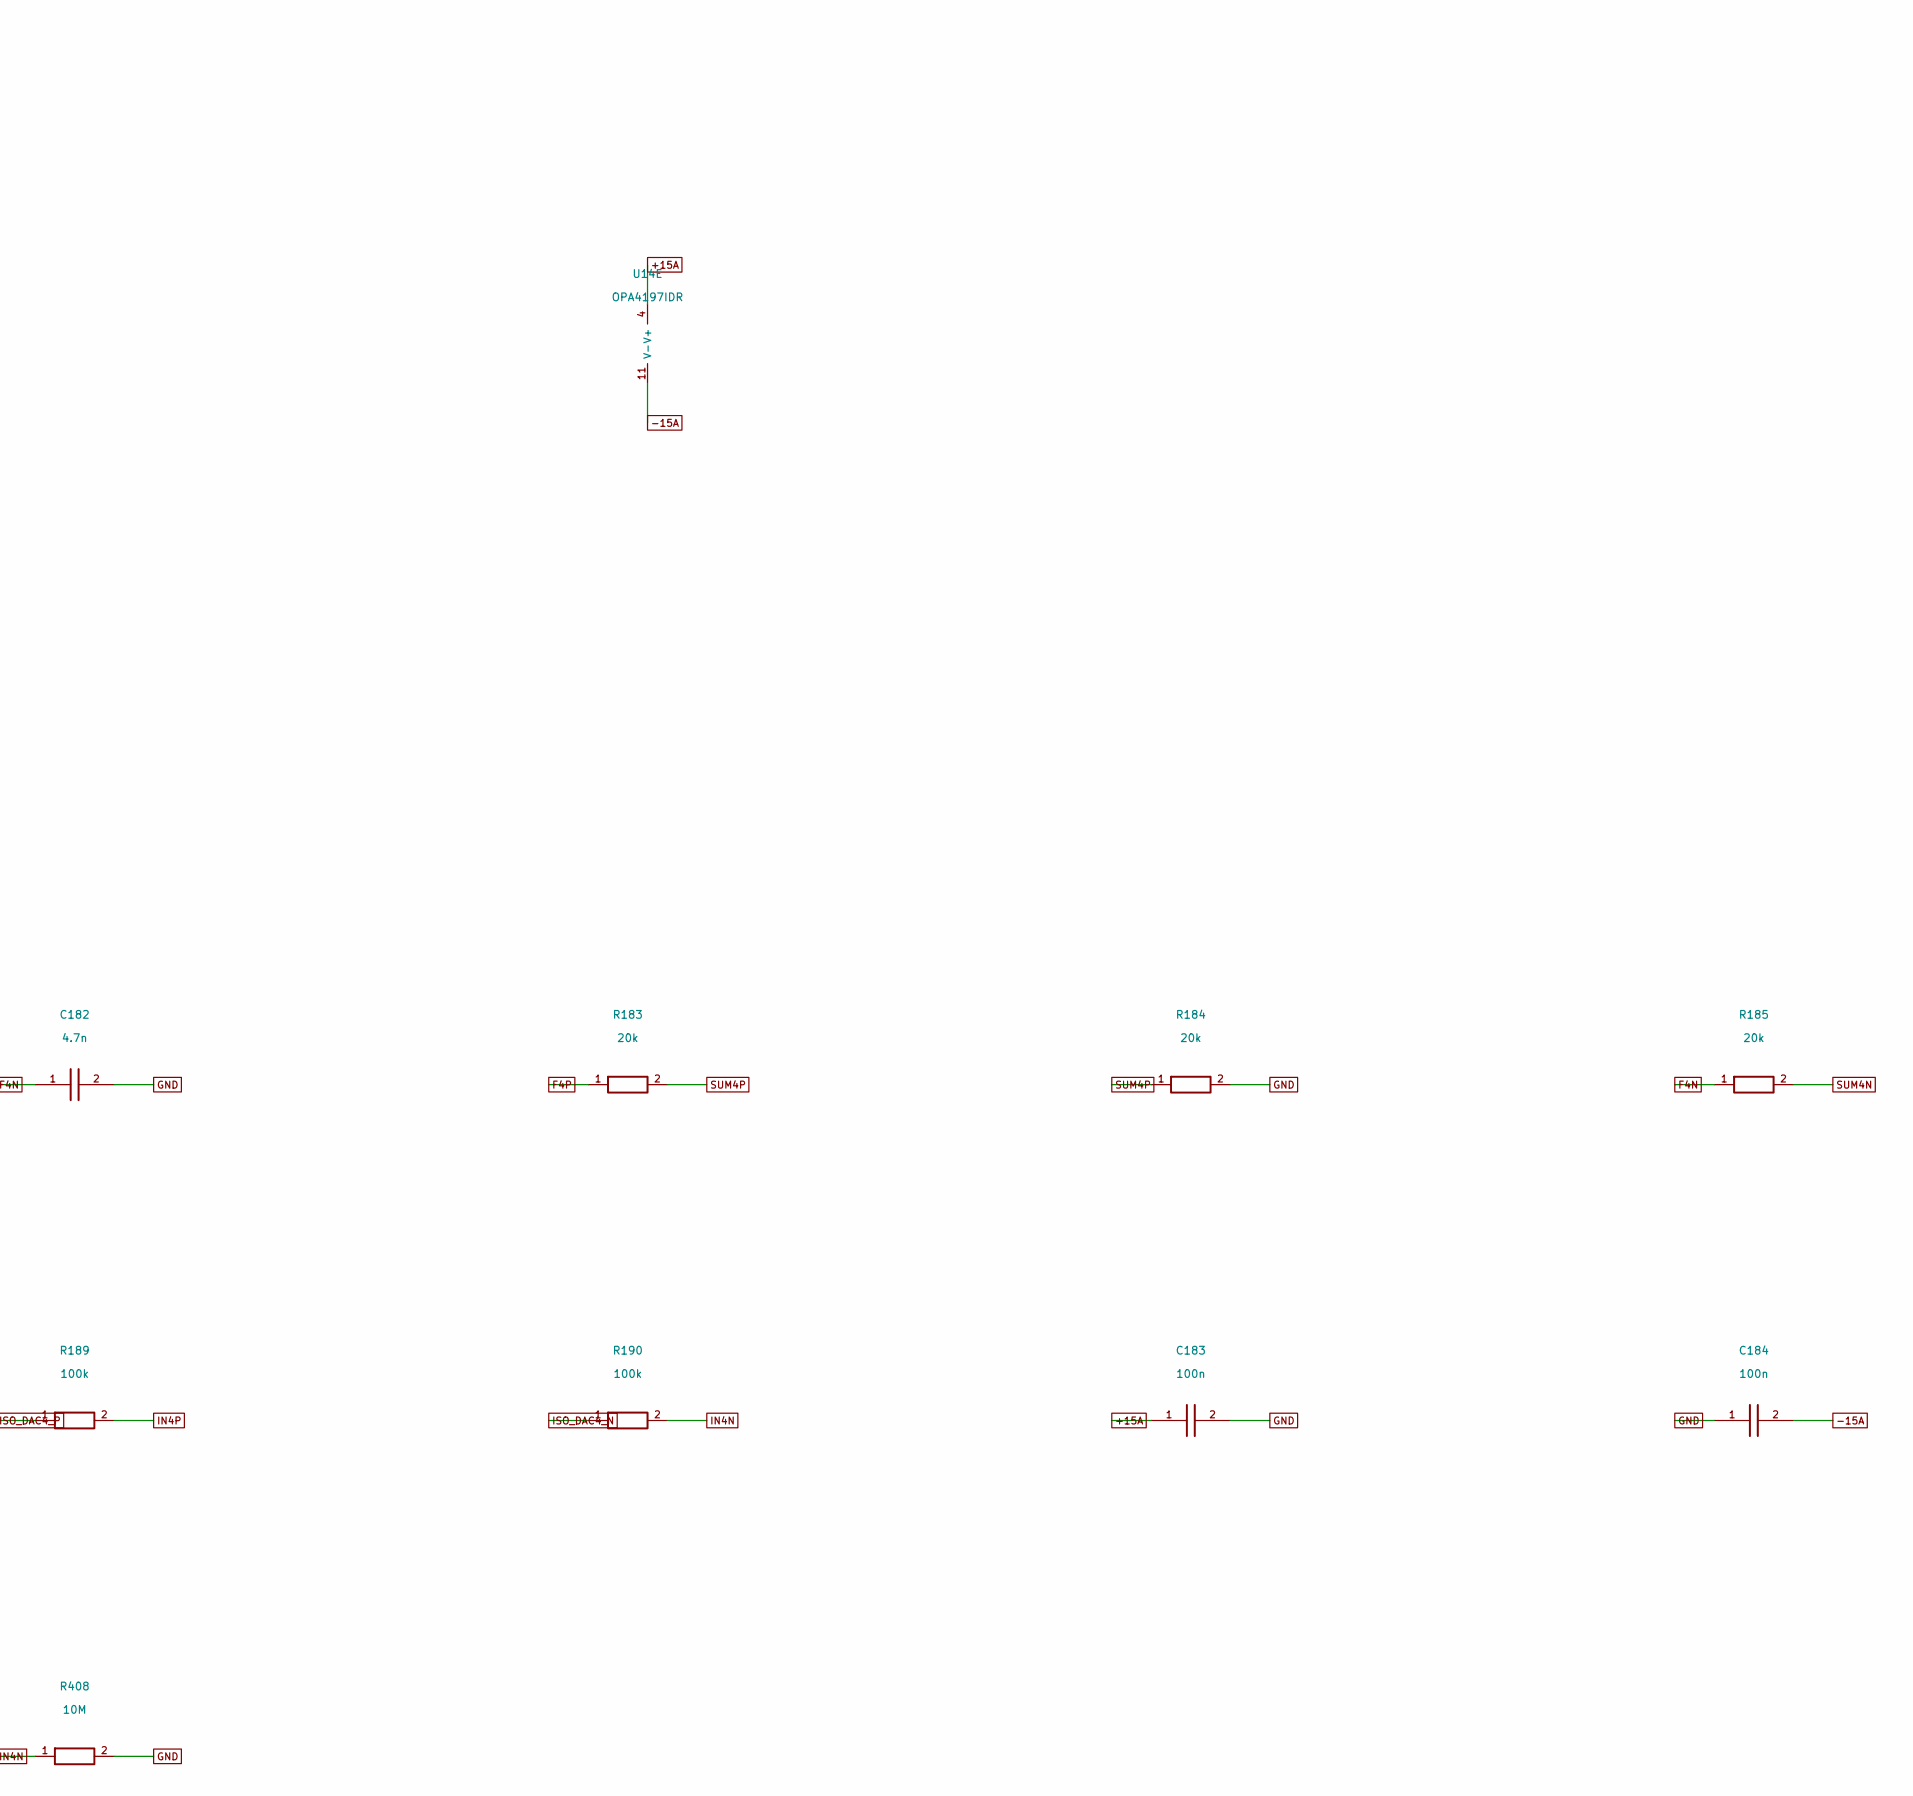
[picture p36: schematic CH4_G.kicad_sch, ILDA8CH RevB-P4 / CH4_G, part in row 1, column 2]

Parts:
C181, C182: 4.7n; Capacitor_SMD__C_0603_1608Metric; MPN GRM1885C1H472JA01D; LCSC C85980
C183, C184: 100n; Capacitor_SMD__C_0603_1608Metric; MPN GRM188R71H104KA93D; LCSC C77055
C185, C186: 4.7u; Capacitor_SMD__C_0805_2012Metric; MPN GRM21BR61E475KA12L; LCSC C77077
R181, R182: 1k; Resistor_SMD__R_0603_1608Metric; MPN RT0603BRD071KL; LCSC C110776
R183, R184, R185, R186: 20k; Resistor_SMD__R_0603_1608Metric; MPN RT0603BRD0720KL; LCSC C723637
R187, R188: 10k; Resistor_SMD__R_0603_1608Metric; MPN RT0603BRD0710KL; LCSC C95204
R189, R190: 100k; Resistor_SMD__R_0603_1608Metric; MPN RC0603FR-07100KL; LCSC C14675
R407, R408: 10M; Resistor_SMD__R_0603_1608Metric; MPN RC0603FR-0710ML; LCSC C114606
U14: OPA4197IDR; Package_SO__SOIC-14_3.9x8.7mm_P1.27mm; MPN OPA4197IDR; LCSC C2058532

Connections:
+15A: C183.1, C185.1, U14.4 (V+); also elsewhere on the board
-15A: C184.2, C186.2, U14.11 (V-); also elsewhere on the board
B4N: R182.1, U14.6 (-), U14.7 (OUT)
B4P: R181.1, U14.1 (OUT), U14.2 (-)
F4N: C182.1, R182.2, R185.1
F4P: C181.1, R181.2, R183.1
GND: C181.2, C182.2, C183.2, C184.1, C185.2, C186.1, R184.2, R407.2, R408.2, U14.12 (+); also elsewhere on the board
G_DRV_N: R188.1, U14.14 (OUT); also elsewhere on the board
G_DRV_P: R186.1, R187.1, U14.8 (OUT); also elsewhere on the board
IN4N: R190.2, R408.1, U14.5 (+)
IN4P: R189.2, R407.1, U14.3 (+)
INV4: R187.2, R188.2, U14.13 (-)
ISO_DAC4_N: R190.1; also elsewhere on the board
ISO_DAC4_P: R189.1; also elsewhere on the board
SUM4N: R185.2, R186.2, U14.9 (-)
SUM4P: R183.2, R184.1, U14.10 (+)

Notes on the sheet:
DC coupled. Physical pin numbers; net names are global and channel-unique.
X/Y DC gain = 39k/(20k+1k); colour gain = 20k/(20k+1k). Calibrate in firmware.
A/B: unity-gain input buffers. C: matched subtractor. D: complementary driver.

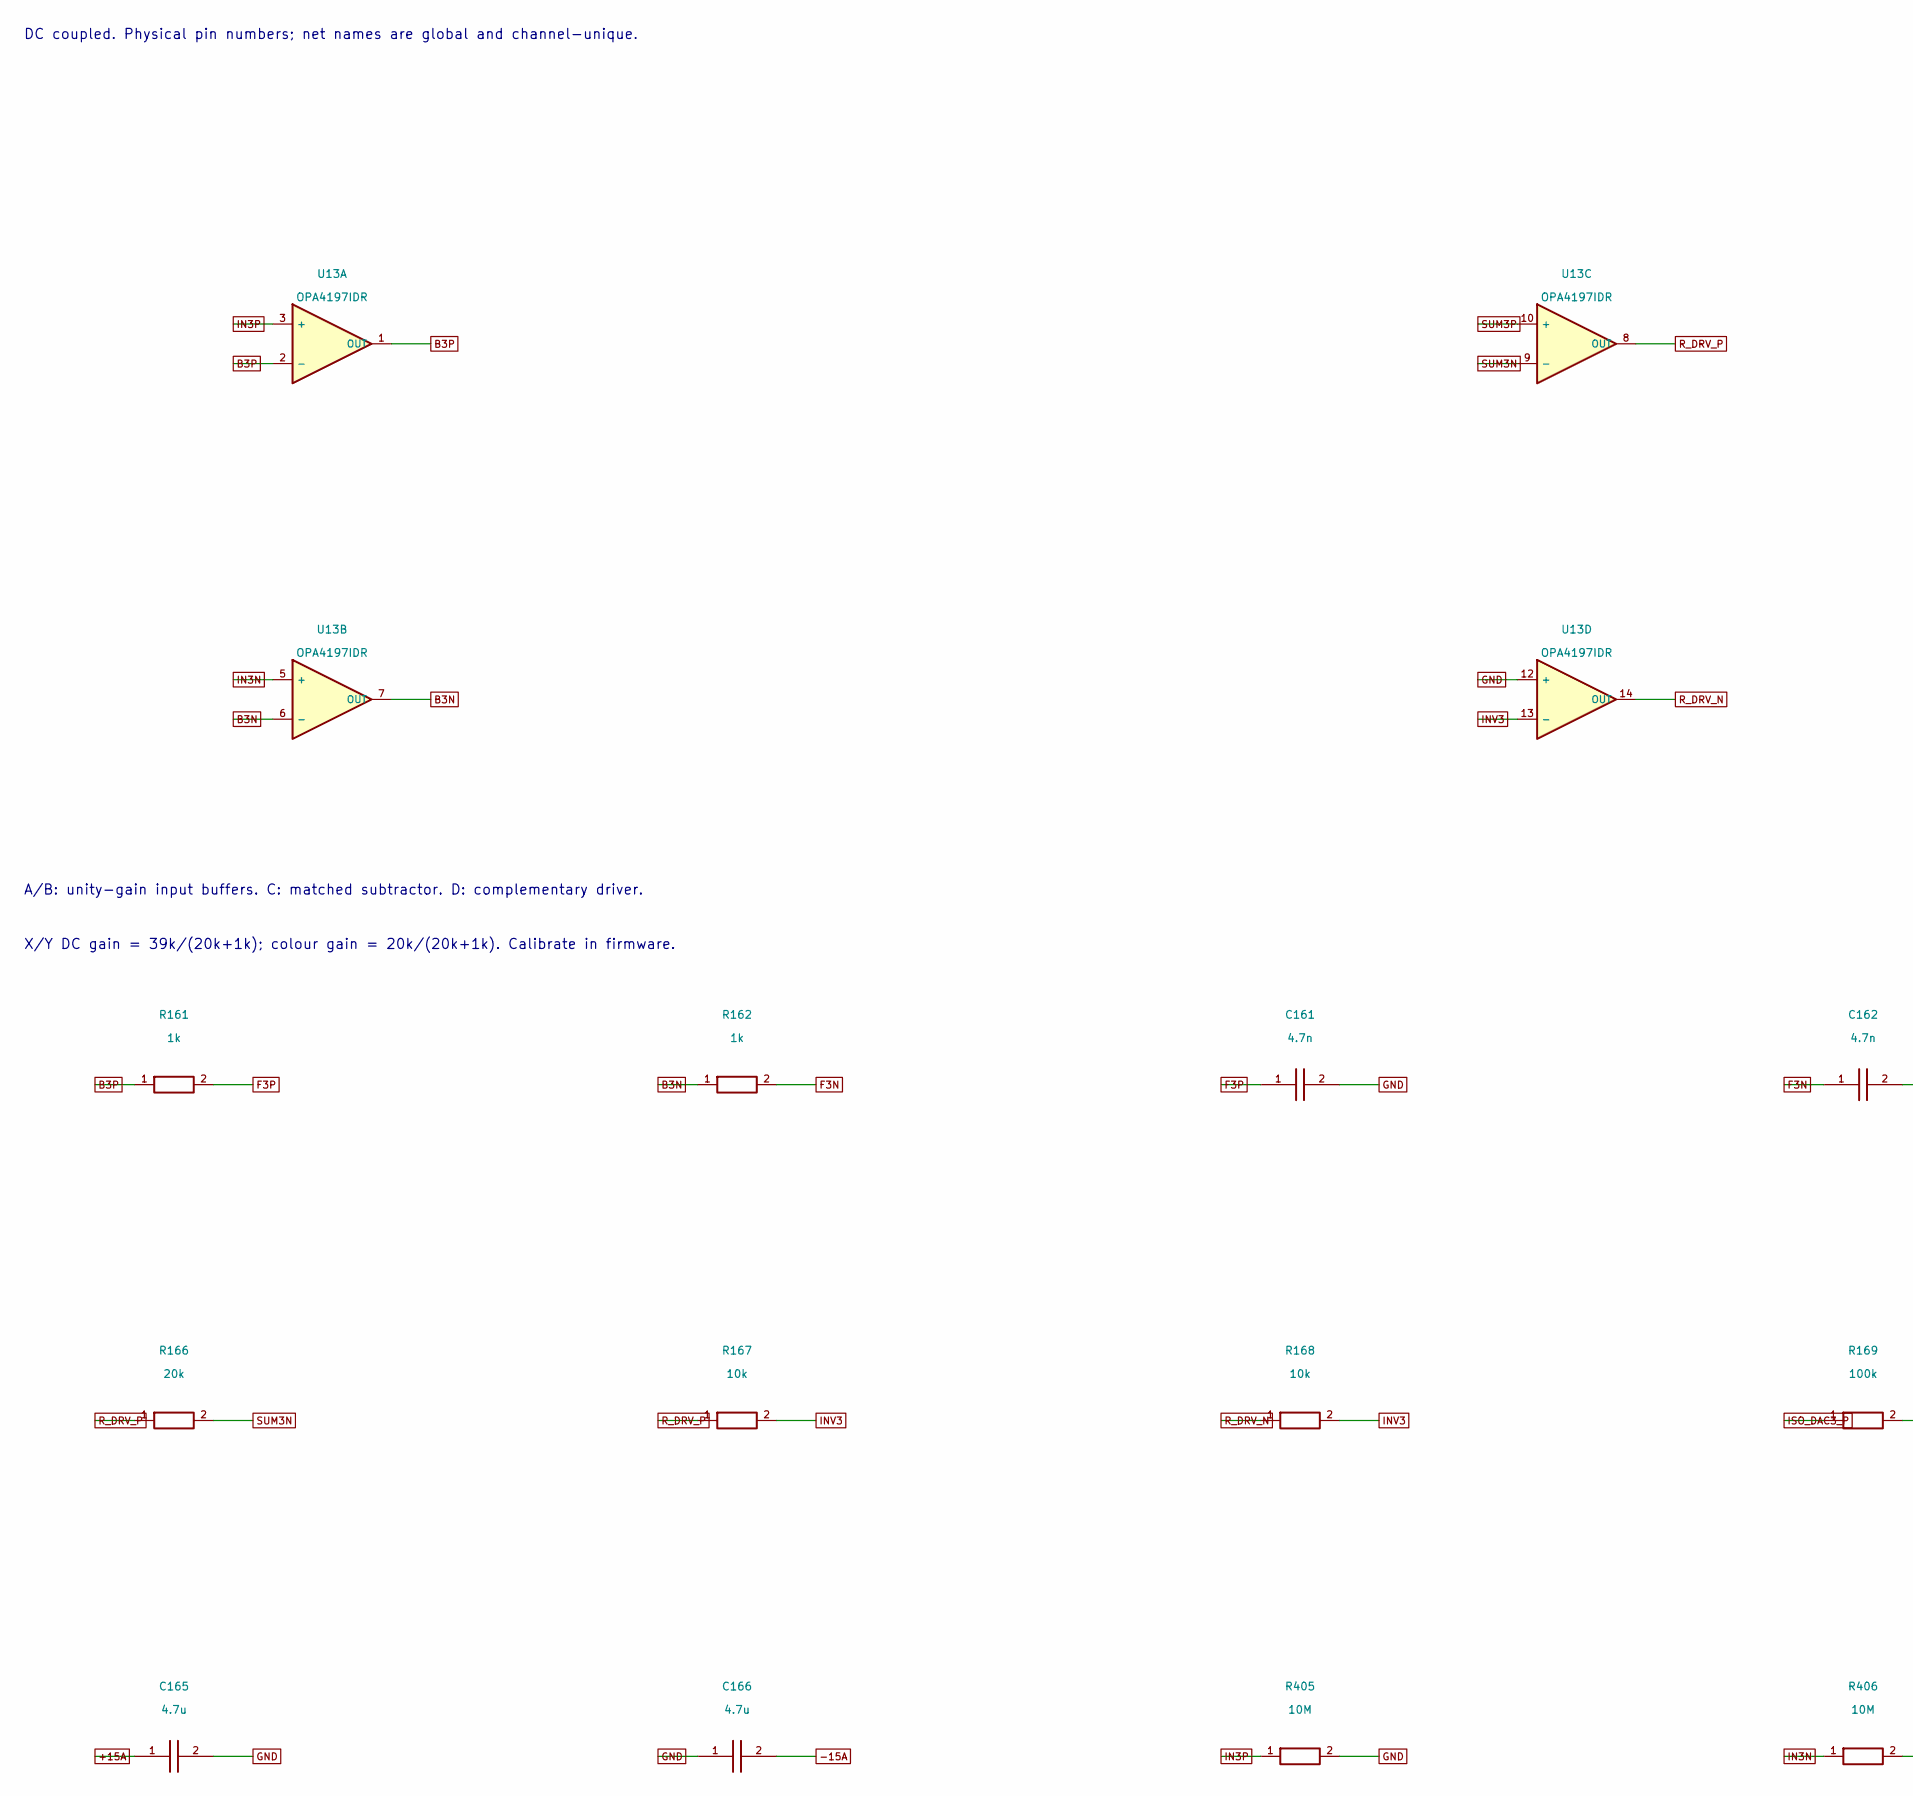
[picture p37: schematic CH3_R.kicad_sch, ILDA8CH RevB-P4 / CH3_R, part in row 1, column 1]

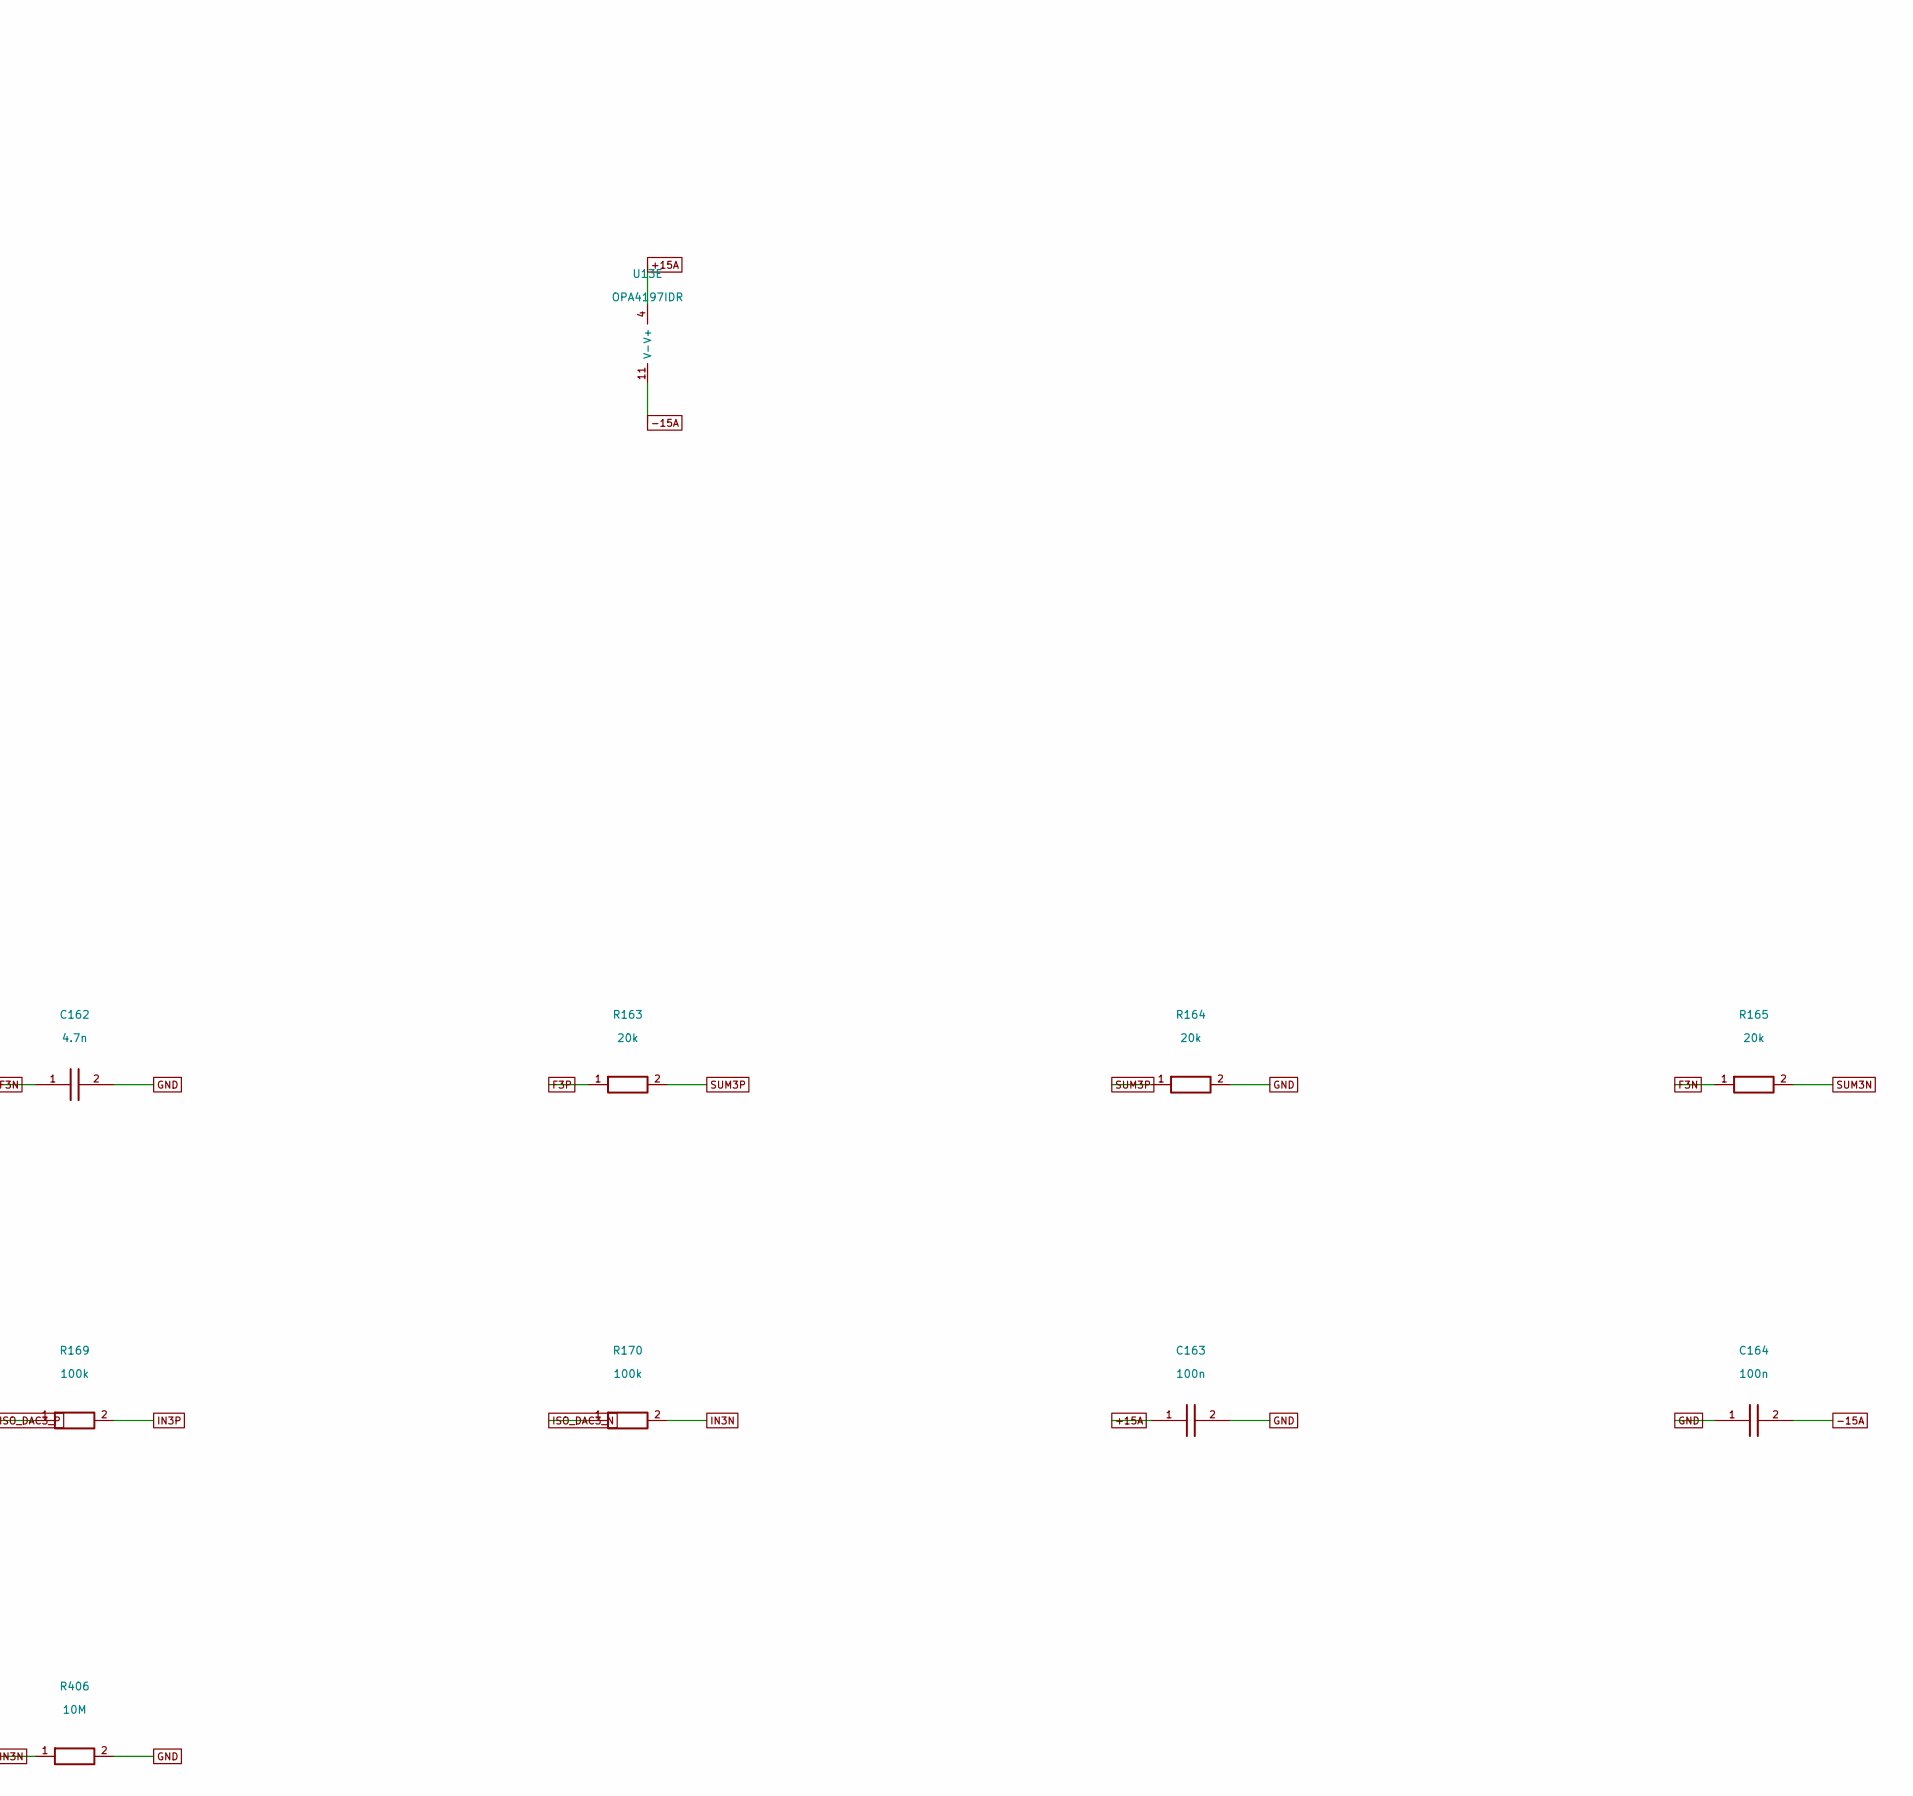
[picture p38: schematic CH3_R.kicad_sch, ILDA8CH RevB-P4 / CH3_R, part in row 1, column 2]

Parts:
C161, C162: 4.7n; Capacitor_SMD__C_0603_1608Metric; MPN GRM1885C1H472JA01D; LCSC C85980
C163, C164: 100n; Capacitor_SMD__C_0603_1608Metric; MPN GRM188R71H104KA93D; LCSC C77055
C165, C166: 4.7u; Capacitor_SMD__C_0805_2012Metric; MPN GRM21BR61E475KA12L; LCSC C77077
R161, R162: 1k; Resistor_SMD__R_0603_1608Metric; MPN RT0603BRD071KL; LCSC C110776
R163, R164, R165, R166: 20k; Resistor_SMD__R_0603_1608Metric; MPN RT0603BRD0720KL; LCSC C723637
R167, R168: 10k; Resistor_SMD__R_0603_1608Metric; MPN RT0603BRD0710KL; LCSC C95204
R169, R170: 100k; Resistor_SMD__R_0603_1608Metric; MPN RC0603FR-07100KL; LCSC C14675
R405, R406: 10M; Resistor_SMD__R_0603_1608Metric; MPN RC0603FR-0710ML; LCSC C114606
U13: OPA4197IDR; Package_SO__SOIC-14_3.9x8.7mm_P1.27mm; MPN OPA4197IDR; LCSC C2058532

Connections:
+15A: C163.1, C165.1, U13.4 (V+); also elsewhere on the board
-15A: C164.2, C166.2, U13.11 (V-); also elsewhere on the board
B3N: R162.1, U13.6 (-), U13.7 (OUT)
B3P: R161.1, U13.1 (OUT), U13.2 (-)
F3N: C162.1, R162.2, R165.1
F3P: C161.1, R161.2, R163.1
GND: C161.2, C162.2, C163.2, C164.1, C165.2, C166.1, R164.2, R405.2, R406.2, U13.12 (+); also elsewhere on the board
IN3N: R170.2, R406.1, U13.5 (+)
IN3P: R169.2, R405.1, U13.3 (+)
INV3: R167.2, R168.2, U13.13 (-)
ISO_DAC3_N: R170.1; also elsewhere on the board
ISO_DAC3_P: R169.1; also elsewhere on the board
R_DRV_N: R168.1, U13.14 (OUT); also elsewhere on the board
R_DRV_P: R166.1, R167.1, U13.8 (OUT); also elsewhere on the board
SUM3N: R165.2, R166.2, U13.9 (-)
SUM3P: R163.2, R164.1, U13.10 (+)

Notes on the sheet:
DC coupled. Physical pin numbers; net names are global and channel-unique.
X/Y DC gain = 39k/(20k+1k); colour gain = 20k/(20k+1k). Calibrate in firmware.
A/B: unity-gain input buffers. C: matched subtractor. D: complementary driver.

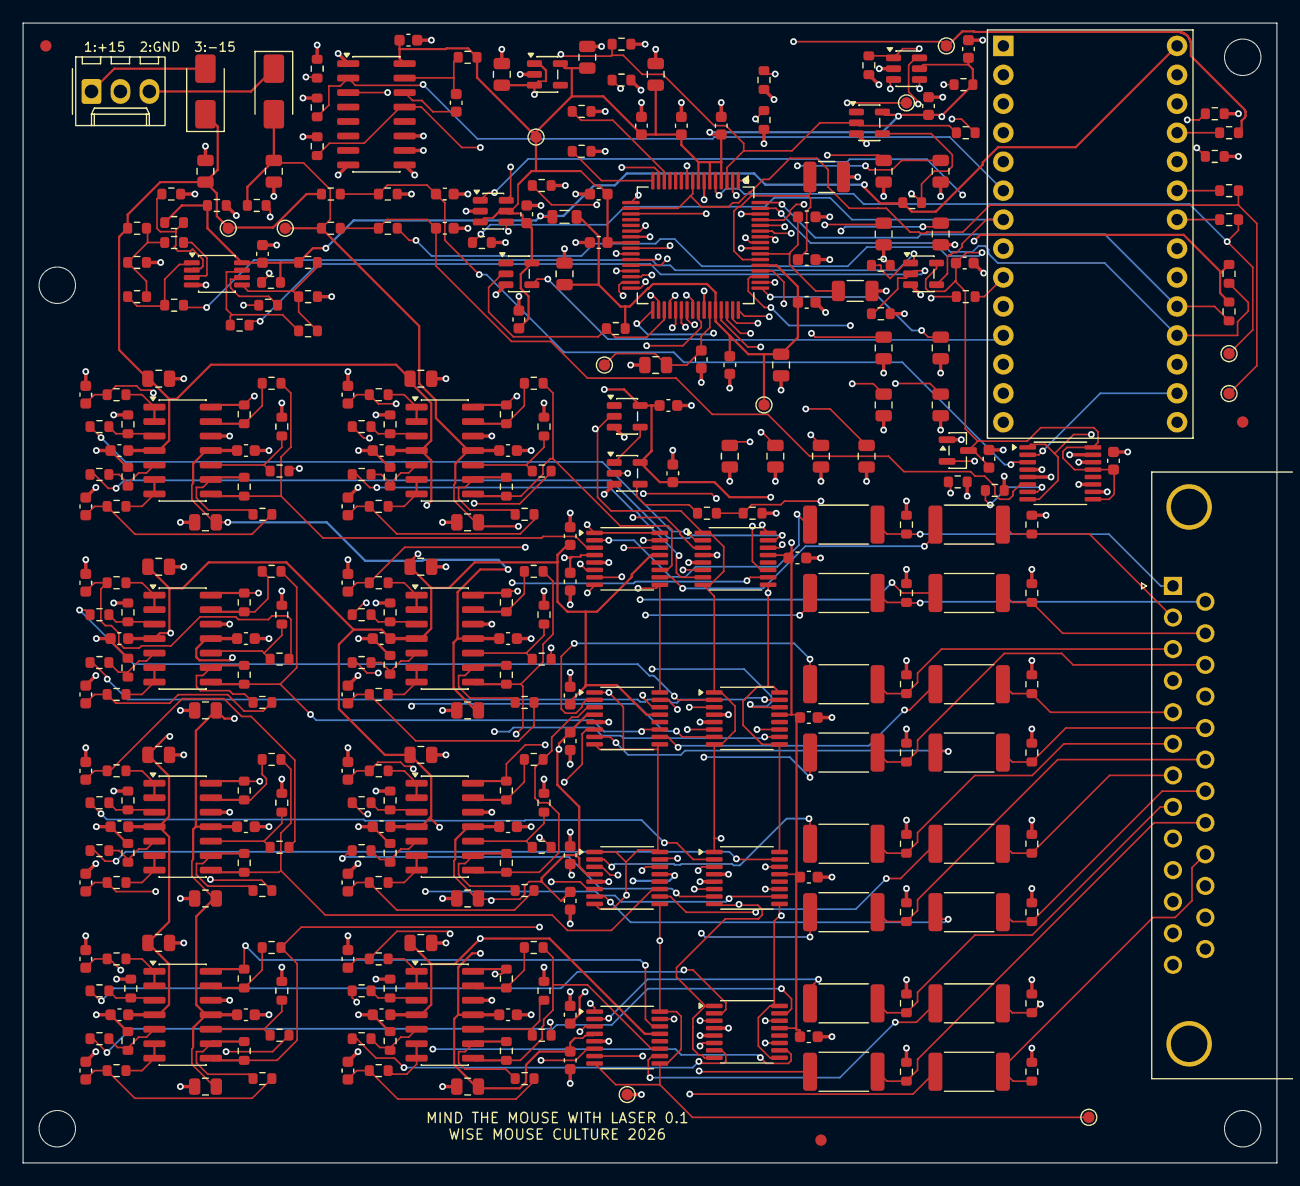
[picture p39: board ILDA8CH.kicad_pcb from above]

Board: 4 copper layers, 110.0 x 100.0 mm, 337 parts (0 on the bottom side), 225 nets.
