weiweiweiopen/teensy-4-RGBgalvos/kicad/TL072.kicad_sch

## KiCad design kicad/TL072.kicad_sch (2026-06-23)

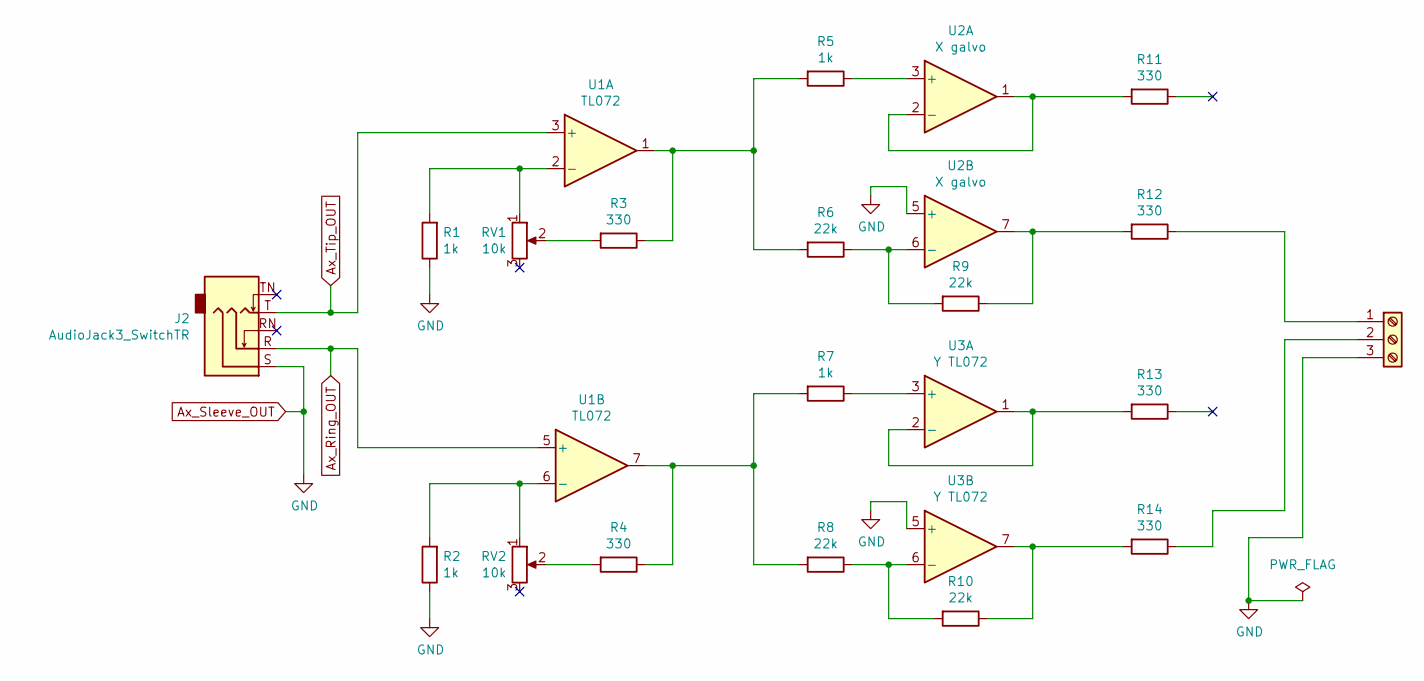
[picture p40: schematic TL072.kicad_sch]

Parts:
J2: AudioJack3_SwitchTR; Jack_3.5mm_CUI_SJ-3523-SMT_Horizontal
J3: JST_XH_B3B-XH-A_1x03_P2.50mm_Vertical
R1, R2, R5, R7: 1k; R_0603_1608Metric
R3, R4, R11, R12, R13, R14: 330; R_0603_1608Metric
R6, R8, R9, R10: 22k; R_0603_1608Metric
RV1, RV2: 10k; Potentiometer_Bourns_3386P_Vertical
U1: TL072; SOIC-8_3.9x4.9mm_P1.27mm
U2: X galvo; SOIC-8_3.9x4.9mm_P1.27mm
U3: Y TL072; SOIC-8_3.9x4.9mm_P1.27mm

Connections:
Ax_Ring_OUT: J2.R, U1.5 (+)
Ax_Sleeve_OUT: J2.S, J3.3, R1.1, R2.1, U2.5 (+), U3.5 (+)
Ax_Tip_OUT: J2.T, U1.3 (+)
unnamed: J3.1, R12.1
unnamed: J3.2, R14.1
unnamed: R1.2, RV1.1, U1.2 (-)
unnamed: R2.2, RV2.1, U1.6 (-)
unnamed: R3.1, R5.2, R6.2, U1.1
unnamed: R3.2, RV1.2
unnamed: R4.1, R7.2, R8.2, U1.7
unnamed: R4.2, RV2.2
unnamed: R5.1, U2.3 (+)
unnamed: R6.1, R9.2, U2.6 (-)
unnamed: R7.1, U3.3 (+)
unnamed: R10.1, R14.2, U3.7
unnamed: R8.1, R10.2, U3.6 (-)
unnamed: R11.2, U2.1, U2.2 (-)
unnamed: R9.1, R12.2, U2.7
unnamed: R13.2, U3.1, U3.2 (-)
