weiweiweiopen/teensy-4-RGBgalvos/kicad/teensy-4-galvos.kicad_sch

## KiCad design kicad/teensy-4-galvos.kicad_sch (2026-06-23)

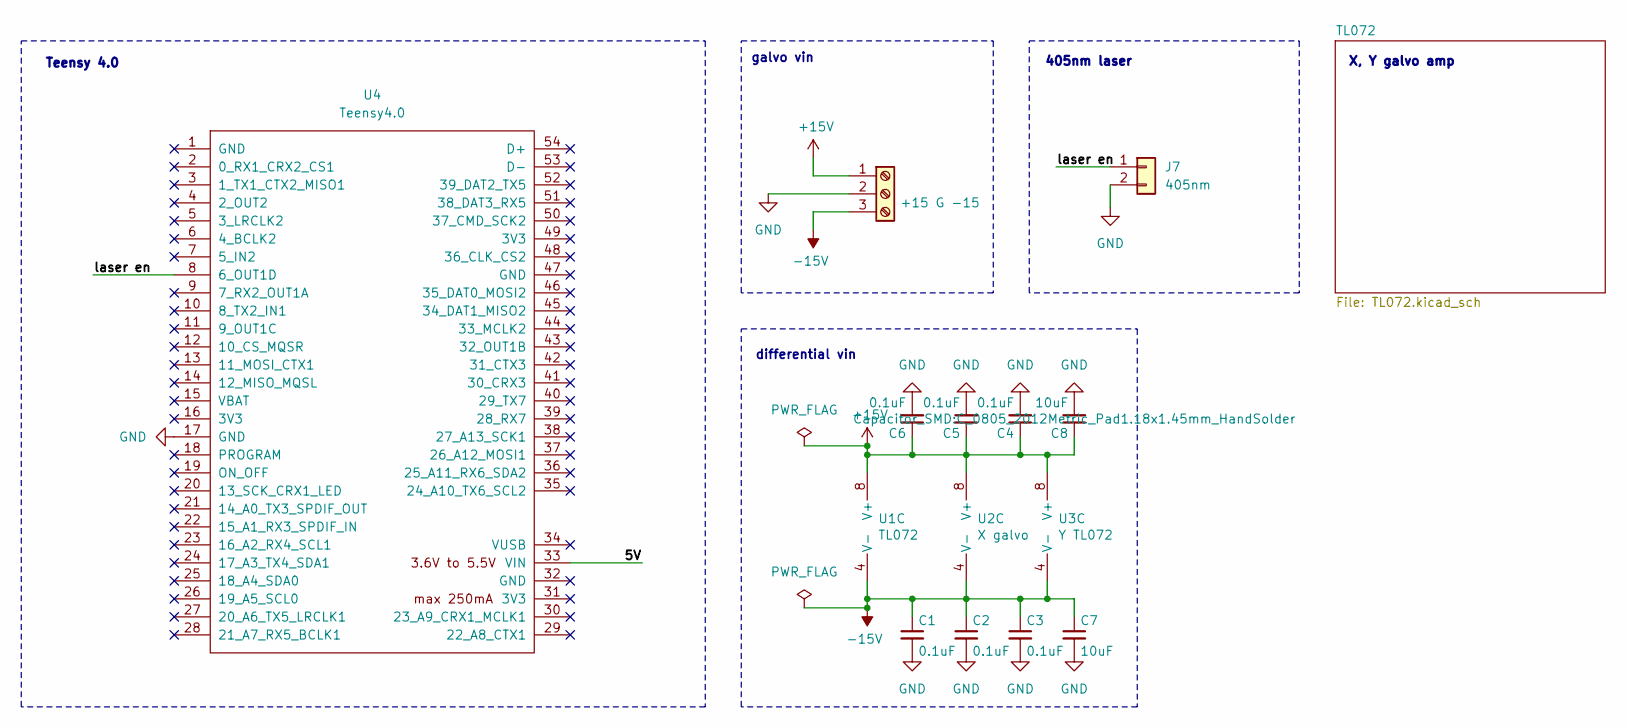
[picture p41: schematic teensy-4-galvos.kicad_sch]

Parts:
C1, C2, C3, C4, C5, C6: 0.1uF; C_0603_1608Metric_Pad1.08x0.95mm_HandSolder
C7, C8: 10uF; C_0805_2012Metric_Pad1.18x1.45mm_HandSolder
J1: +15 G -15; JST_XH_B3B-XH-A_1x03_P2.50mm_Vertical
J7: 405nm; JST_PH_B2B-PH-K_1x02_P2.00mm_Vertical
U1: TL072; SOIC-8_3.9x4.9mm_P1.27mm
U2: X galvo; SOIC-8_3.9x4.9mm_P1.27mm
U3: Y TL072; SOIC-8_3.9x4.9mm_P1.27mm
U4: Teensy4.0; Teensy40

Connections:
5V: U4.33 (VIN)
+15V: C4.1, C5.1, C6.1, C8.1, J1.1, U1.8 (V+), U2.8 (V+), U3.8 (V+)
-15V: C1.1, C2.1, C3.1, C7.1, J1.3, U1.4 (V-), U2.4 (V-), U3.4 (V-)
GND: C1.2, C2.2, C3.2, C4.2, C5.2, C6.2, C7.2, C8.2, J1.2, J7.2, U4.17 (GND)
laser en: J7.1, U4.8 (6_OUT1D)

Notes on the sheet:
X, Y galvo amp
405nm laser
Teensy 4.0
galvo vin
differential vin
