weiweiweiopen/teensy-4-RGBgalvos/(commit log)

2026-06-23 Initial public release
    [TL072.kicad_sch, teensy-4-galvos.kicad_sch]
2026-10-30 Add RevB-P4 handoff docs, firmware, and manufacturing package
    [CH1_X.kicad_sch, CH2_Y.kicad_sch, CH3_R.kicad_sch, CH4_G.kicad_sch, CH5_B.kicad_sch, CH6_I.kicad_sch, CH7_AUX1.kicad_sch, CH8_AUX2.kicad_sch]
